sergiogallegos/tinyplc/docs/wire-layouts.md

# Generated wire layout tables

Source: [`contract/wire.json`](../contract/wire.json). Do not edit this file.
See [normative semantics](wire-format.md). Offsets are bytes, little-endian.

## package

| Field | Offset | Type / bytes |
| --- | --- | --- |
| magic | 0 | u32 |
| version | 4 | u16 |
| header_bytes | 6 | u16 |
| total_bytes | 8 | u32 |
| kind | 12 | u16 |
| target | 14 | u16 |
| native_abi | 16 | u16 |
| runtime_contract | 18 | u16 |
| auth | 20 | u16 |
| flags | 22 | u16 |
| link_base | 24 | u32 |
| payload_offset | 28 | u32 |
| payload_bytes | 32 | u32 |
| text_offset | 36 | u32 |
| text_bytes | 40 | u32 |
| entry_offset | 44 | u32 |
| tags_offset | 48 | u32 |
| tag_count | 52 | u16 |
| tag_record_bytes | 54 | u16 |
| cell_bytes | 56 | u16 |
| stack_bytes | 58 | u16 |
| schema_crc | 60 | u32 |
| package_crc | 64 | u32 |
| reserved | 68 | 12 |

Fixed size: 80 bytes.

## tag

| Field | Offset | Type / bytes |
| --- | --- | --- |
| name | 0 | 32 |
| type | 32 | u8 |
| class | 33 | u8 |
| binding | 34 | u16 |
| reserved | 36 | u32 |

Fixed size: 40 bytes.

## dispatch

| Field | Offset | Type / bytes |
| --- | --- | --- |
| entry | 0 | u32 |
| tag_count | 4 | u32 |
| generation | 8 | u32 |
| reserved | 12 | u32 |

Fixed size: 16 bytes.

## frame_prefix

| Field | Offset | Type / bytes |
| --- | --- | --- |
| start | 0 | u8 |
| length | 1 | u16 |
| command | 3 | u8 |

Fixed size: 4 bytes.

## slot

| Field | Offset | Type / bytes |
| --- | --- | --- |
| base | 0 | u32 |
| capacity | 4 | u32 |
| state | 8 | u8 |
| reserved | 9 | 3 |
| generation | 12 | u32 |

Fixed size: 16 bytes.

## tag_value

| Field | Offset | Type / bytes |
| --- | --- | --- |
| name | 0 | 32 |
| type | 32 | u8 |
| class | 33 | u8 |
| binding | 34 | u16 |
| value | 36 | u32 |

Fixed size: 40 bytes.

## info_request

| Field | Offset | Type / bytes |
| --- | --- | --- |

Fixed size: 0 bytes.

## info_response

| Field | Offset | Type / bytes |
| --- | --- | --- |
| status | 0 | u8 |
| protocol | 1 | u16 |
| package_version | 3 | u16 |
| target | 5 | u16 |
| native_abi | 7 | u16 |
| runtime_contract | 9 | u16 |
| auth | 11 | u16 |
| capabilities | 13 | u32 |
| command_mask | 17 | u32 |
| package_max | 21 | u32 |
| tag_limit | 25 | u16 |
| cell_bytes | 27 | u16 |
| stack_bytes | 29 | u16 |
| reserved | 31 | u16 |
| transfer_timeout_ms | 33 | u32 |
| transfer_id | 37 | u32 |
| next_offset | 41 | u32 |
| transfer_remaining_ms | 45 | u32 |
| slot_a | 49 | 16 |
| slot_b | 65 | 16 |

Fixed size: 81 bytes.

## download_begin_request

| Field | Offset | Type / bytes |
| --- | --- | --- |
| total_bytes | 0 | u32 |

Fixed size: 4 bytes.

## download_begin_response

| Field | Offset | Type / bytes |
| --- | --- | --- |
| status | 0 | u8 |
| transfer_id | 1 | u32 |
| slot_base | 5 | u32 |
| slot_capacity | 9 | u32 |
| timeout_ms | 13 | u32 |

Fixed size: 17 bytes.

## download_chunk_request

| Field | Offset | Type / bytes |
| --- | --- | --- |
| transfer_id | 0 | u32 |
| offset | 4 | u32 |

Fixed size: 8 bytes.

## download_chunk_response

| Field | Offset | Type / bytes |
| --- | --- | --- |
| status | 0 | u8 |
| next_offset | 1 | u32 |

Fixed size: 5 bytes.

## download_end_request

| Field | Offset | Type / bytes |
| --- | --- | --- |
| transfer_id | 0 | u32 |

Fixed size: 4 bytes.

## download_end_response

| Field | Offset | Type / bytes |
| --- | --- | --- |
| status | 0 | u8 |
| candidate_generation | 1 | u32 |

Fixed size: 5 bytes.

## activate_request

| Field | Offset | Type / bytes |
| --- | --- | --- |
| candidate_generation | 0 | u32 |

Fixed size: 4 bytes.

## activate_response

| Field | Offset | Type / bytes |
| --- | --- | --- |
| status | 0 | u8 |
| accepted_generation | 1 | u32 |

Fixed size: 5 bytes.

## rollback_request

| Field | Offset | Type / bytes |
| --- | --- | --- |

Fixed size: 0 bytes.

## rollback_response

| Field | Offset | Type / bytes |
| --- | --- | --- |
| status | 0 | u8 |
| accepted_generation | 1 | u32 |

Fixed size: 5 bytes.

## read_tags_request

| Field | Offset | Type / bytes |
| --- | --- | --- |
| generation | 0 | u32 |
| snapshot_scan | 4 | u64 |
| first_index | 12 | u8 |
| count | 13 | u8 |

Fixed size: 14 bytes.

## read_tags_response

| Field | Offset | Type / bytes |
| --- | --- | --- |
| status | 0 | u8 |
| generation | 1 | u32 |
| snapshot_scan | 5 | u64 |
| first_index | 13 | u8 |
| count | 14 | u8 |
| total_count | 15 | u8 |

Fixed size: 16 bytes.

## write_tag_request

| Field | Offset | Type / bytes |
| --- | --- | --- |
| generation | 0 | u32 |
| index | 4 | u8 |
| value | 5 | u32 |

Fixed size: 9 bytes.

## write_tag_response

| Field | Offset | Type / bytes |
| --- | --- | --- |
| status | 0 | u8 |
| generation | 1 | u32 |
| apply_after_scan | 5 | u64 |

Fixed size: 13 bytes.

## get_status_request

| Field | Offset | Type / bytes |
| --- | --- | --- |

Fixed size: 0 bytes.

## get_status_response

| Field | Offset | Type / bytes |
| --- | --- | --- |
| status | 0 | u8 |
| active_generation | 1 | u32 |
| scan | 5 | u64 |
| execution | 13 | u8 |
| outcome | 14 | u8 |
| reserved | 15 | u16 |
| requested_generation | 17 | u32 |
| pending_generation | 21 | u32 |
| fault | 25 | u32 |
| last_scan_us | 29 | u32 |
| max_scan_us | 33 | u32 |
| release_jitter_us | 37 | i32 |
| missed_releases | 41 | u64 |

Fixed size: 49 bytes.

## get_update_status_request

| Field | Offset | Type / bytes |
| --- | --- | --- |

Fixed size: 0 bytes.

## get_update_status_response

| Field | Offset | Type / bytes |
| --- | --- | --- |
| status | 0 | u8 |
| kind | 1 | u8 |
| phase | 2 | u8 |
| outcome | 3 | u8 |
| reserved | 4 | u8 |
| source_generation | 5 | u32 |
| requested_generation | 9 | u32 |
| failed_generation | 13 | u32 |
| first_fault | 17 | u32 |
| recovery_fault | 21 | u32 |
| line | 25 | u32 |
| column | 29 | u32 |
| failed_scan | 33 | u64 |
| completed_generation | 41 | u32 |
| completed_scan | 45 | u64 |

Fixed size: 53 bytes.

## Numeric constants

| Name | Value |
| --- | --- |
| PACKAGE_MAGIC | 1313034324 |
| PACKAGE_VERSION | 1 |
| IMAGE_NATIVE | 1 |
| TARGET_F446 | 1 |
| NATIVE_ABI | 2 |
| RUNTIME_CONTRACT | 1 |
| AUTH_UNSIGNED_LAB | 0 |
| SLOT_A_BASE | 536936448 |
| SLOT_B_BASE | 536952832 |
| CODE_CAPACITY | 16384 |
| TAG_LIMIT | 64 |
| CELL_BYTES | 4 |
| WORKER_STACK_BYTES | 2048 |
| TYPE_BOOL | 1 |
| TYPE_DINT | 2 |
| CLASS_INPUT | 1 |
| CLASS_OUTPUT | 2 |
| CLASS_VAR | 3 |
| BINDING_NONE | 0 |
| BINDING_BTN_PC13 | 1 |
| BINDING_LED_PA5 | 2 |
| FRAME_START | 165 |
| PROTOCOL_VERSION | 1 |
| FRAME_LENGTH_MIN | 1 |
| FRAME_LENGTH_MAX | 257 |
| FRAME_BYTES_MAX | 262 |
| CHUNK_BYTES_MAX | 240 |
| TAG_PAGE_LIMIT | 5 |
| FRAME_TIMEOUT_MS | 100 |
| TRANSFER_TIMEOUT_MS | 30000 |
| SNAPSHOT_TIMEOUT_MS | 2000 |
| RESPONSE_BIT | 128 |
| DISPATCH_INPUT_OFFSET | 256 |
| SLOT_EMPTY | 0 |
| SLOT_ACTIVE | 1 |
| SLOT_RECEIVING | 2 |
| SLOT_READY | 3 |
| SLOT_PENDING | 4 |
| SLOT_PREVIOUS | 5 |
| EXEC_STOPPED | 0 |
| EXEC_RUNNING | 1 |
| EXEC_FAULT | 2 |
| OUTCOME_NONE | 0 |
| OUTCOME_PENDING | 1 |
| OUTCOME_RUNNING | 2 |
| OUTCOME_REJECTED | 3 |
| OUTCOME_ROLLED_BACK | 4 |
| CAP_UNSIGNED_LAB | 1 |
| CAP_ONLINE_MIGRATION | 2 |
| CAP_ROLLBACK | 4 |
| CAP_WRITE_TAG | 8 |
| STATUS_OK | 0 |
| STATUS_BAD_REQUEST | 1 |
| STATUS_CRC_ERROR | 2 |
| STATUS_BUSY | 3 |
| STATUS_INVALID_IMAGE | 4 |
| STATUS_NO_PROGRAM | 5 |
| STATUS_NOT_WRITABLE | 6 |
| STATUS_FAULT | 7 |
| STATUS_UNSUPPORTED | 8 |
| CMD_INFO | 1 |
| CMD_DOWNLOAD_BEGIN | 2 |
| CMD_DOWNLOAD_CHUNK | 3 |
| CMD_DOWNLOAD_END | 4 |
| CMD_ACTIVATE | 5 |
| CMD_ROLLBACK | 6 |
| CMD_READ_TAGS | 7 |
| CMD_WRITE_TAG | 8 |
| CMD_GET_STATUS | 9 |
| PACKAGE_BYTES_MAX | 19024 |
| CRC32_POLY_REFLECTED | 3988292384 |
| CRC32_INIT | 4294967295 |
| CRC32_XOROUT | 4294967295 |
| CRC32_CHECK | 3421780262 |
| CRC16_POLY | 4129 |
| CRC16_INIT | 65535 |
| CRC16_XOROUT | 0 |
| CRC16_CHECK | 10673 |
| CMD_GET_UPDATE_STATUS | 10 |
| UPDATE_NONE | 0 |
| UPDATE_ACTIVATE | 1 |
| UPDATE_ROLLBACK | 2 |
| UPDATE_IDLE | 0 |
| UPDATE_QUEUED | 1 |
| UPDATE_TRIAL | 2 |
| UPDATE_RECOVERY_QUEUED | 3 |
| UPDATE_RECOVERY_TRIAL | 4 |
| UPDATE_COMPLETE | 5 |
| TYPE_TIME | 3 |
| CLASS_TIMER | 4 |
| BINDING_CLOCK_MS | 3 |
