sergiogallegos/tinyplc/hardware/prototype-a1/brochure/tinyplc-a1-brochure.pdf

Small controller.
Open to exploration.

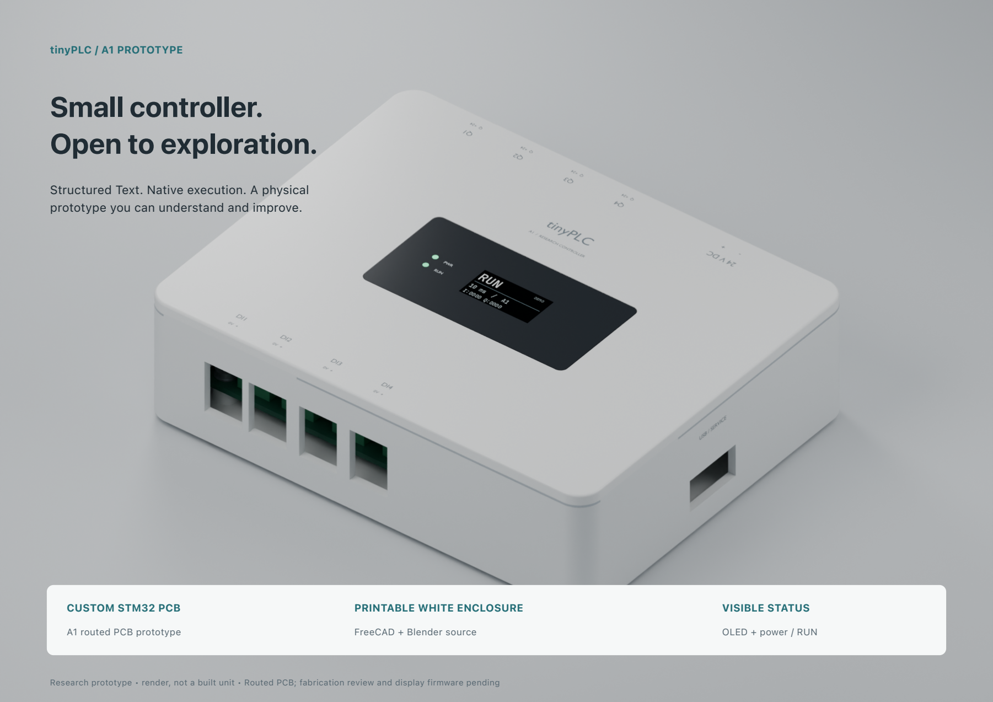
[picture p3: page 1]

tinyPLC / A1

A1 prototype • CAD renders • not a fabrication release • 2026-10-24 | 01

tinyPLC / A1 PROTOTYPE

### Structured Text. Native execution. A physical

prototype you can understand and improve.

CUSTOM STM32 PCB | PRINTABLE WHITE ENCLOSURE | VISIBLE STATUS
A1 routed PCB prototype | FreeCAD + Blender source | OLED + power / RUN

Research prototype • render, not a built unit • Routed PCB; fabrication review and display firmware pending

DESIGN / SOFT GEOMETRY, CLEAR PURPOSE
A quieter industrial object.

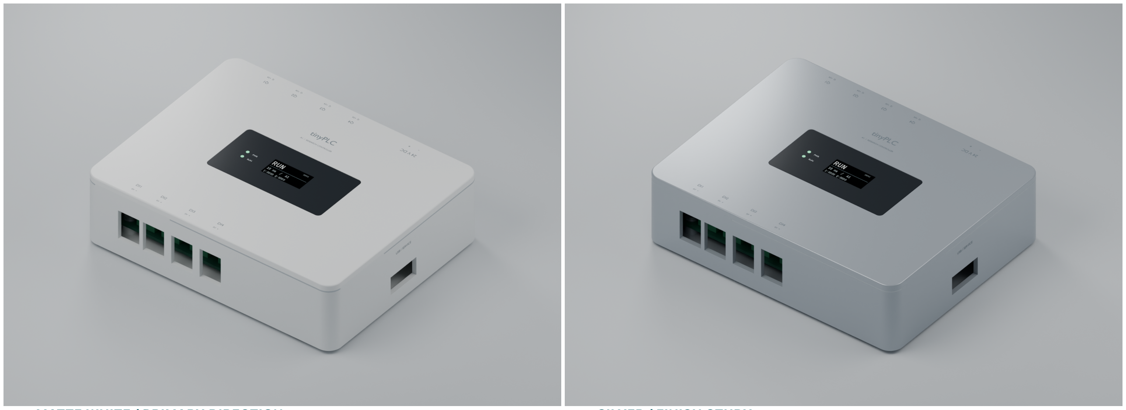
[picture p4: figure]

A1 prototype • CAD renders • not a fabrication release • 2026-10-24 | 02

A rounded white shell, a restrained black interface and a narrow silver seam. The prototype is designed to be pleasant on a desk and practical to open.

MATTE WHITE / PRIMARY DIRECTION | SILVER / FINISH STUDY
Printed polymer. 140 × 110 × 37 mm before feet and switch projection. Soft corners and a clean top surface. | The same geometry with a silver-colored finish. This is not a machined aluminum enclosure or grounded metal chassis.

INTERFACE / SMALL DISPLAY, USEFUL SIGNALS
Understand the state at a glance.

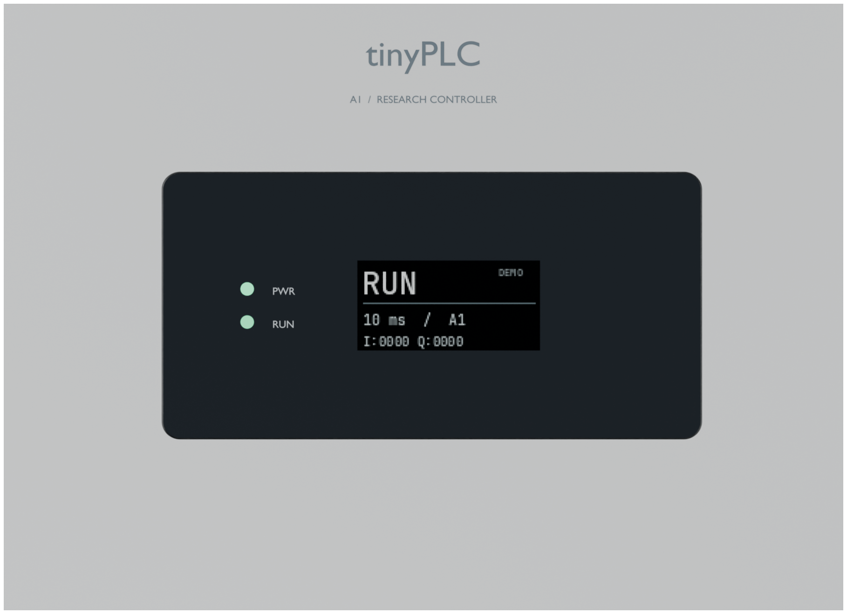
[picture p5: figure]

A1 prototype • CAD renders • not a fabrication release • 2026-10-24 | 03

### PWR

A hardware LED follows the 3.3 V rail, independently of firmware.

### RUN

A proposed heartbeat follows accepted scan progress. A live UI task alone must not assert RUN.

### OLED

128 × 64 monochrome status: RUN, STOP or FAULT, scan period and an I/O snapshot.

The screen is deliberately small and non-touch. The displayed DEMO content is a UI proposal; the A1 OLED driver and status integration still need implementation.

CONNECTIONS / LABELS THAT FOLLOW THE SCHEMATIC
Power is explicit. Wiring stays legible.

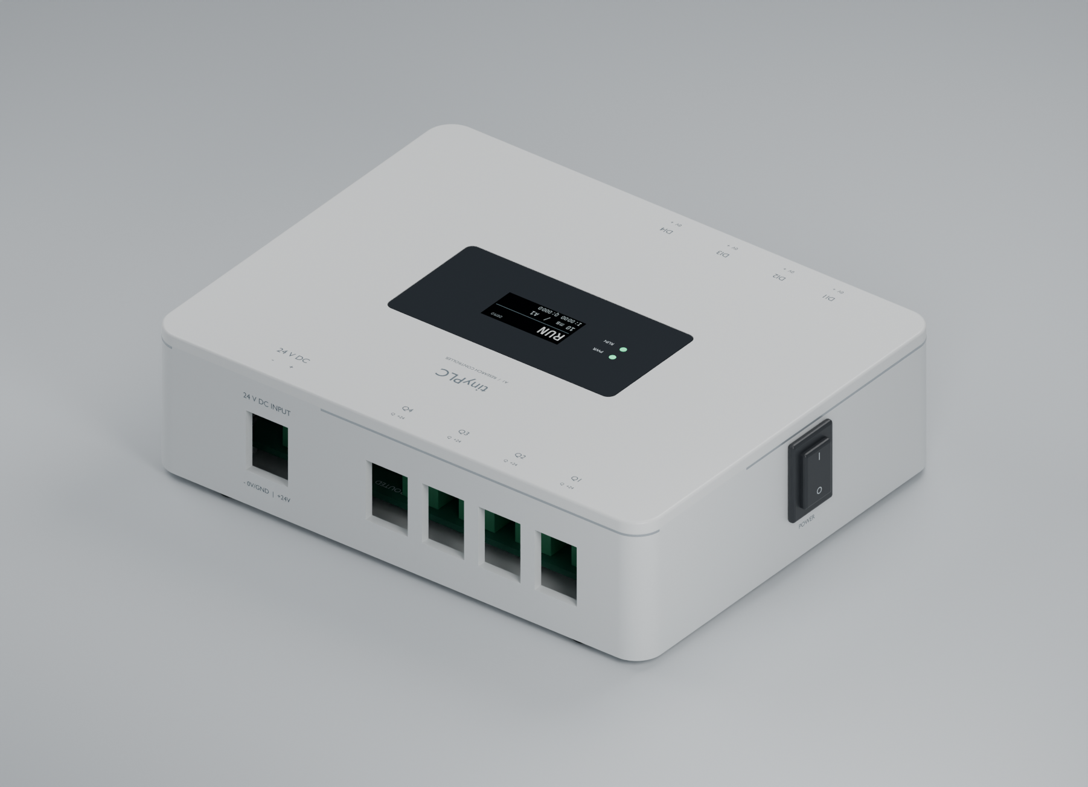
[picture p6: figure]

A1 prototype • CAD renders • not a fabrication release • 2026-10-24 | 04

### 24 V DC INPUT

J1.1: +24 V. J1.2: 0 V / GND (−). GND is the circuit return, not protective earth.

### PHYSICAL ON / OFF

A maintained side rocker opens the fused positive feed to the controller and output bus.

### FOUR IN / FOUR OUT

Four conditioned input channels and four sinking output channels. Electrical ratings remain test targets.

USB is a service/data connection, not the supply. The shared-ground board is not isolated. OFF is not an all-signal disconnect; remove external sources before servicing.

HARDWARE / STM32F446 CONTROLLER ARCHITECTURE
One custom board. Clear responsibilities.

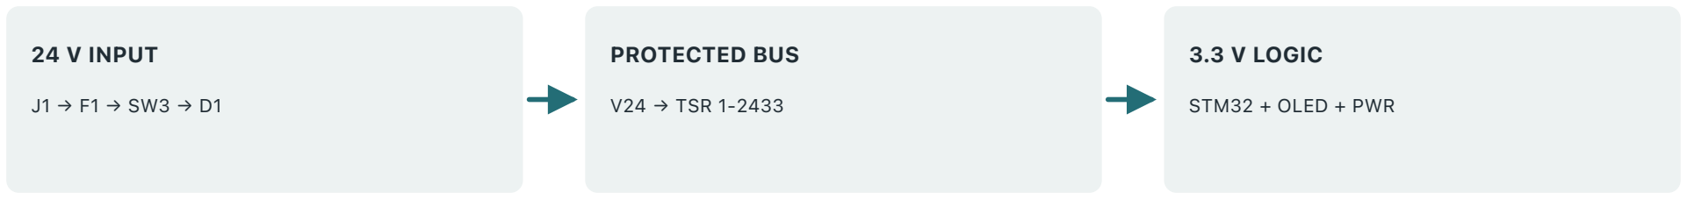
[picture p7: figure]
24 V INPUT; PROTECTED BUS; V24 → TSR 1-2433; 3.3 V LOGIC; STM32 + OLED + PWR
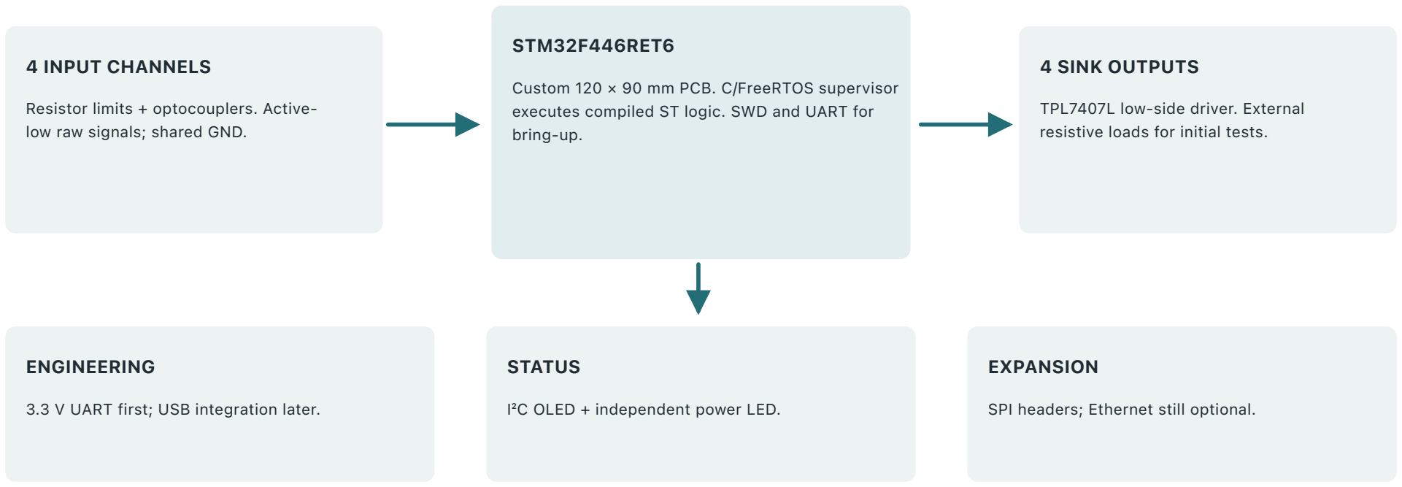
[picture p8: figure]
4 INPUT CHANNELS; Resistor limits + optocouplers. Active- low raw signals; shared GND.; STM32F446RET6; bring-up.; 4 SINK OUTPUTS; TPL7407L low-side driver. External resistive loads for initial tests.; ENGINEERING; STATUS; I²C OLED + independent power LED.; EXPANSION; SPI headers; Ethernet still optional.

A1 prototype • CAD renders • not a fabrication release • 2026-10-24 | 05

Custom 120 × 90 mm PCB. C/FreeRTOS supervisor executes compiled ST logic. SWD and UART for

3.3 V UART first; USB integration later.

Block diagram describes the intended A1 hardware. PCB routing is complete; manufacturing release and hardware qualification remain pending.

SOFTWARE / STRUCTURED TEXT TO NATIVE ARM CODE
Compile on the PC. Execute on the controller.

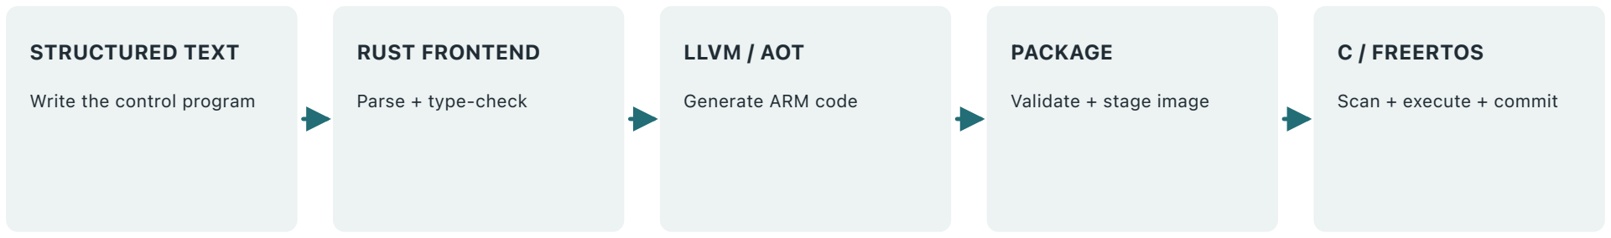
[picture p9: figure]
STRUCTURED TEXT; Write the control program; RUST FRONTEND; Parse + type-check; LLVM / AOT; Generate ARM code; PACKAGE; Validate + stage image; C / FREERTOS; Scan + execute + commit

A1 prototype • CAD renders • not a fabrication release • 2026-10-24 | 06

### IMPLEMENTED ON THE NUCLEO BASELINE

Native execution, serial download and explicit activation; coherent monitoring; compatible state migration, trial and rollback; TON on-delay timers.

### A1 INTEGRATION STILL TO DO

Standalone clock and pin setup, four-channel I/O validation, OLED driver and heartbeat ownership. Native USB and Ethernet are not ready-to-use A1 features.

The supervisor owns physical I/O and fault handling. User logic runs in a restricted native worker. The UI must consume snapshots at lower priority, with bounded I²C transactions.

Target scan period: 10 ms. Existing measured evidence is for NUCLEO-F446RE; A1 timing must be measured separately.

BUILD / INSPECT, PRINT, ASSEMBLE, ITERATE
The files are part of the product.

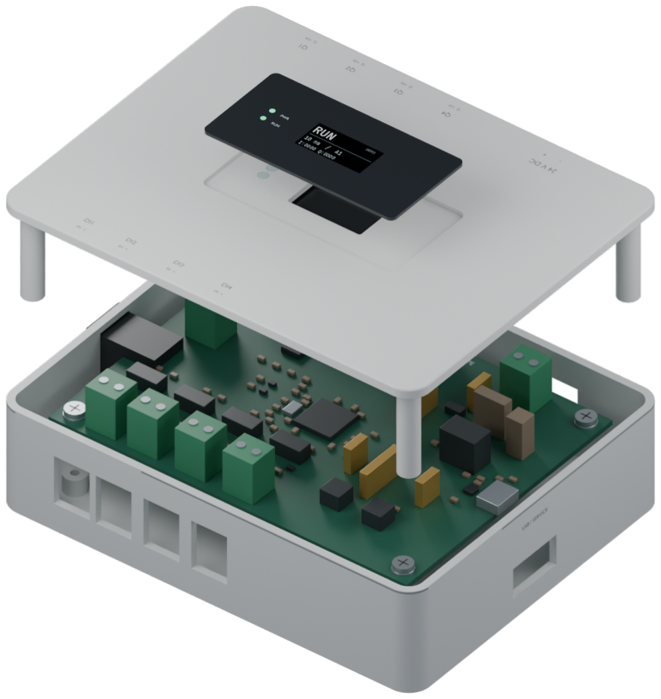
[picture p10: figure]

A1 prototype • CAD renders • not a fabrication release • 2026-10-24 | 07

### 01 / INSPECT

KiCad schematic, custom PCB, per-item BOM and design decisions explain the electronics.

### 02 / PRINT + FIT

FreeCAD, STEP and oriented STLs provide the shell, display mount, optical sleeves and
fit coupon.

### 03 / ASSEMBLE

Illustrated instructions, dimensioned drawings, label artwork and harness mappings keep the build traceable.

Every product view in this brochure comes from the editable Blender scene built from the CAD geometry. Package bodies and switch details are simplified envelopes.

READINESS / WHAT YOU CAN CONSTRUCT TODAY
A prototype with a clear next step.

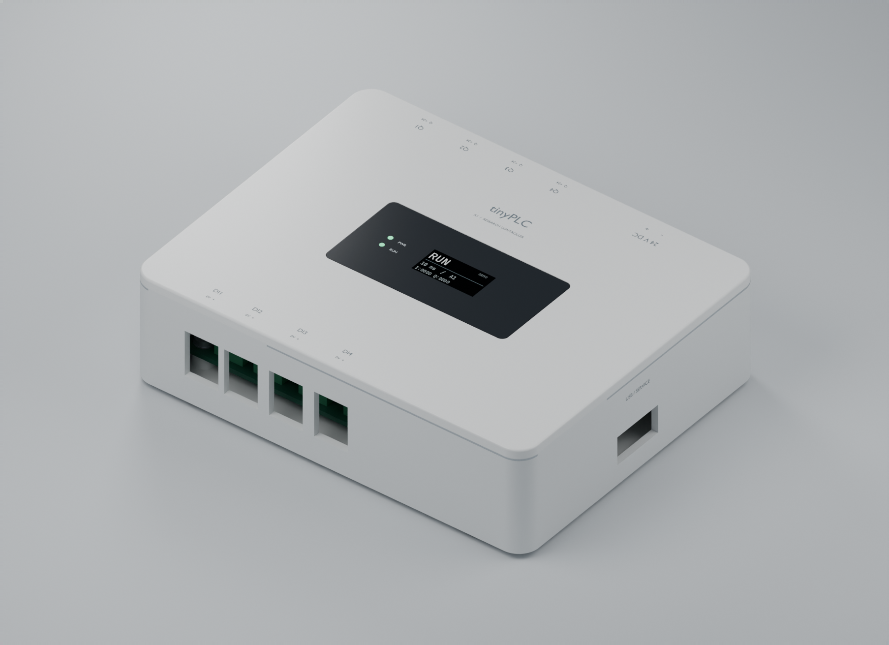
[picture p11: figure]

A1 prototype • CAD renders • not a fabrication release • 2026-10-24 | 08

### READY TO EXPLORE

Inspect the custom board and schematic. Print the coupon and case for fit trials. Try the compiler, host simulation and documented Nucleo workflow. Review the proposed OLED interface.

### BEFORE BOARD ORDER

Review the routed PCB. Resolve exact capacitor and hardware SKUs. Review power, I/O, ground returns and fabrication constraints. Inspect manufacturing outputs independently.

### BEFORE A WORKING A1

Build and test the board in stages. Port the firmware. Integrate the OLED and status logic. Validate switch wiring, optical alignment, thermal behavior and physical outputs.

## Start with hardware/prototype-a1/README.md

It links the native CAD, BOM, assembly guide, construction drawings, design rationale and this brochure. A0 remains available for comparison.

Research and education only. No certified machine-control or safety use. Downloaded programs currently do not persist across reset.

github.com/sergiogallegos/tinyplc
