sergiogallegos/tinyplc/hardware/prototype-a1/mechanical/drawings/05-applied-labels.pdf

CONSTRUCTION / A1 / mm / ACTUAL SIZE A4 / CAD FIT ONLY

# 05 Applied label master / front-view orientation

A1 prototype • CAD renders • not a fabrication release • 2026-10-24 | 05

100 mm — verify printed scale

## tinyPLC

A1 / RESEARCH CONTROLLER

DI1

0V +

DI2

0V +

DI3

0V +

DI4

0V +

Outline is an alignment reference, not part of the label.

Separate side labels below. No protective-earth symbol: 0 V/GND is the shared DC return, not PE.

24 V DC INPUT

− 0V/GND | +24V

USB / SERVICE

POWER

The lens mask is a separate 64 × 32 mm SVG. Mask artwork is a front view: reverse/mirror for reverse-side printing, keeping viewing windows clear.
