sergiogallegos/tinyplc/hardware/prototype-a/mechanical/drawings/assembly-pages/03-hardware.pdf

tinyPLC / A0 VISUAL ASSEMBLY | INVENTORY / NOMINAL HARDWARE

# Sort the screws before you start

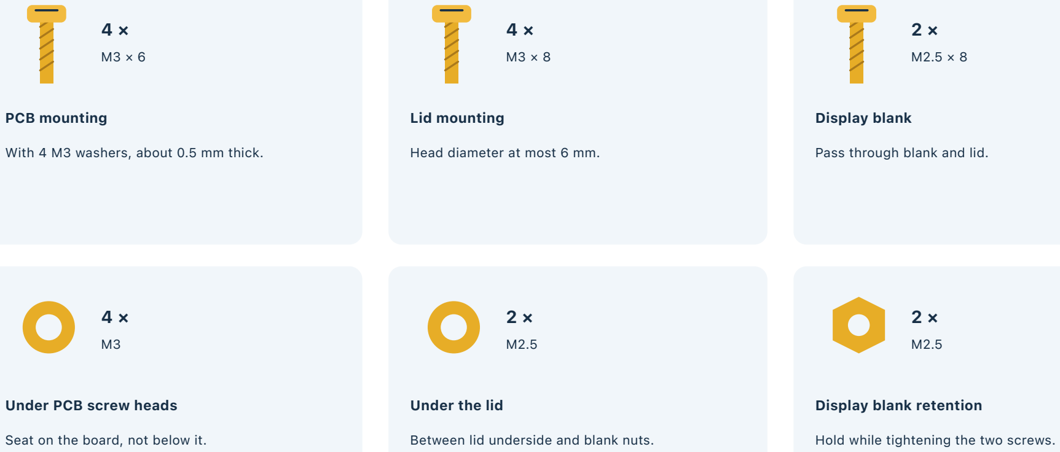
[picture p12: figure]
PCB mounting; With 4 M3 washers, about 0.5 mm thick.; Lid mounting; Head diameter at most 6 mm.; Display blank; Pass through blank and lid.; Under PCB screw heads; Seat on the board, not below it.; Under the lid; Between lid underside and blank nuts.; Display blank retention; Hold while tightening the two screws.

A0 • CAD illustrations, not assembly photos • physical fit untested • images not to scale | 03

Tools: ruler, deburring tool, M3 × 0.5 hand tap, suitable hand screwdriver and a small nut driver. Confirm actual screw drawings and fit on the coupon; no tightening torque is qualified.
