sergiogallegos/tinyplc/hardware/prototype-a1/electronics/archive-unrouted/README.md

# Historical A1 placement snapshot

These files preserve the earlier unrouted draft, including its missing DI1-to-PA0
connection. They are not current build files. The corrected, routed project is
one directory above. Library snapshots are in that parent directory.
