sergiogallegos/tinyplc/hardware/prototype-a1/renders/exploded.png

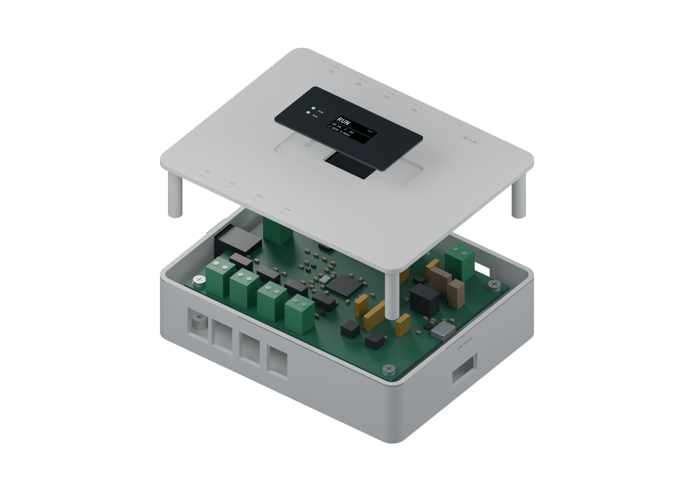
hardware/prototype-a1/renders/exploded.png
