sergiogallegos/tinyplc/hardware/prototype-a1/renders/fault-detail.png

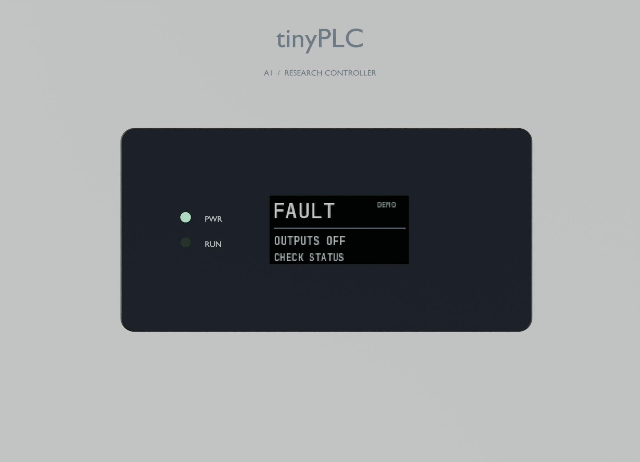
hardware/prototype-a1/renders/fault-detail.png
