sergiogallegos/tinyplc/hardware/prototype-a1/renders/hero-silver.png

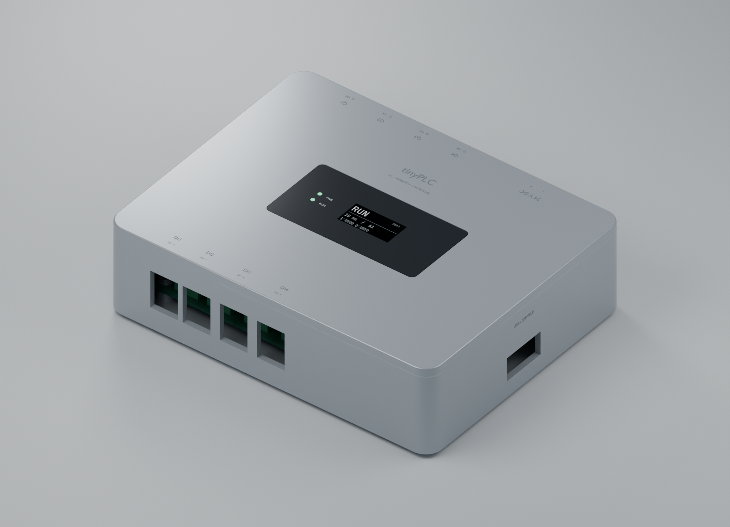
hardware/prototype-a1/renders/hero-silver.png
