sergiogallegos/tinyplc/hardware/prototype-a1/renders/pcb-routed-bottom.png

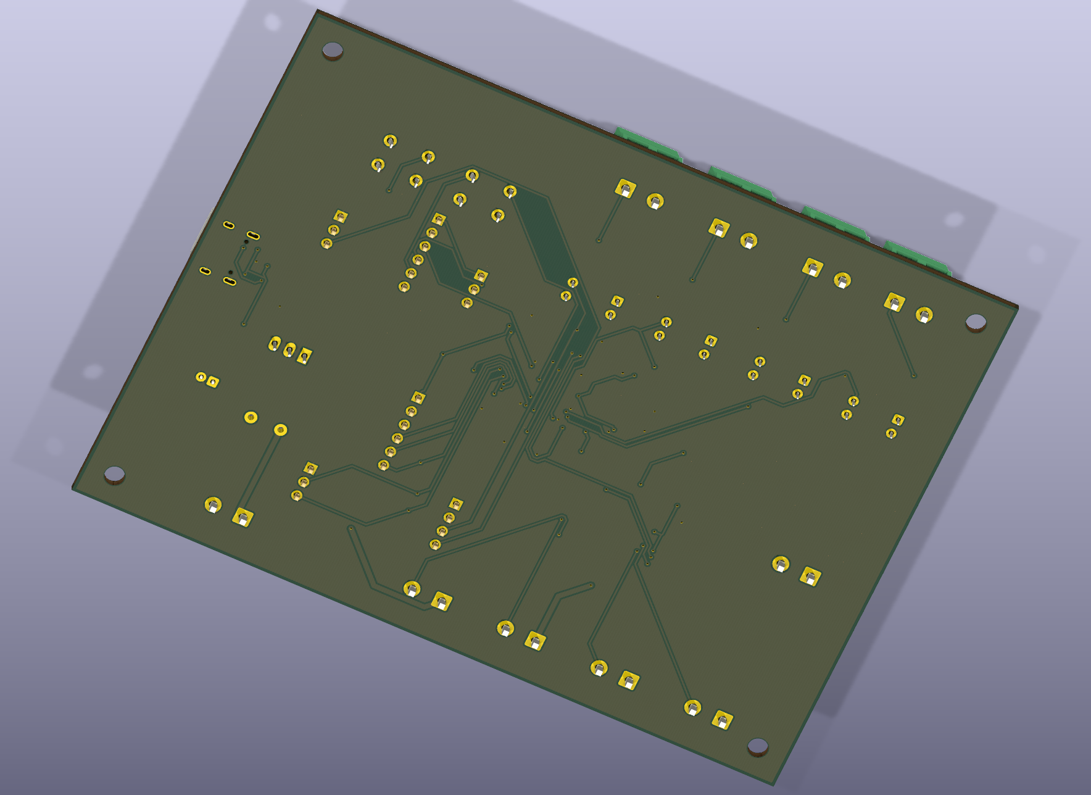
hardware/prototype-a1/renders/pcb-routed-bottom.png
