sergiogallegos/tinyplc/hardware/prototype-a1/renders/underside.png

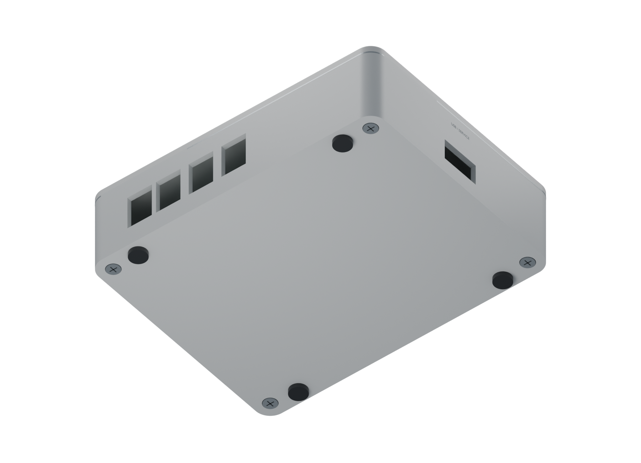
hardware/prototype-a1/renders/underside.png
