sergiogallegos/tinyplc/hardware/prototype-a/renders/assembly/00-overview.png

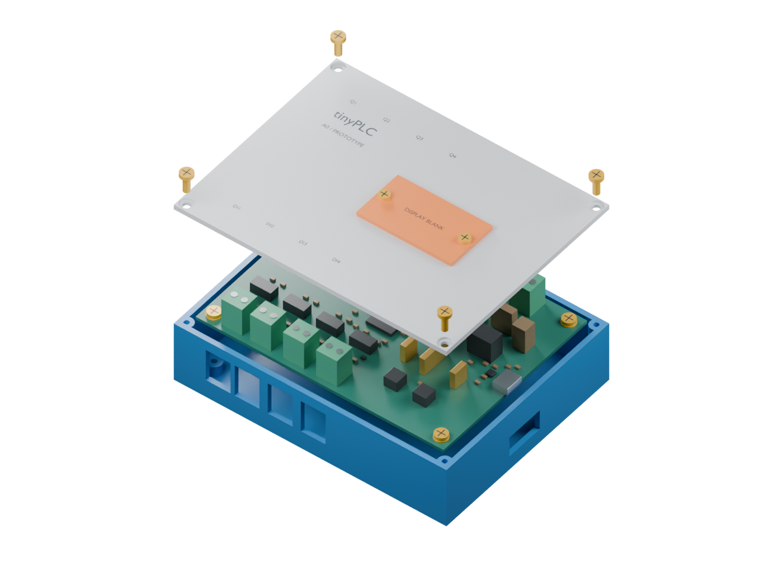
hardware/prototype-a/renders/assembly/00-overview.png
