sergiogallegos/tinyplc/hardware/prototype-a/renders/tinyplc-a0-exploded.png

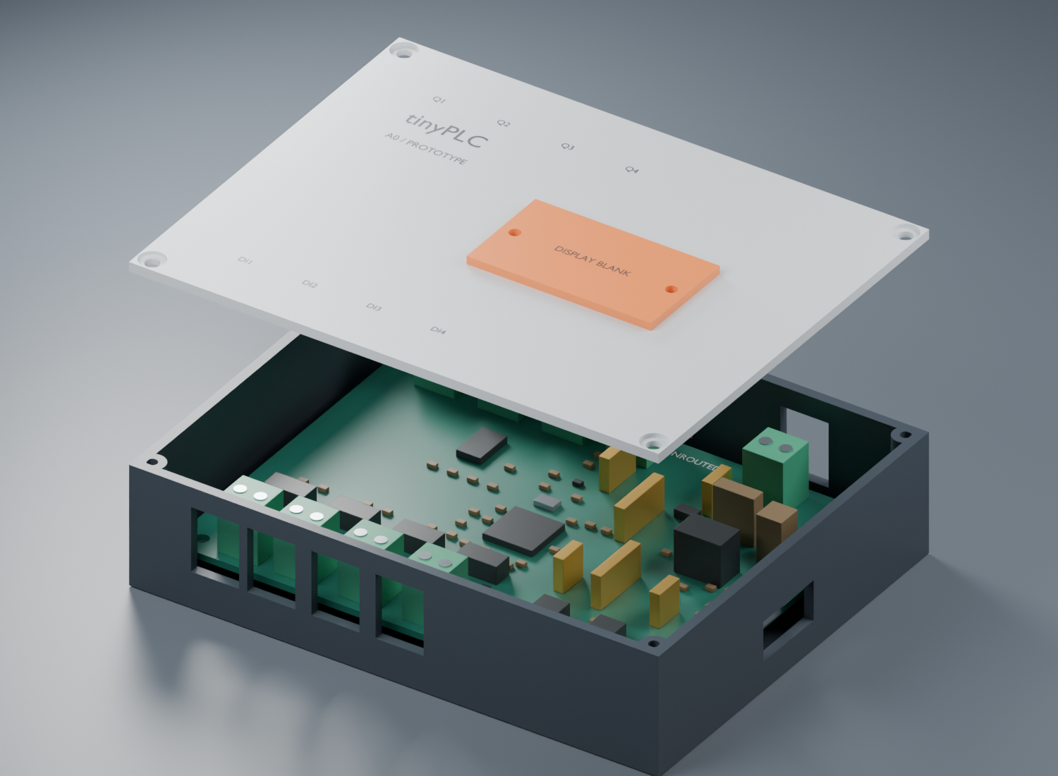
hardware/prototype-a/renders/tinyplc-a0-exploded.png
