sergiogallegos/tinyplc/hardware/prototype-a/mechanical/drawings/assembly-pages/02-large-parts.pdf

tinyPLC / A0 VISUAL ASSEMBLY | INVENTORY / MATCH THE A0 REVISION

# Lay out the large parts

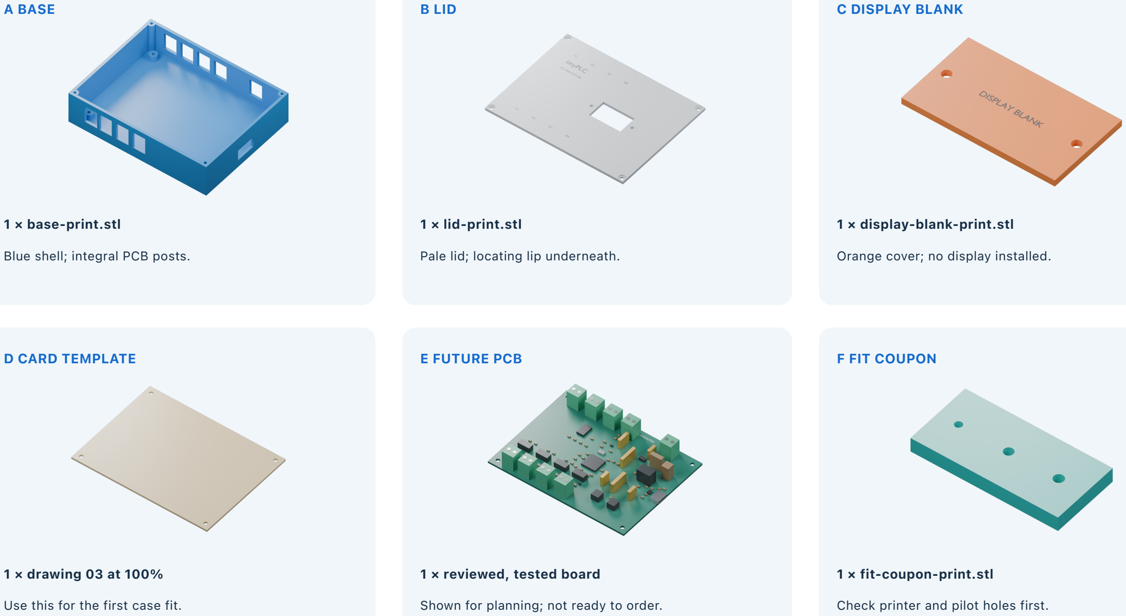
[picture p20: figure]
A BASE; 1 × base-print.stl; Blue shell; integral PCB posts.; B LID; 1 × lid-print.stl; Pale lid; locating lip underneath.; C DISPLAY BLANK; 1 × display-blank-print.stl; Orange cover; no display installed.; D CARD TEMPLATE; 1 × drawing 03 at 100%; Use this for the first case fit.; E FUTURE PCB; 1 × reviewed, tested board; Shown for planning; not ready to order.; F FIT COUPON; 1 × fit-coupon-print.stl; Check printer and pilot holes first.

A0 • CAD illustrations, not assembly photos • physical fit untested • images not to scale | 02
