sergiogallegos/tinyplc/hardware/prototype-a1/mechanical/drawings/assembly-pages/02-inventory.pdf

INVENTORY / USE THE MATCHING A1 BOM
Lay out the parts.
A1 prototype • CAD renders • not a fabrication release • 2026-10-24 | 02

### Printed parts

1 base + 1 lid + 1 fit coupon. Print STLs already have bed orientation.

### Board retention

4 × M3 × 6 screws; 4 × M3 washers, nominal 0.5 mm thick.

### Case retention

4 × M3 × 10 screws from below; 4 adhesive feet, nominal 8 × 2 mm.

### Status optics

1 lens, 64 × 32 × 1; reverse black mask; 2 clear Ø3 × 24.6 rods.

### OLED module

1 Adafruit 326 QT; 4 × M2 × 6 screws; 4 × M2 washers; 1 four-wire harness.

### Power switch

1 C&K D102J12S215HQA candidate; 2 insulated leads with matching quick-connects.

Prepare a ruler, suitable hand screwdriver, M3/M2 taps, crimp tool and multimeter. Try actual hardware on the coupon before printing the whole case.
