sergiogallegos/tinyplc/hardware/prototype-a/bom/electronics.csv

quantity | ref | value | mpn | footprint | group | purpose | official_document | status
1 | J1 | 24V IN / GND | 1715721 | tinyplc:TerminalBlock_Phoenix_MKDS-1,5-2-5.08_1x02_P5.08mm_Horizontal | Power | 24V IN / GND | https://www.phoenixcontact.com/en-us/products/pcb-terminal-block-mkds-15-2-508-1715721 | candidate; verify before purchase
1 | F1 | 500mA / 60V | MF-R050 | tinyplc:PTC_MF_R050 | Power | Resettable input fuse; slow overload protection | https://www.bourns.com/docs/product-datasheets/mf-r.pdf | candidate; verify before purchase
1 | D1 | SS16 | SS16 | tinyplc:D_SMA | Power | Series reverse-polarity diode | https://www.diodes.com/datasheet/download/ds13003.pdf | candidate; verify before purchase
1 | U2 | TSR 1-2433 | TSR 1-2433 | tinyplc:Converter_DCDC_TRACO_TSR-1_THT | Power | 24 V to 3.3 V switching supply | https://www.tracopower.com/tsr1-datasheet | candidate; verify before purchase
1 | C1 | 22uF / 50V | Panasonic EEU-FR1H220 | tinyplc:CP_Radial_D6.3mm_P2.50mm | Power | Input reservoir; polarity matters | https://industrial.panasonic.com/cdbs/www-data/pdf/RDF0000/ABA0000C1015.pdf | candidate; verify before purchase
1 | C2 | 100nF / 50V | TDK C2012 family; exact MPN pending | tinyplc:C_0805_2012Metric | Power | High-frequency input bypass | https://product.tdk.com/en/products/capacitor/ceramic/mlcc/characteristic/ | specification only; exact MPN pending
1 | C3 | 10uF / 10V | TDK C2012 family; exact MPN pending | tinyplc:C_0805_2012Metric | Power | 3V3 reservoir | https://product.tdk.com/en/products/capacitor/ceramic/mlcc/characteristic/ | specification only; exact MPN pending
1 | U1 | STM32F446RET6 | STM32F446RET6 | tinyplc:LQFP-64_10x10mm_P0.5mm | MCU | Native ST processor; internal regulator ON | https://www.st.com/resource/en/datasheet/stm32f446re.pdf | candidate; verify before purchase
1 | C4 | 100nF / 50V | TDK C2012 family; exact MPN pending | tinyplc:C_0805_2012Metric | MCU | One local bypass per VDD pin | https://product.tdk.com/en/products/capacitor/ceramic/mlcc/characteristic/ | specification only; exact MPN pending
1 | C5 | 100nF / 50V | TDK C2012 family; exact MPN pending | tinyplc:C_0805_2012Metric | MCU | One local bypass per VDD pin | https://product.tdk.com/en/products/capacitor/ceramic/mlcc/characteristic/ | specification only; exact MPN pending
1 | C6 | 100nF / 50V | TDK C2012 family; exact MPN pending | tinyplc:C_0805_2012Metric | MCU | One local bypass per VDD pin | https://product.tdk.com/en/products/capacitor/ceramic/mlcc/characteristic/ | specification only; exact MPN pending
1 | C7 | 100nF / 50V | TDK C2012 family; exact MPN pending | tinyplc:C_0805_2012Metric | MCU | One local bypass per VDD pin | https://product.tdk.com/en/products/capacitor/ceramic/mlcc/characteristic/ | specification only; exact MPN pending
1 | C8 | 4.7uF / 10V | TDK C2012 family; exact MPN pending | tinyplc:C_0805_2012Metric | MCU | Single VCAP package requires 4.7uF low ESR; never a power output | https://product.tdk.com/en/products/capacitor/ceramic/mlcc/characteristic/ | specification only; exact MPN pending
1 | C9 | 4.7uF / 10V | TDK C2012 family; exact MPN pending | tinyplc:C_0805_2012Metric | MCU | MCU local bulk capacitance | https://product.tdk.com/en/products/capacitor/ceramic/mlcc/characteristic/ | specification only; exact MPN pending
1 | R1 | 22 | ERJ-6ENF22R0V | tinyplc:R_0805_2012Metric | MCU | Analog supply RC filter; verify VDDA drop | https://industrial.panasonic.com/cdbs/www-data/pdf/RDA0000/AOA0000C307.pdf | candidate; verify before purchase
1 | C10 | 100nF / 50V | TDK C2012 family; exact MPN pending | tinyplc:C_0805_2012Metric | MCU | VDDA high-frequency bypass | https://product.tdk.com/en/products/capacitor/ceramic/mlcc/characteristic/ | specification only; exact MPN pending
1 | C11 | 1uF / 10V | TDK C2012 family; exact MPN pending | tinyplc:C_0805_2012Metric | MCU | VDDA low-frequency bypass | https://product.tdk.com/en/products/capacitor/ceramic/mlcc/characteristic/ | specification only; exact MPN pending
1 | R2 | 10k | ERJ-6ENF1002V | tinyplc:R_0805_2012Metric | MCU | Reset pull-up | https://industrial.panasonic.com/cdbs/www-data/pdf/RDA0000/AOA0000C307.pdf | candidate; verify before purchase
1 | C12 | 100nF / 50V | TDK C2012 family; exact MPN pending | tinyplc:C_0805_2012Metric | MCU | Reset noise filter | https://product.tdk.com/en/products/capacitor/ceramic/mlcc/characteristic/ | specification only; exact MPN pending
1 | R3 | 10k | ERJ-6ENF1002V | tinyplc:R_0805_2012Metric | MCU | Normal boot from user flash | https://industrial.panasonic.com/cdbs/www-data/pdf/RDA0000/AOA0000C307.pdf | candidate; verify before purchase
1 | R4 | 10k | ERJ-6ENF1002V | tinyplc:R_0805_2012Metric | MCU | Bootloader mode selection pull-down | https://industrial.panasonic.com/cdbs/www-data/pdf/RDA0000/AOA0000C307.pdf | candidate; verify before purchase
1 | J2 | BOOT: 1=3V3 2=BOOT0 3=GND | Samtec TSW-103-07-G-S | tinyplc:PinHeader_1x03_P2.54mm_Vertical | MCU | Momentary shunt 1-2 only for ROM recovery | https://www.samtec.com/products/tsw | candidate; verify before purchase
1 | J3 | SWD: 3V3 GND DIO CLK NRST SWO | Samtec TSW-106-07-G-S | tinyplc:PinHeader_1x06_P2.54mm_Vertical | MCU | Custom 2.54mm SWD header; pin 6 unconnected | https://www.samtec.com/products/tsw | candidate; verify before purchase
1 | J4 | UART: GND TX RX | Samtec TSW-103-07-G-S | tinyplc:PinHeader_1x03_P2.54mm_Vertical | MCU | 3.3V UART recovery and existing engineering transport | https://www.samtec.com/products/tsw | candidate; verify before purchase
1 | Y1 | 8MHz CL18pF | ABM3-8.000MHZ-B2-T | tinyplc:Crystal_SMD_5032-2Pin_5.0x3.2mm | MCU | Independent HSE; Nucleo ST-LINK clock is absent | https://abracon.com/Resonators/abm3.pdf | candidate; verify before purchase
1 | C13 | 27pF C0G / 50V | TDK C2012 family; exact MPN pending | tinyplc:C_0805_2012Metric | MCU | Provisional crystal loading; tune using parasitics | https://product.tdk.com/en/products/capacitor/ceramic/mlcc/characteristic/ | specification only; exact MPN pending
1 | C14 | 27pF C0G / 50V | TDK C2012 family; exact MPN pending | tinyplc:C_0805_2012Metric | MCU | Provisional crystal loading; tune using parasitics | https://product.tdk.com/en/products/capacitor/ceramic/mlcc/characteristic/ | specification only; exact MPN pending
1 | SW1 | RESET | Omron B3F-1000 | tinyplc:SW_PUSH_6mm | MCU | Reset button under service lid | https://components.omron.com/sites/default/files/datasheet_pdf/A070-E1.pdf | candidate; verify before purchase
1 | SW2 | USER | Omron B3F-1000 | tinyplc:SW_PUSH_6mm | MCU | Active-low user input under service lid | https://components.omron.com/sites/default/files/datasheet_pdf/A070-E1.pdf | candidate; verify before purchase
1 | R5 | 10k | ERJ-6ENF1002V | tinyplc:R_0805_2012Metric | MCU | User button pull-up | https://industrial.panasonic.com/cdbs/www-data/pdf/RDA0000/AOA0000C307.pdf | candidate; verify before purchase
1 | D2 | GREEN | Kingbright KP-2012SGC | tinyplc:LED_0805_2012Metric | MCU | PA5 status LED; preserves existing output test concept | https://www.kingbrightusa.com/images/catalog/SPEC/KP-2012SGC.pdf | candidate; verify before purchase
1 | R6 | 1k | ERJ-6ENF1001V | tinyplc:R_0805_2012Metric | MCU | Approximately 1mA LED current | https://industrial.panasonic.com/cdbs/www-data/pdf/RDA0000/AOA0000C307.pdf | candidate; verify before purchase
1 | J5 | DI1 / GND | 1715721 | tinyplc:TerminalBlock_Phoenix_MKDS-1,5-2-5.08_1x02_P5.08mm_Horizontal | Input 1 | DI1 / GND | https://www.phoenixcontact.com/en-us/products/pcb-terminal-block-mkds-15-2-508-1715721 | candidate; verify before purchase
1 | R10 | 2.2k | ERJ-6ENF2201V | tinyplc:R_0805_2012Metric | Input 1 | First half of input LED current limiter | https://industrial.panasonic.com/cdbs/www-data/pdf/RDA0000/AOA0000C307.pdf | candidate; verify before purchase
1 | R11 | 2.2k | ERJ-6ENF2201V | tinyplc:R_0805_2012Metric | Input 1 | Second half of input limiter; shares dissipation | https://industrial.panasonic.com/cdbs/www-data/pdf/RDA0000/AOA0000C307.pdf | candidate; verify before purchase
1 | U4 | VO617A-3 | VO617A-3 | tinyplc:DIP-4_W7.62mm | Input 1 | 24V-present signal becomes active-low 3V3 GPIO | https://www.vishay.com/docs/83430/vo617a.pdf | candidate; verify before purchase
1 | D11 | 1N4148W | 1N4148W | tinyplc:D_SOD-123 | Input 1 | Antiparallel diode protects optocoupler LED against reverse input | https://assets.nexperia.com/documents/data-sheet/1N4148W_1N4448W.pdf | candidate; verify before purchase
1 | R12 | 10k | ERJ-6ENF1002V | tinyplc:R_0805_2012Metric | Input 1 | Collector pull-up sets GPIO HIGH when input is off | https://industrial.panasonic.com/cdbs/www-data/pdf/RDA0000/AOA0000C307.pdf | candidate; verify before purchase
1 | C21 | 10nF / 50V | TDK C2012 family; exact MPN pending | tinyplc:C_0805_2012Metric | Input 1 | About 100us release filter with 10k pull-up | https://product.tdk.com/en/products/capacitor/ceramic/mlcc/characteristic/ | specification only; exact MPN pending
1 | J6 | DI2 / GND | 1715721 | tinyplc:TerminalBlock_Phoenix_MKDS-1,5-2-5.08_1x02_P5.08mm_Horizontal | Input 2 | DI2 / GND | https://www.phoenixcontact.com/en-us/products/pcb-terminal-block-mkds-15-2-508-1715721 | candidate; verify before purchase
1 | R20 | 2.2k | ERJ-6ENF2201V | tinyplc:R_0805_2012Metric | Input 2 | First half of input LED current limiter | https://industrial.panasonic.com/cdbs/www-data/pdf/RDA0000/AOA0000C307.pdf | candidate; verify before purchase
1 | R21 | 2.2k | ERJ-6ENF2201V | tinyplc:R_0805_2012Metric | Input 2 | Second half of input limiter; shares dissipation | https://industrial.panasonic.com/cdbs/www-data/pdf/RDA0000/AOA0000C307.pdf | candidate; verify before purchase
1 | U5 | VO617A-3 | VO617A-3 | tinyplc:DIP-4_W7.62mm | Input 2 | 24V-present signal becomes active-low 3V3 GPIO | https://www.vishay.com/docs/83430/vo617a.pdf | candidate; verify before purchase
1 | D12 | 1N4148W | 1N4148W | tinyplc:D_SOD-123 | Input 2 | Antiparallel diode protects optocoupler LED against reverse input | https://assets.nexperia.com/documents/data-sheet/1N4148W_1N4448W.pdf | candidate; verify before purchase
1 | R22 | 10k | ERJ-6ENF1002V | tinyplc:R_0805_2012Metric | Input 2 | Collector pull-up sets GPIO HIGH when input is off | https://industrial.panasonic.com/cdbs/www-data/pdf/RDA0000/AOA0000C307.pdf | candidate; verify before purchase
1 | C22 | 10nF / 50V | TDK C2012 family; exact MPN pending | tinyplc:C_0805_2012Metric | Input 2 | About 100us release filter with 10k pull-up | https://product.tdk.com/en/products/capacitor/ceramic/mlcc/characteristic/ | specification only; exact MPN pending
1 | J7 | DI3 / GND | 1715721 | tinyplc:TerminalBlock_Phoenix_MKDS-1,5-2-5.08_1x02_P5.08mm_Horizontal | Input 3 | DI3 / GND | https://www.phoenixcontact.com/en-us/products/pcb-terminal-block-mkds-15-2-508-1715721 | candidate; verify before purchase
1 | R30 | 2.2k | ERJ-6ENF2201V | tinyplc:R_0805_2012Metric | Input 3 | First half of input LED current limiter | https://industrial.panasonic.com/cdbs/www-data/pdf/RDA0000/AOA0000C307.pdf | candidate; verify before purchase
1 | R31 | 2.2k | ERJ-6ENF2201V | tinyplc:R_0805_2012Metric | Input 3 | Second half of input limiter; shares dissipation | https://industrial.panasonic.com/cdbs/www-data/pdf/RDA0000/AOA0000C307.pdf | candidate; verify before purchase
1 | U6 | VO617A-3 | VO617A-3 | tinyplc:DIP-4_W7.62mm | Input 3 | 24V-present signal becomes active-low 3V3 GPIO | https://www.vishay.com/docs/83430/vo617a.pdf | candidate; verify before purchase
1 | D13 | 1N4148W | 1N4148W | tinyplc:D_SOD-123 | Input 3 | Antiparallel diode protects optocoupler LED against reverse input | https://assets.nexperia.com/documents/data-sheet/1N4148W_1N4448W.pdf | candidate; verify before purchase
1 | R32 | 10k | ERJ-6ENF1002V | tinyplc:R_0805_2012Metric | Input 3 | Collector pull-up sets GPIO HIGH when input is off | https://industrial.panasonic.com/cdbs/www-data/pdf/RDA0000/AOA0000C307.pdf | candidate; verify before purchase
1 | C23 | 10nF / 50V | TDK C2012 family; exact MPN pending | tinyplc:C_0805_2012Metric | Input 3 | About 100us release filter with 10k pull-up | https://product.tdk.com/en/products/capacitor/ceramic/mlcc/characteristic/ | specification only; exact MPN pending
1 | J8 | DI4 / GND | 1715721 | tinyplc:TerminalBlock_Phoenix_MKDS-1,5-2-5.08_1x02_P5.08mm_Horizontal | Input 4 | DI4 / GND | https://www.phoenixcontact.com/en-us/products/pcb-terminal-block-mkds-15-2-508-1715721 | candidate; verify before purchase
1 | R40 | 2.2k | ERJ-6ENF2201V | tinyplc:R_0805_2012Metric | Input 4 | First half of input LED current limiter | https://industrial.panasonic.com/cdbs/www-data/pdf/RDA0000/AOA0000C307.pdf | candidate; verify before purchase
1 | R41 | 2.2k | ERJ-6ENF2201V | tinyplc:R_0805_2012Metric | Input 4 | Second half of input limiter; shares dissipation | https://industrial.panasonic.com/cdbs/www-data/pdf/RDA0000/AOA0000C307.pdf | candidate; verify before purchase
1 | U7 | VO617A-3 | VO617A-3 | tinyplc:DIP-4_W7.62mm | Input 4 | 24V-present signal becomes active-low 3V3 GPIO | https://www.vishay.com/docs/83430/vo617a.pdf | candidate; verify before purchase
1 | D14 | 1N4148W | 1N4148W | tinyplc:D_SOD-123 | Input 4 | Antiparallel diode protects optocoupler LED against reverse input | https://assets.nexperia.com/documents/data-sheet/1N4148W_1N4448W.pdf | candidate; verify before purchase
1 | R42 | 10k | ERJ-6ENF1002V | tinyplc:R_0805_2012Metric | Input 4 | Collector pull-up sets GPIO HIGH when input is off | https://industrial.panasonic.com/cdbs/www-data/pdf/RDA0000/AOA0000C307.pdf | candidate; verify before purchase
1 | C24 | 10nF / 50V | TDK C2012 family; exact MPN pending | tinyplc:C_0805_2012Metric | Input 4 | About 100us release filter with 10k pull-up | https://product.tdk.com/en/products/capacitor/ceramic/mlcc/characteristic/ | specification only; exact MPN pending
1 | U3 | TPL7407LDR | TPL7407LDR | tinyplc:SOIC-16_3.9x9.9mm_P1.27mm | Outputs | Four 3.3V-compatible low-side drivers; 3 unused channels | https://www.ti.com/lit/ds/symlink/tpl7407l.pdf | candidate; verify before purchase
1 | C30 | 100nF / 50V | TDK C2012 family; exact MPN pending | tinyplc:C_0805_2012Metric | Outputs | Driver COM decoupling; clamp return must be short | https://product.tdk.com/en/products/capacitor/ceramic/mlcc/characteristic/ | specification only; exact MPN pending
1 | J9 | +24 / Q1 sink | 1715721 | tinyplc:TerminalBlock_Phoenix_MKDS-1,5-2-5.08_1x02_P5.08mm_Horizontal | Outputs | +24 / Q1 sink | https://www.phoenixcontact.com/en-us/products/pcb-terminal-block-mkds-15-2-508-1715721 | candidate; verify before purchase
1 | R51 | 100k | ERJ-6ENF1003V | tinyplc:R_0805_2012Metric | Outputs | External pull-down keeps driver input low during MCU reset | https://industrial.panasonic.com/cdbs/www-data/pdf/RDA0000/AOA0000C307.pdf | candidate; verify before purchase
1 | J10 | +24 / Q2 sink | 1715721 | tinyplc:TerminalBlock_Phoenix_MKDS-1,5-2-5.08_1x02_P5.08mm_Horizontal | Outputs | +24 / Q2 sink | https://www.phoenixcontact.com/en-us/products/pcb-terminal-block-mkds-15-2-508-1715721 | candidate; verify before purchase
1 | R52 | 100k | ERJ-6ENF1003V | tinyplc:R_0805_2012Metric | Outputs | External pull-down keeps driver input low during MCU reset | https://industrial.panasonic.com/cdbs/www-data/pdf/RDA0000/AOA0000C307.pdf | candidate; verify before purchase
1 | J11 | +24 / Q3 sink | 1715721 | tinyplc:TerminalBlock_Phoenix_MKDS-1,5-2-5.08_1x02_P5.08mm_Horizontal | Outputs | +24 / Q3 sink | https://www.phoenixcontact.com/en-us/products/pcb-terminal-block-mkds-15-2-508-1715721 | candidate; verify before purchase
1 | R53 | 100k | ERJ-6ENF1003V | tinyplc:R_0805_2012Metric | Outputs | External pull-down keeps driver input low during MCU reset | https://industrial.panasonic.com/cdbs/www-data/pdf/RDA0000/AOA0000C307.pdf | candidate; verify before purchase
1 | J12 | +24 / Q4 sink | 1715721 | tinyplc:TerminalBlock_Phoenix_MKDS-1,5-2-5.08_1x02_P5.08mm_Horizontal | Outputs | +24 / Q4 sink | https://www.phoenixcontact.com/en-us/products/pcb-terminal-block-mkds-15-2-508-1715721 | candidate; verify before purchase
1 | R54 | 100k | ERJ-6ENF1003V | tinyplc:R_0805_2012Metric | Outputs | External pull-down keeps driver input low during MCU reset | https://industrial.panasonic.com/cdbs/www-data/pdf/RDA0000/AOA0000C307.pdf | candidate; verify before purchase
1 | J13 | USB-C DEVICE | USB4105-GF-A-120 | tinyplc:USB_C_Receptacle_GCT_USB4105-xx-A_16P_TopMnt_Horizontal | USB | USB2 device only; VBUS never powers board | https://gct.co/files/drawings/usb4105.pdf | candidate; verify before purchase
1 | R60 | 5.1k | ERJ-6ENF5101V | tinyplc:R_0805_2012Metric | USB | USB-C Rd advertises a sink/device on CC1 | https://industrial.panasonic.com/cdbs/www-data/pdf/RDA0000/AOA0000C307.pdf | candidate; verify before purchase
1 | R61 | 5.1k | ERJ-6ENF5101V | tinyplc:R_0805_2012Metric | USB | Independent Rd on CC2 supports either cable orientation | https://industrial.panasonic.com/cdbs/www-data/pdf/RDA0000/AOA0000C307.pdf | candidate; verify before purchase
1 | R62 | 22 | ERJ-6ENF22R0V | tinyplc:R_0805_2012Metric | USB | Provisional USB D- source-series damping | https://industrial.panasonic.com/cdbs/www-data/pdf/RDA0000/AOA0000C307.pdf | candidate; verify before purchase
1 | R63 | 22 | ERJ-6ENF22R0V | tinyplc:R_0805_2012Metric | USB | Provisional USB D+ source-series damping | https://industrial.panasonic.com/cdbs/www-data/pdf/RDA0000/AOA0000C307.pdf | candidate; verify before purchase
1 | R64 | 68k | ERJ-6ENF6802V | tinyplc:R_0805_2012Metric | USB | VBUS divider upper resistor; limits sense voltage | https://industrial.panasonic.com/cdbs/www-data/pdf/RDA0000/AOA0000C307.pdf | candidate; verify before purchase
1 | R65 | 100k | ERJ-6ENF1003V | tinyplc:R_0805_2012Metric | USB | VBUS divider lower resistor; no back-power rail connection | https://industrial.panasonic.com/cdbs/www-data/pdf/RDA0000/AOA0000C307.pdf | candidate; verify before purchase
1 | U8 | USBLC6-2SC6 | USBLC6-2SC6 | tinyplc:SOT-23-6 | USB | Low-capacitance USB connector ESD protection | https://www.st.com/resource/en/datasheet/usblc6-2.pdf | candidate; verify before purchase
1 | C31 | 100nF / 50V | TDK C2012 family; exact MPN pending | tinyplc:C_0805_2012Metric | USB | ESD supply-reference bypass | https://product.tdk.com/en/products/capacitor/ceramic/mlcc/characteristic/ | specification only; exact MPN pending
1 | J14 | SPI: 3V3 GND SCK MISO MOSI CS | Samtec TSW-106-07-G-S | tinyplc:PinHeader_1x06_P2.54mm_Vertical | Expansion | Cabled SPI2 expansion; NOT a WIZ850io direct-plug footprint | https://www.samtec.com/products/tsw | candidate; verify before purchase
1 | J15 | ETH: GND RST INT | Samtec TSW-103-07-G-S | tinyplc:PinHeader_1x03_P2.54mm_Vertical | Expansion | Ethernet reset and interrupt expansion | https://www.samtec.com/products/tsw | candidate; verify before purchase
1 | R70 | 10k | ERJ-6ENF1002V | tinyplc:R_0805_2012Metric | Expansion | Deselected SPI device during boot | https://industrial.panasonic.com/cdbs/www-data/pdf/RDA0000/AOA0000C307.pdf | candidate; verify before purchase
1 | R71 | 10k | ERJ-6ENF1002V | tinyplc:R_0805_2012Metric | Expansion | Keep optional Ethernet module reset until firmware releases it | https://industrial.panasonic.com/cdbs/www-data/pdf/RDA0000/AOA0000C307.pdf | candidate; verify before purchase
1 | R72 | 10k | ERJ-6ENF1002V | tinyplc:R_0805_2012Metric | Expansion | Optional interrupt pull-up | https://industrial.panasonic.com/cdbs/www-data/pdf/RDA0000/AOA0000C307.pdf | candidate; verify before purchase
1 | J16 | OLED: 3V3 GND SCL SDA | Samtec TSW-104-07-G-S | tinyplc:PinHeader_1x04_P2.54mm_Vertical | Expansion | Cabled 3.3V I2C display; custom pin order | https://www.samtec.com/products/tsw | candidate; verify before purchase
1 | R73 | 4.7k | ERJ-6ENF4701V | tinyplc:R_0805_2012Metric | Expansion | I2C clock pull-up; review module parallel pull-ups | https://industrial.panasonic.com/cdbs/www-data/pdf/RDA0000/AOA0000C307.pdf | candidate; verify before purchase
1 | R74 | 4.7k | ERJ-6ENF4701V | tinyplc:R_0805_2012Metric | Expansion | I2C data pull-up; review module parallel pull-ups | https://industrial.panasonic.com/cdbs/www-data/pdf/RDA0000/AOA0000C307.pdf | candidate; verify before purchase
