sergiogallegos/tinyplc/hardware/prototype-a1/mechanical/tinyplc-a1-assembly.step

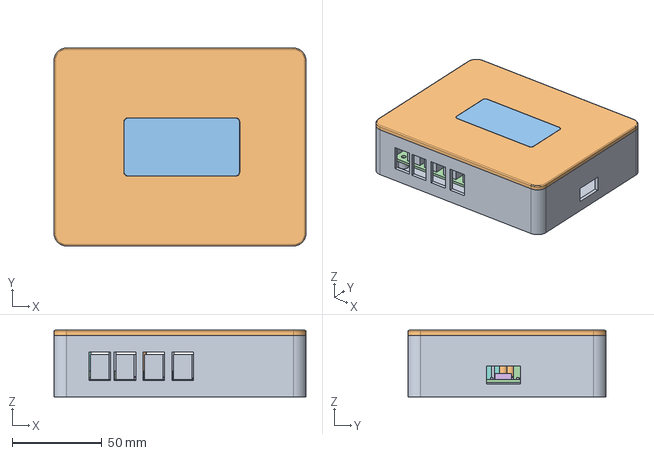
[picture p21: CAD file, 2026-10-25]
hardware/prototype-a1/mechanical/tinyplc-a1-assembly.step
140.0 x 110.0 x 37.0 mm
