sergiogallegos/tinyplc/hardware/prototype-a/mechanical/tinyplc-a0-assembly.step

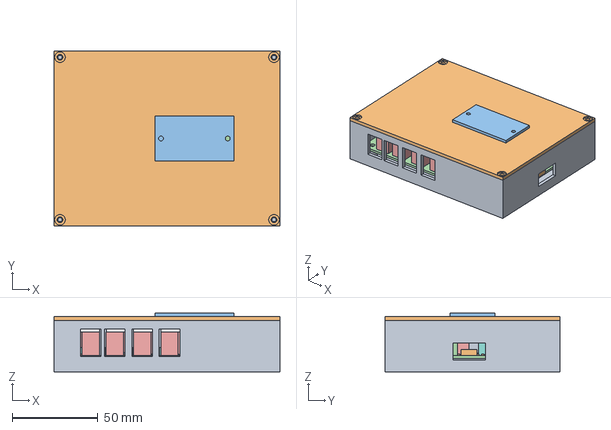
[picture p22: CAD file, 2026-10-25]
hardware/prototype-a/mechanical/tinyplc-a0-assembly.step
132.0 x 102.0 x 34.4 mm
