sergiogallegos/tinyplc/hardware/prototype-a/mechanical/fit-coupon-print.stl

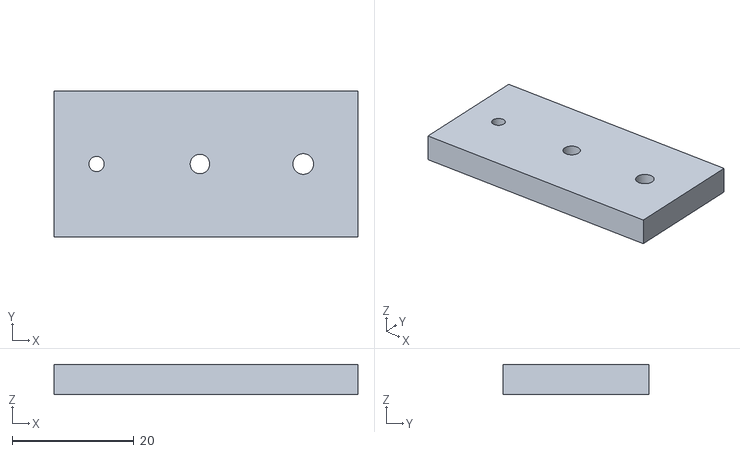
[picture p23: CAD file, 2026-10-25]
hardware/prototype-a/mechanical/fit-coupon-print.stl
50.0 x 24.0 x 5.00
