sergiogallegos/tinyplc/hardware/prototype-a/mechanical/display-blank-print.stl

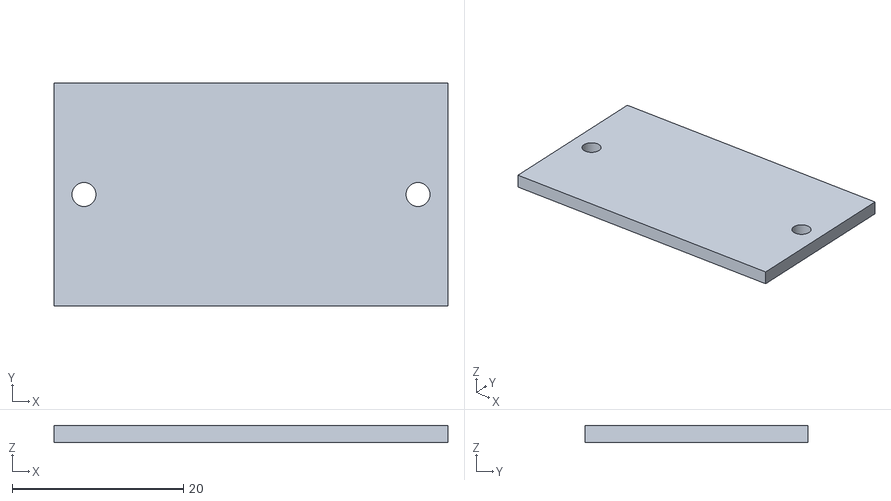
[picture p24: CAD file, 2026-10-25]
hardware/prototype-a/mechanical/display-blank-print.stl
46.0 x 26.0 x 2.00
