sergiogallegos/tinyplc/hardware/prototype-a1/mechanical/base.step

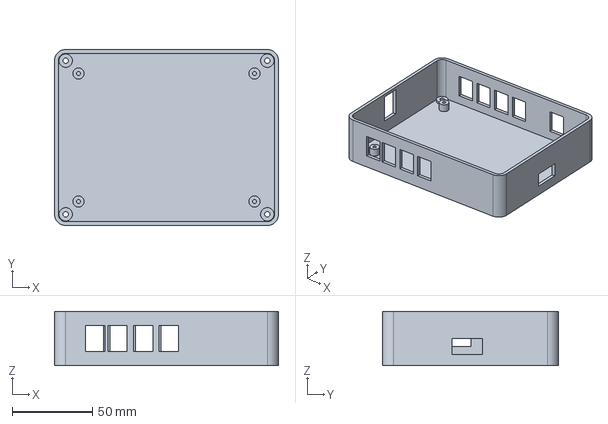
[picture p25: CAD file, 2026-10-25]
hardware/prototype-a1/mechanical/base.step
140.0 x 110.0 x 34.0 mm
