sergiogallegos/tinyplc/hardware/prototype-a1/mechanical/fit-coupon-print.stl

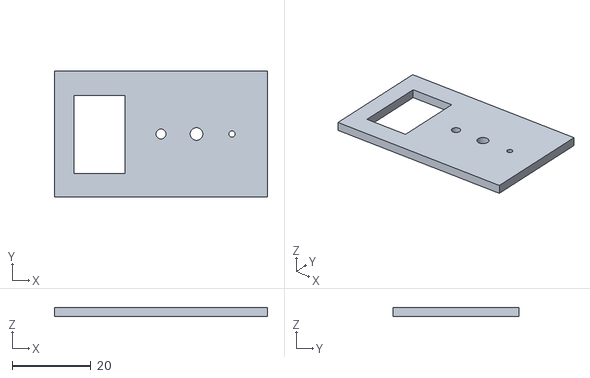
[picture p26: CAD file, 2026-10-25]
hardware/prototype-a1/mechanical/fit-coupon-print.stl
54.0 x 32.0 x 2.40
