sergiogallegos/tinyplc/hardware/prototype-a/mechanical/base.step

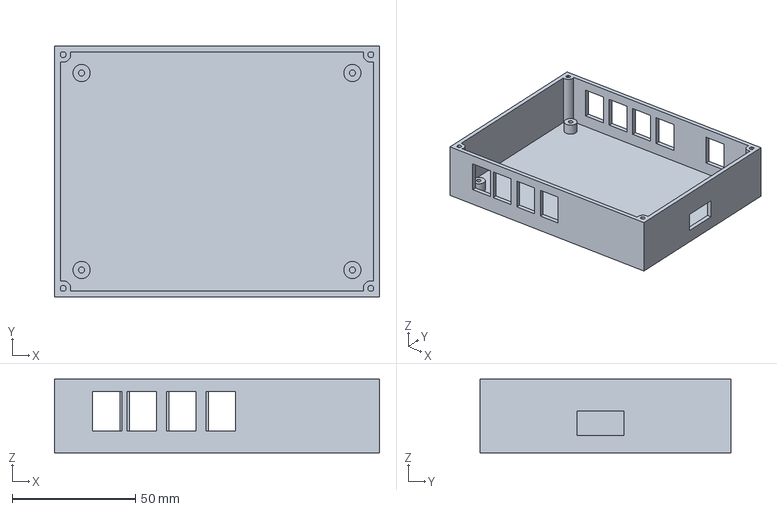
[picture p27: CAD file, 2026-10-25]
hardware/prototype-a/mechanical/base.step
132.0 x 102.0 x 30.0 mm
