sergiogallegos/tinyplc/hardware/prototype-a/mechanical/lid.step

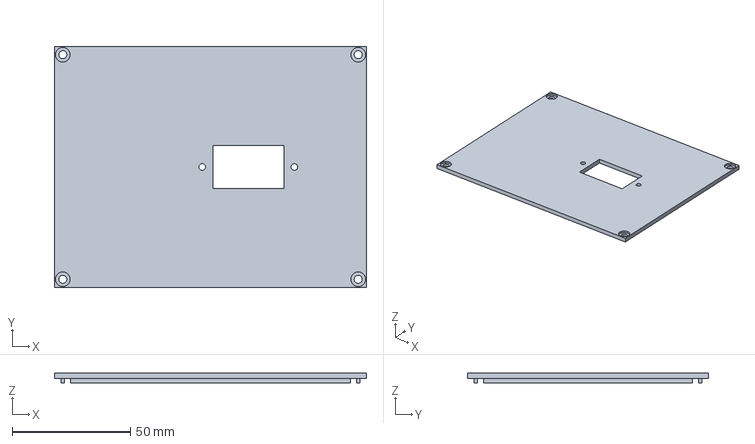
[picture p28: CAD file, 2026-10-25]
hardware/prototype-a/mechanical/lid.step
132.0 x 102.0 x 4.20 mm
