sergiogallegos/tinyplc/hardware/prototype-a1/mechanical/lid-print.stl

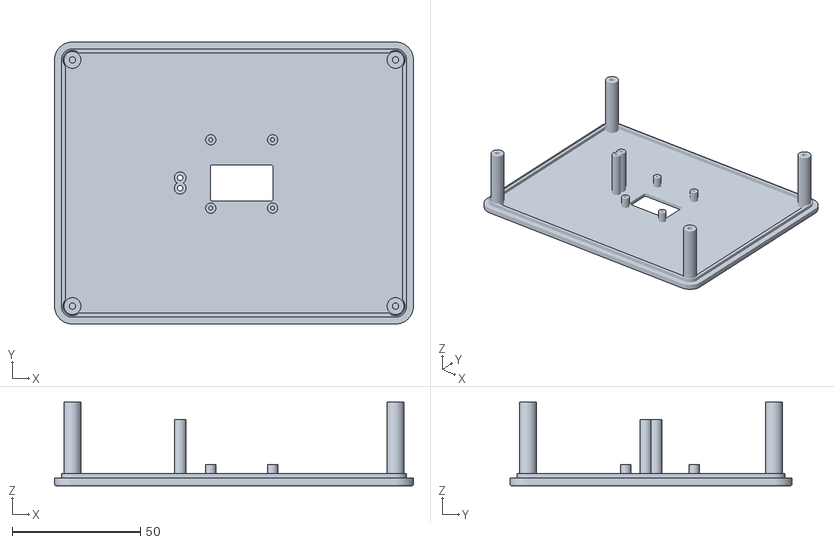
[picture p29: CAD file, 2026-10-25]
hardware/prototype-a1/mechanical/lid-print.stl
140.0 x 110.0 x 32.7
