sergiogallegos/tinyplc/(list of files, cad)

Other CAD files:
hardware/prototype-a/mechanical/display-blank.step
hardware/prototype-a1/mechanical/base-print.stl
hardware/prototype-a1/mechanical/tinyplc-a1.FCStd
hardware/prototype-a/mechanical/lid-print.stl
hardware/prototype-a1/mechanical/lid.step
hardware/prototype-a/mechanical/base-print.stl
hardware/prototype-a/mechanical/tinyplc-a0.FCStd
hardware/prototype-a/renders/assembly/assembly-illustrations.blend
hardware/prototype-a/renders/tinyplc-a0.blend
hardware/prototype-a1/renders/tinyplc-a1.blend
