sergiogallegos/tinyplc/hardware/prototype-a/mechanical/drawings/04-print-coupon-and-stack.pdf

## tinyPLC A0 / PRINT COUPON AND ASSEMBLY STACK

ENGINEERING DRAFT - mm - scale 1:1 at actual-size A4 printing - NOT A PCB FABRICATION RELEASE

Rev A0 / 2026-10-24 / Sheet 4 of 4 / CAD fit only; physical tolerances unverified

Check the scale bar. Print at 100%; disable fit-to-page. Native FreeCAD and parameters govern geometry.

100 mm

2.5 pilot | 3.2 | 3.4

### 50 x 24 x 5 test coupon

Tap pilot and try actual screws before the full print.

Measure hole size, elephant foot, layer bonding and flatness.

STACK / assembled Z coordinates:

0.0 outside base bottom

2.4 inside floor

8.0 PCB underside

9.6 PCB component side

23.4 terminal top (nominal envelope)

28.2 underside of lid locating lip

30.0 lid underside / tower top

32.4 lid outside face

34.4 blank outside face

PRINT ORIENTATION | Screw heads may project further.

base-print.stl: floor down, open side up

lid-print.stl: outside face down, lip up

display-blank-print.stl: flat

fit-coupon-print.stl: flat

Import STL units as mm; do not rescale.

0.4 nozzle / 0.2 layer is a starting proposal.

Check bridges/supports in the slicer first.

Material and settings are not physically qualified.
