sergiogallegos/tinyplc/hardware/prototype-a/mechanical/drawings/assembly-guide.pdf

tinyPLC / A0 VISUAL ASSEMBLY | PROTOTYPE / ILLUSTRATED MECHANICAL GUIDE

Build it. See every step.

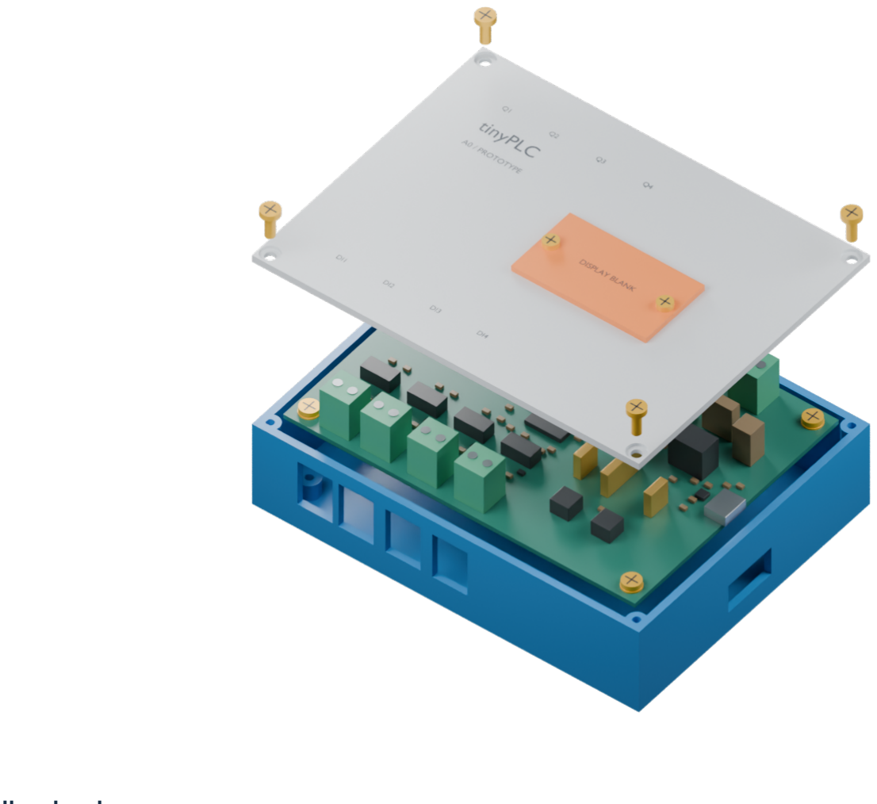
[picture p30: figure]

A0 • CAD illustrations, not assembly photos • physical fit untested • images not to scale | 01

# YOUR FIRST

# tinyPLC CASE

A picture-led guide to printing,

## checking and assembling the A0

enclosure.

PRINT + FIT NOW

Start with the coupon, printed case and card board template.

PCB INSTALLATION LATER

The A0 PCB is unrouted. Board steps show the intended future assembly.

### Blue base • pale lid • orange blank • green PCB • yellow hardware

Colors identify parts. Hardware and electronic packages are simplified; screws are candidate sizes. Keep the detailed electrical procedure beside this booklet.

tinyPLC / A0 VISUAL ASSEMBLY | INVENTORY / MATCH THE A0 REVISION

# Lay out the large parts

A BASE; 1 × base-print.stl; Blue shell; integral PCB posts.; B LID; 1 × lid-print.stl; Pale lid; locating lip underneath.; C DISPLAY BLANK; 1 × display-blank-print.stl; Orange cover; no display installed.; D CARD TEMPLATE; 1 × drawing 03 at 100%; Use this for the first case fit.; E FUTURE PCB; 1 × reviewed, tested board; Shown for planning; not ready to order.; F FIT COUPON; 1 × fit-coupon-print.stl; Check printer and pilot holes first.

A0 • CAD illustrations, not assembly photos • physical fit untested • images not to scale | 02

tinyPLC / A0 VISUAL ASSEMBLY | INVENTORY / NOMINAL HARDWARE

# Sort the screws before you start

PCB mounting; With 4 M3 washers, about 0.5 mm thick.; Lid mounting; Head diameter at most 6 mm.; Display blank; Pass through blank and lid.; Under PCB screw heads; Seat on the board, not below it.; Under the lid; Between lid underside and blank nuts.; Display blank retention; Hold while tightening the two screws.

A0 • CAD illustrations, not assembly photos • physical fit untested • images not to scale | 03

Tools: ruler, deburring tool, M3 × 0.5 hand tap, suitable hand screwdriver and a small nut driver. Confirm actual screw drawings and fit on the coupon; no tightening torque is qualified.

tinyPLC / A0 VISUAL ASSEMBLY | CASE FIT / CAN BE TRIED NOW
01 | Prove the fit on the small coupon

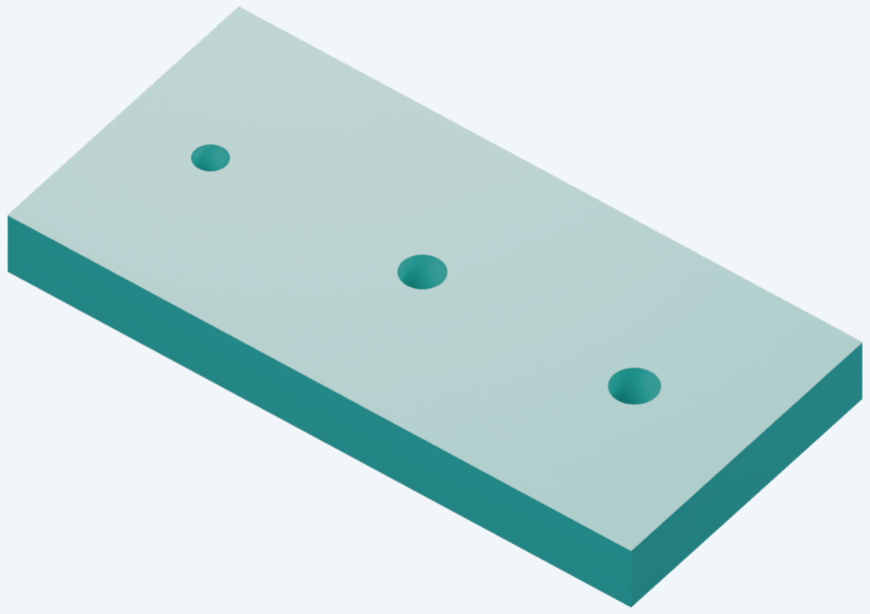
[picture p31: figure]

A0 • CAD illustrations, not assembly photos • physical fit untested • images not to scale | 04

USE FIRST

### 1 × fit coupon

Print before the full case. Check the 50 × 24 mm outline with a ruler.

A: 2.5 mm pilot — try M3 tap. B: 3.2 mm clearance. C: 3.4 mm clearance.

A

B

C

CHECK
No splitting, binding or stripping.

tinyPLC / A0 VISUAL ASSEMBLY | CASE FIT / CAN BE TRIED NOW
02 | Print with the right face on the bed

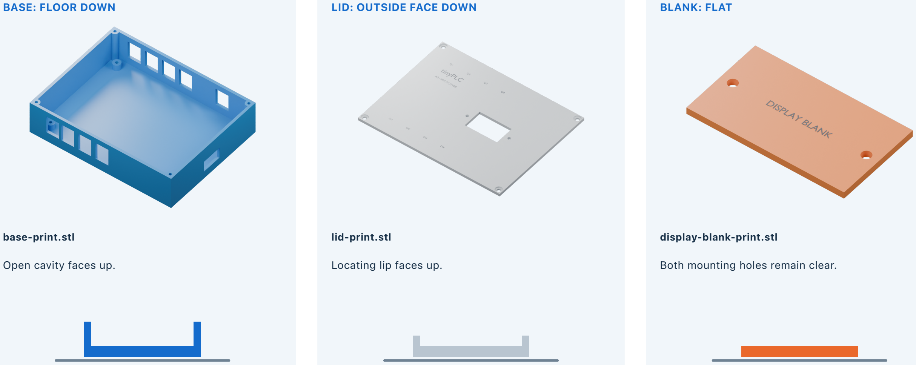
[picture p32: figure]
BASE: FLOOR DOWN; base-print.stl; Open cavity faces up.; LID: OUTSIDE FACE DOWN; lid-print.stl; Locating lip faces up.; BLANK: FLAT; display-blank-print.stl; Both mounting holes remain clear.

A0 • CAD illustrations, not assembly photos • physical fit untested • images not to scale | 05

Use the supplied print STLs in millimeters: their print orientations are already applied. The pictures above identify parts; the small sections show bed orientation. Use the coupon settings that passed the previous step.

Starting proposal: PETG, 0.4 mm nozzle, 0.2 mm layers. Review bridges/supports in the slicer and record your actual profile.

tinyPLC / A0 VISUAL ASSEMBLY | CASE FIT / CAN BE TRIED NOW
03 | Clean and prepare the blue base

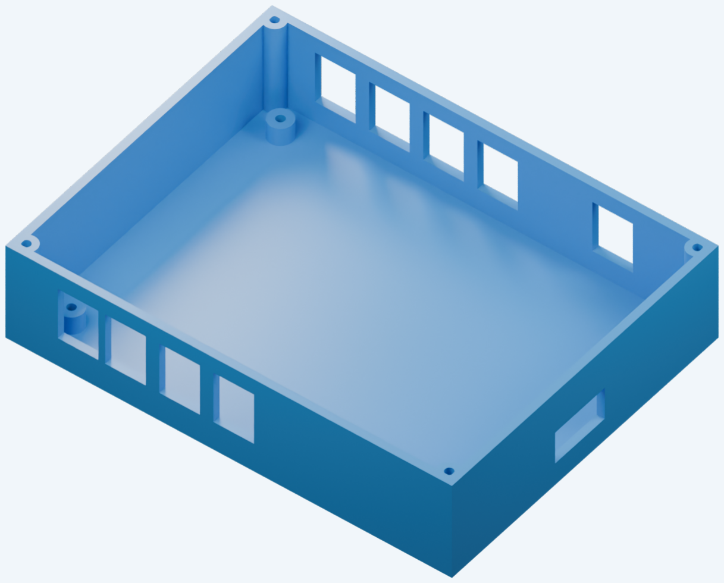
[picture p33: figure]

A0 • CAD illustrations, not assembly photos • physical fit untested • images not to scale | 06

USE THESE PARTS

### 1 × base

Remove supports and strings. Try the empty lid; it must seat without screws pulling it flat.

A: four PCB posts. B: four lid towers. Tap their pilots only after the coupon passes.

A

B

C

D

C: DI wire openings D: USB service opening

CHECK
Pilots clear. Floor and lid flat.

tinyPLC / A0 VISUAL ASSEMBLY | CASE FIT / CAN BE TRIED NOW
04 | Try the card board template

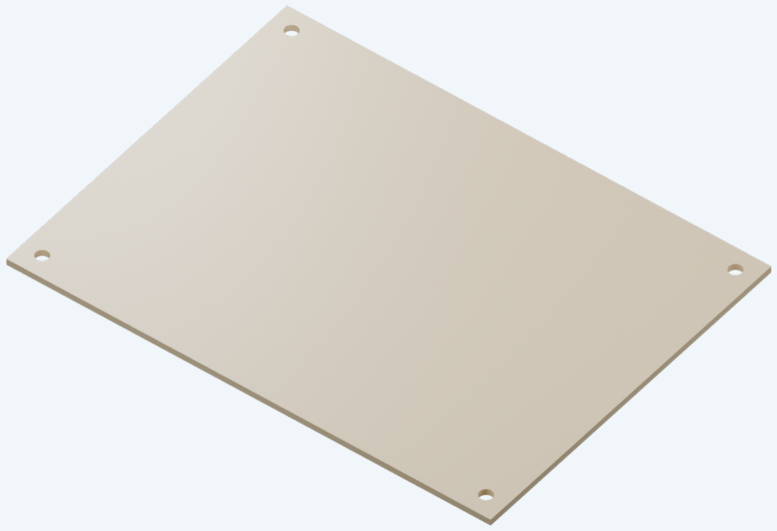
[picture p34: figure]

A0 • CAD illustrations, not assembly photos • physical fit untested • images not to scale | 07

ADD THESE PARTS

### 1 × card template

Print drawing 03 at 100%. Check its 100 mm scale bar, cut the outline and punch four holes.

Lower onto the posts. DI edge faces the four front openings. Check USB and terminal positions.

CHECK
All four holes align freely.

tinyPLC / A0 VISUAL ASSEMBLY | FUTURE STEP / AFTER PCB RELEASE + BRING-UP
05 | Lower the tested board into the base

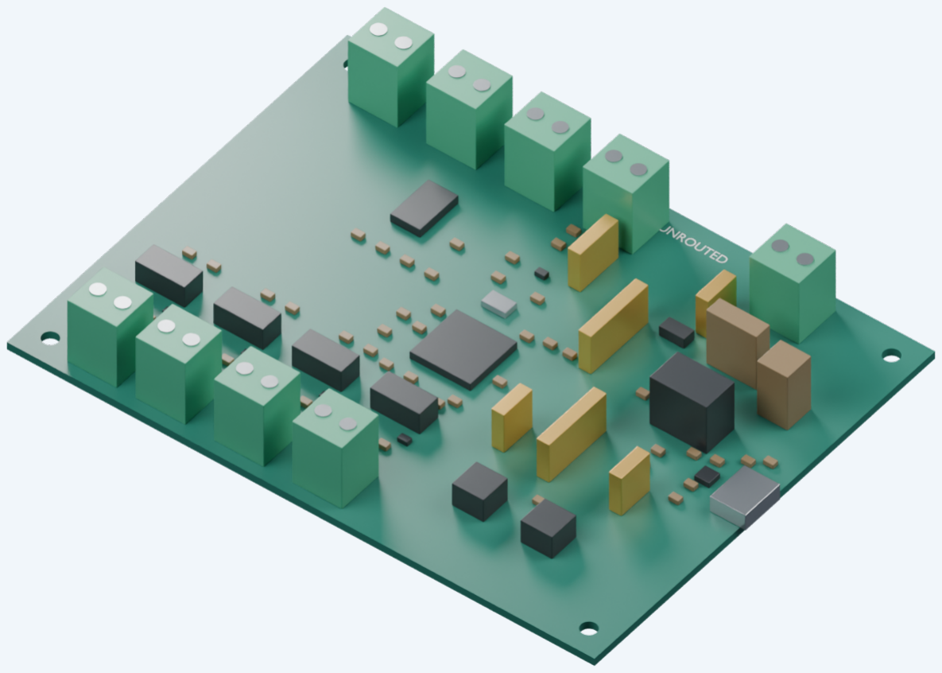
[picture p35: figure]

A0 • CAD illustrations, not assembly photos • physical fit untested • images not to scale | 08

ADD THESE PARTS

### 1 × tested PCB

First finish routing, fabrication review and the electrical bring-up in the technical reference.

Power off. Remove cables. Inspect underside leads, then lower the board onto all four posts.

DI terminals face the four front openings; USB faces its side port.

CHECK
Board flat; no lead touches case.

tinyPLC / A0 VISUAL ASSEMBLY | FUTURE STEP / BOARD INSTALLED, POWER OFF
06 | Secure the board with four screws

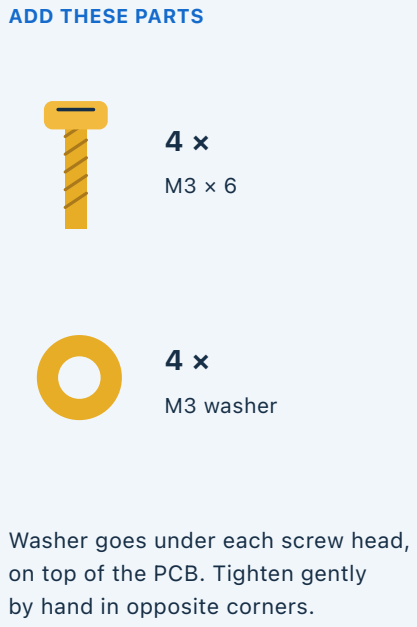
[picture p36: figure]
ADD THESE PARTS; M3 washer; Washer goes under each screw head, on top of the PCB. Tighten gently by hand in opposite corners.

A0 • CAD illustrations, not assembly photos • physical fit untested • images not to scale | 09

CHECK
No bowing or screw bottoming.

tinyPLC / A0 VISUAL ASSEMBLY | CASE FIT / CAN BE TRIED NOW
07 | Attach the orange blank to the lid

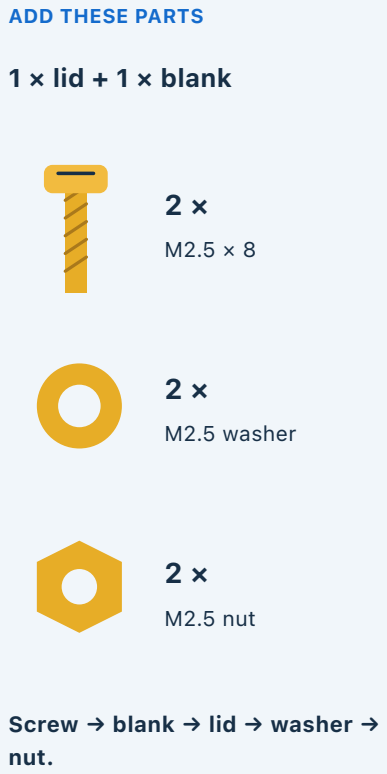
[picture p37: figure]
ADD THESE PARTS; 1 × lid + 1 × blank; M2.5 washer; M2.5 nut; Screw → blank → lid → washer → nut.

A0 • CAD illustrations, not assembly photos • physical fit untested • images not to scale | 10

Washers and nuts go underneath: see the detail on the next page.

CHECK
Blank covers the entire opening.

tinyPLC / A0 VISUAL ASSEMBLY | DETAIL / DISPLAY BLANK HARDWARE

# The blank fastener stack, from both sides

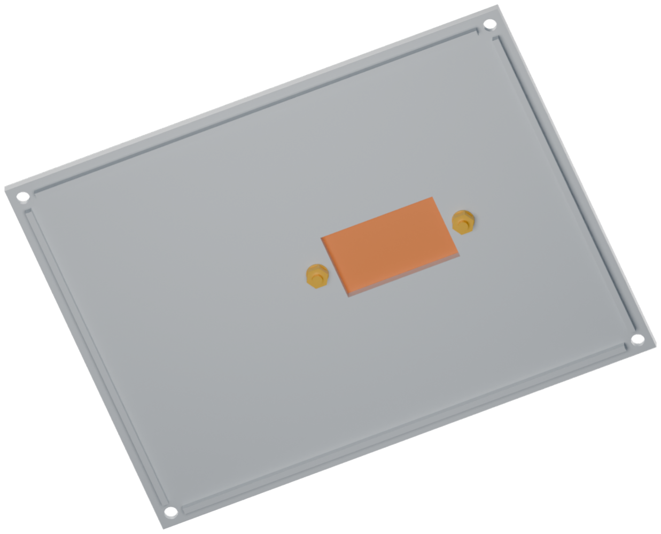
[picture p38: figure]

A0 • CAD illustrations, not assembly photos • physical fit untested • images not to scale | 11

SIDE SECTION / ONE FASTENER

Screw head

Blank

Lid

Washer

Nut

M2.5 × 8: length below the head

Section is illustrative; gaps are exaggerated to show the order. Washers belong below the lid.

UNDERSIDE VIEW / two nuts + two washers

tinyPLC / A0 VISUAL ASSEMBLY | CASE FIT / CAN BE TRIED NOW
08 | Check the completed lid

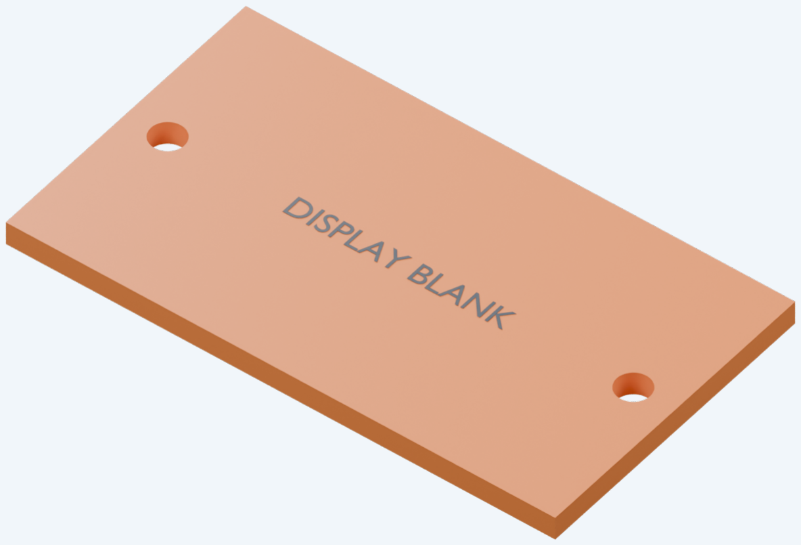
[picture p39: figure]

A0 • CAD illustrations, not assembly photos • physical fit untested • images not to scale | 12

COMPLETED SUBASSEMBLY

Hold each nut while tightening its screw. The blank should sit flat with no movement.

Check underneath: both washers and nuts are present. Keep them clear of future wiring.

Lid lettering is a separate applied label; it is not embossed in the STL.

CHECK
Two screws, two washers, two nuts.

tinyPLC / A0 VISUAL ASSEMBLY | FUTURE STEP / POWER OFF DURING ASSEMBLY
09 | Inspect the open assembly and wiring
A0 • CAD illustrations, not assembly photos • physical fit untested • images not to scale | 13

CHECK BEFORE CLOSING

A All 4 board screws seated.

B DI1–DI4 at the front.

C Q1–Q4 at the rear.

D 24 V supply connector.

E USB service opening.

Use schematic pin numbers for polarity, never this picture alone.

A

B

C

D

E

CHECK
No loose hardware or clipped leads.

tinyPLC / A0 VISUAL ASSEMBLY | CASE FIT NOW / OR FUTURE TESTED ASSEMBLY
10 | Seat the lid without trapping wires

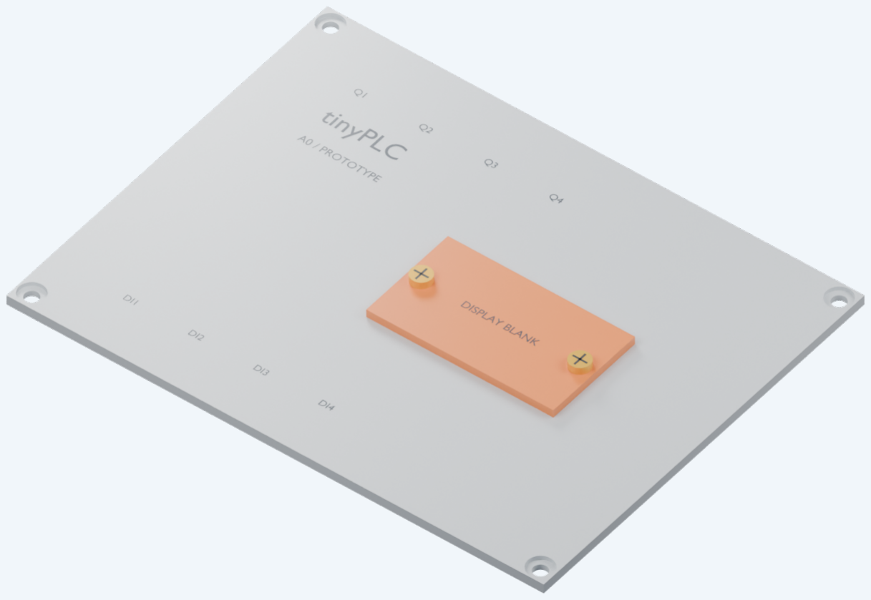
[picture p40: figure]

A0 • CAD illustrations, not assembly photos • physical fit untested • images not to scale | 14

ADD THESE PARTS

### 1 × completed lid

If wired: label each wire, use the terminal maker’s strip length and provide external strain relief.

Keep wires away from the lip and blank nuts. Lower the lid until the lip sits inside the case.

CHECK
Lid sits flush before screws go in.

tinyPLC / A0 VISUAL ASSEMBLY | CASE FIT NOW / OR FUTURE TESTED ASSEMBLY
11 | Fit the four lid screws

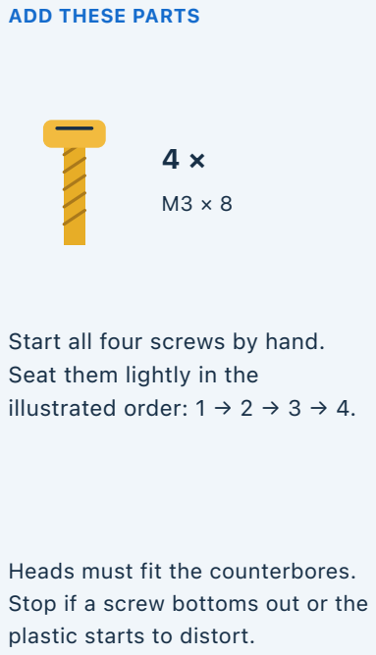
[picture p41: figure]
ADD THESE PARTS; Start all four screws by hand. Seat them lightly in the illustrated order: 1 → 2 → 3 → 4.; Heads must fit the counterbores. Stop if a screw bottoms out or the plastic starts to distort.

A0 • CAD illustrations, not assembly photos • physical fit untested • images not to scale | 15
1 | 2

3

4

CHECK
Even seam; no forced lid bending.

tinyPLC / A0 VISUAL ASSEMBLY | COMPLETE / MECHANICAL PROTOTYPE

Record the fit. Plan the next revision.

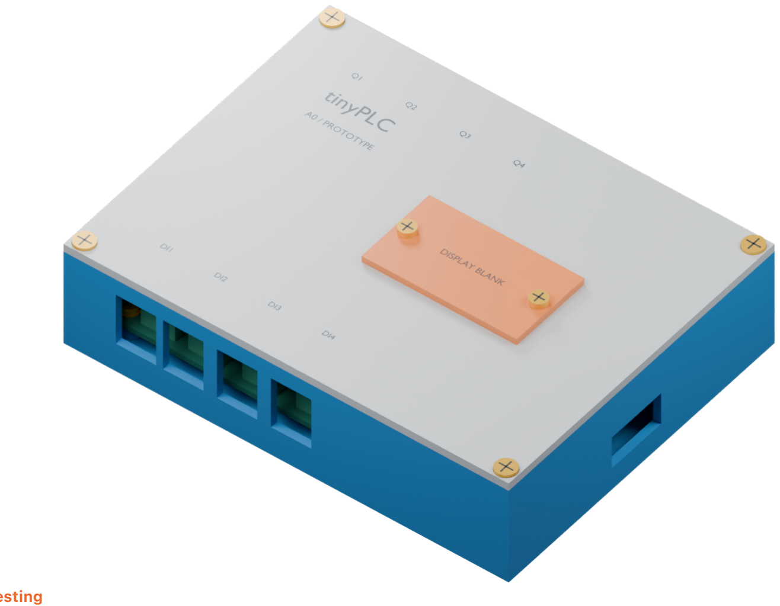
[picture p42: figure]

A0 • CAD illustrations, not assembly photos • physical fit untested • images not to scale | 16

FINAL CHECK

Case seam is even.

Blank is secure.

Ports stay accessible.

No trapped wiring.

Labels match the schematic.

Record print settings, fit issues
and measurements. Revise CAD and regenerate matching files.

### Next: electrical bring-up and measured testing

Follow technical-assembly-reference.pdf for staged soldering, power checks, SWD, I/O and firmware. A closed case does not establish a working controller.
