sergiogallegos/tinyplc/hardware/prototype-a1/mechanical/drawings/assembly-guide.pdf

tinyPLC / VISUAL ASSEMBLY GUIDE
Build the A1 enclosure.

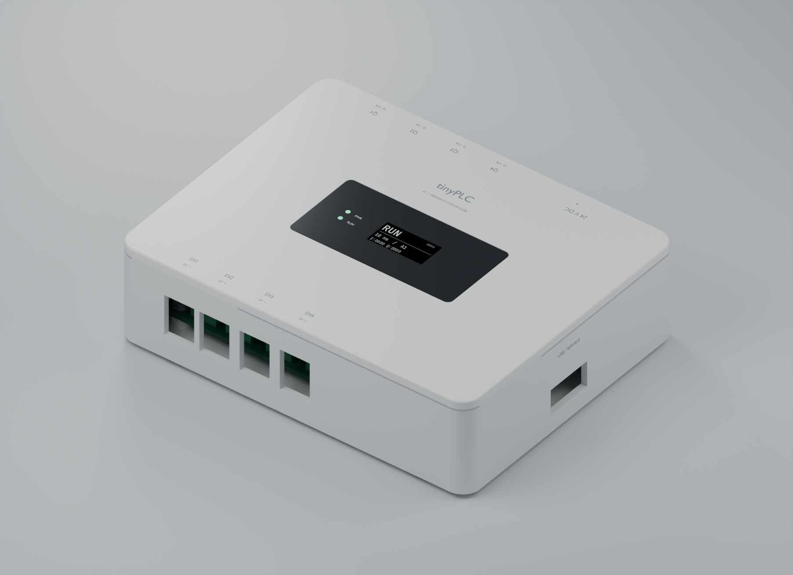
[picture p43: figure]

A1 prototype • CAD renders • not a fabrication release • 2026-10-24 | 01

WHITE SHELL.
VISIBLE STATUS.

A picture-led sequence for the switch, custom controller, OLED, light guides and concealed fasteners.

Start now: print and card fit checks. Board installation follows a routed, reviewed release and staged electrical bring-up.

All pictures are CAD renders. The display says DEMO because its A1 firmware integration is still pending.

INVENTORY / USE THE MATCHING A1 BOM
Lay out the parts.
A1 prototype • CAD renders • not a fabrication release • 2026-10-24 | 02

Printed parts

1 base + 1 lid + 1 fit coupon. Print STLs already have bed orientation.

Board retention

4 × M3 × 6 screws; 4 × M3 washers, nominal 0.5 mm thick.

Case retention

4 × M3 × 10 screws from below; 4 adhesive feet, nominal 8 × 2 mm.

Status optics

1 lens, 64 × 32 × 1; reverse black mask; 2 clear Ø3 × 24.6 rods.

OLED module

1 Adafruit 326 QT; 4 × M2 × 6 screws; 4 × M2 washers; 1 four-wire harness.

Power switch

1 C&K D102J12S215HQA candidate; 2 insulated leads with matching quick-connects.

Prepare a ruler, suitable hand screwdriver, M3/M2 taps, crimp tool and multimeter. Try actual hardware on the coupon before printing the whole case.

ASSEMBLY / A1 / PROTOTYPE FIT / POWER DISCONNECTED
01 Print the coupon, then the shell.
A1 prototype • CAD renders • not a fabrication release • 2026-10-24 | 03

PARTS / TOOLS

1 coupon / base / lid. Ruler, switch, taps and rod.

Test the switch snap fit, M3/M2 pilots and rod bore first. Print
base floor-down; lid outside-face-down with columns up. Import STLs in mm.

CHECK / Coupon passes; empty lid seats flush. No cracked pilots or warped mating faces.

ASSEMBLY / A1 / PROTOTYPE FIT / POWER DISCONNECTED
02 Fit the side power switch.
A1 prototype • CAD renders • not a fabrication release • 2026-10-24 | 04

PARTS / TOOLS

1 SW3 switch. Two insulated quick-connect leads.

Snap into the left opening. Check terminal 1–1A continuity in the I position. Fit insulated 4.75 × 0.8 mm connectors with the correct crimp tool.

CHECK / Switch retained; terminals insulated; space for connector boots and wire bends.

ASSEMBLY / A1 / AFTER ROUTED PCB RELEASE + BRING-UP
03 Lower the tested board onto its posts.
A1 prototype • CAD renders • not a fabrication release • 2026-10-24 | 05

PARTS / TOOLS

1 reviewed and tested custom A1 controller PCB.

For the first case trial,
substitute the card template. For electronics assembly, remove all power and cables. DI edge faces the four front openings.

CHECK / All four holes align. No lead touches the floor or case.

ASSEMBLY / A1 / AFTER ROUTED PCB RELEASE + BRING-UP
04 Secure the controller board.
A1 prototype • CAD renders • not a fabrication release • 2026-10-24 | 06

PARTS / TOOLS

4 × M3 × 6 screws. 4 × M3
washers.

Place a washer under each head, on the PCB. Start all screws and tighten gently in opposite
corners. Keep the board flat.

CHECK / No board bowing, bottomed screws or loose hardware.

ASSEMBLY / A1 / POWER DISCONNECTED
05 Wire the positive-side switch loop.

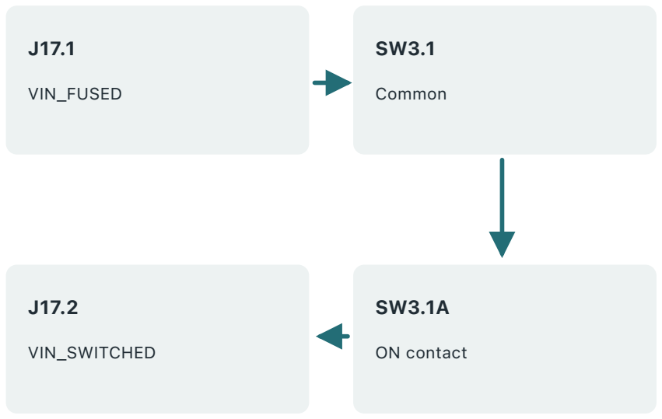
[picture p44: figure]
VIN_FUSED; Common; ON contact; VIN_SWITCHED
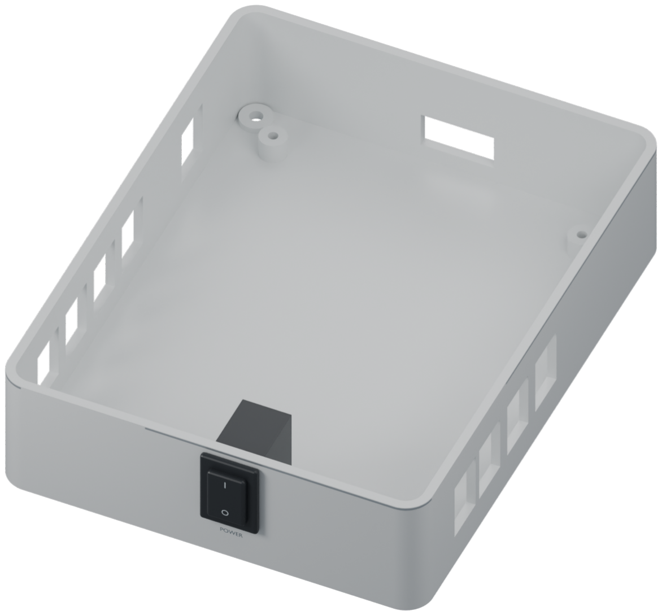
[picture p45: figure]

A1 prototype • CAD renders • not a fabrication release • 2026-10-24 | 07

Both J17 contacts are positive power paths. Neither is ground. Verify ON closes the loop and OFF opens it.

J1 supply: pin 1 = +24 V, pin 2 = 0 V/GND (−). Disconnect the source before assembly. OFF does not isolate the input terminal or every external signal.

ASSEMBLY / A1 / PROTOTYPE FIT / POWER DISCONNECTED
06 Install the light guides and lens.
A1 prototype • CAD renders • not a fabrication release • 2026-10-24 | 08

PARTS / TOOLS

2 clear Ø3 × 24.6 rods. 1 masked lens + perimeter adhesive.

Insert rods through the top pocket onto their ledges. Align the screen and LED windows in the reverse mask. Bond the lens perimeter after the optical trial.

CHECK / Rods stay clear of LEDs. Viewing windows remain clear; adhesive stays off the optics.

ASSEMBLY / A1 / PROTOTYPE FIT / POWER DISCONNECTED
07 Mount the OLED beneath the lid.
A1 prototype • CAD renders • not a fabrication release • 2026-10-24 | 09

PARTS / TOOLS

1 Adafruit 326 QT. 4 × M2 × 6 screws + washers.

Glass faces the lid window. Posts touch the module PCB, not the glass. Screws enter from the module rear. Check the received board revision and narrow glass clearance.

CHECK / No glass/flex clamping; module flat, lens aligned and screws retained.

ASSEMBLY / A1 / CUSTOM HEADER ORDER
08 Connect the display harness.

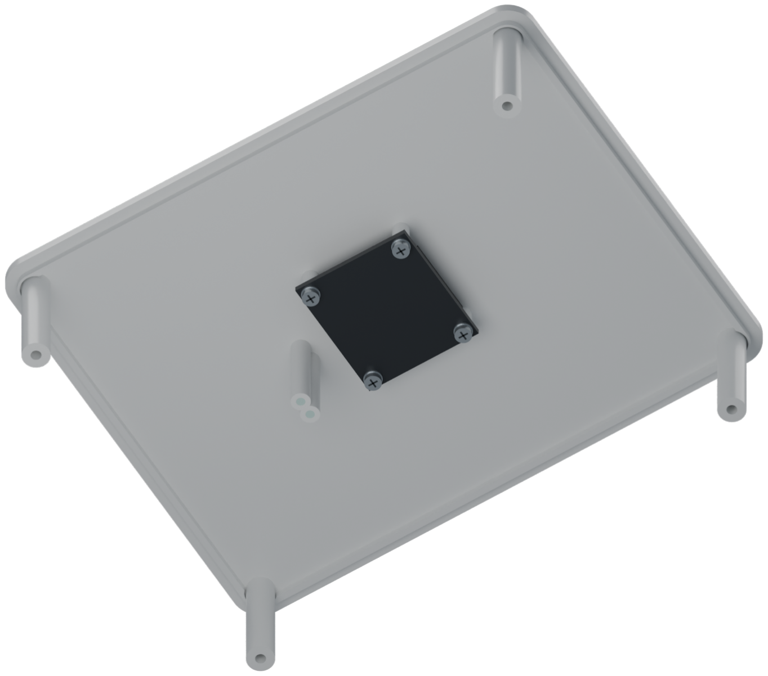
[picture p46: figure]

A1 prototype • CAD renders • not a fabrication release • 2026-10-24 | 10

J16.1 +3V3

QT 2 / VIN / red

J16.2 GND

QT 1 / GND / black

J16.3 SCL / PB6

QT 4 / yellow

J16.4 SDA / PB7

QT 3 / blue

Use female sockets at the controller male header and a keyed QT plug at the display. These pin orders are different: verify continuity, then measure 3.3 V before connecting the module.

Leave a short service loop clear of columns and optical sleeves. Do not pull the display cable when removing the lid.

ASSEMBLY / A1 / AFTER ROUTED PCB RELEASE + BRING-UP
09 Close the enclosure by hand.
A1 prototype • CAD renders • not a fabrication release • 2026-10-24 | 11

PARTS / TOOLS

1 completed lid. Board and wiring inspected.

Remove clipped leads and tools. Check switch boots, the display loop and light-guide alignment. Seat the lip into the base without pinching wires.

CHECK / The lid is flush before any case screw is installed.

ASSEMBLY / A1 / PROTOTYPE FIT / POWER DISCONNECTED
10 Fasten from underneath.
A1 prototype • CAD renders • not a fabrication release • 2026-10-24 | 12

PARTS / TOOLS

4 × M3 × 10 screws. 4 adhesive feet.

Turn the unpowered assembly over. Start all four screws, then
tighten diagonally by hand. Place the feet clear of the screw access holes.

CHECK / Even seam; no forced bending. The top remains free of visible fasteners.

ASSEMBLY / A1 / FINAL MECHANICAL CHECK
11 Apply labels and record the build.

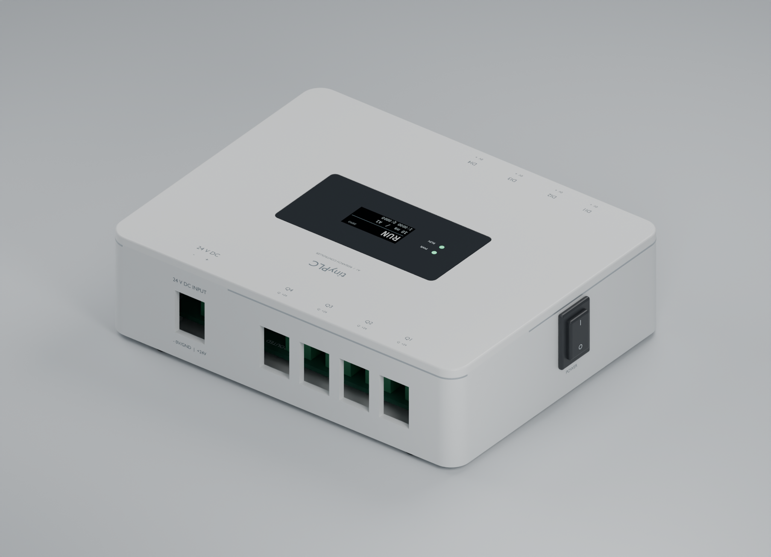
[picture p47: figure]

A1 prototype • CAD renders • not a fabrication release • 2026-10-24 | 13

Apply the A1 label master. J1 is the supply input; output terminals are load connections.

Verify +24 V and 0 V/GND (−) against J1 pin numbers. There is no protective-earth connection.

Record printer settings, screw fit, switch retention, cable clearance and optical alignment. Update CAD under a new revision when needed.

Electrical operation requires the staged bring-up procedure and an A1 firmware port. Test the actual terminal behavior, switch cycling and temperatures; a lit PWR LED does not prove execution.
