sergiogallegos/tinyplc/hardware/prototype-a/mechanical/drawings/assembly-pages/09-board-fasteners.pdf

tinyPLC / A0 VISUAL ASSEMBLY | FUTURE STEP / BOARD INSTALLED, POWER OFF
06 | Secure the board with four screws

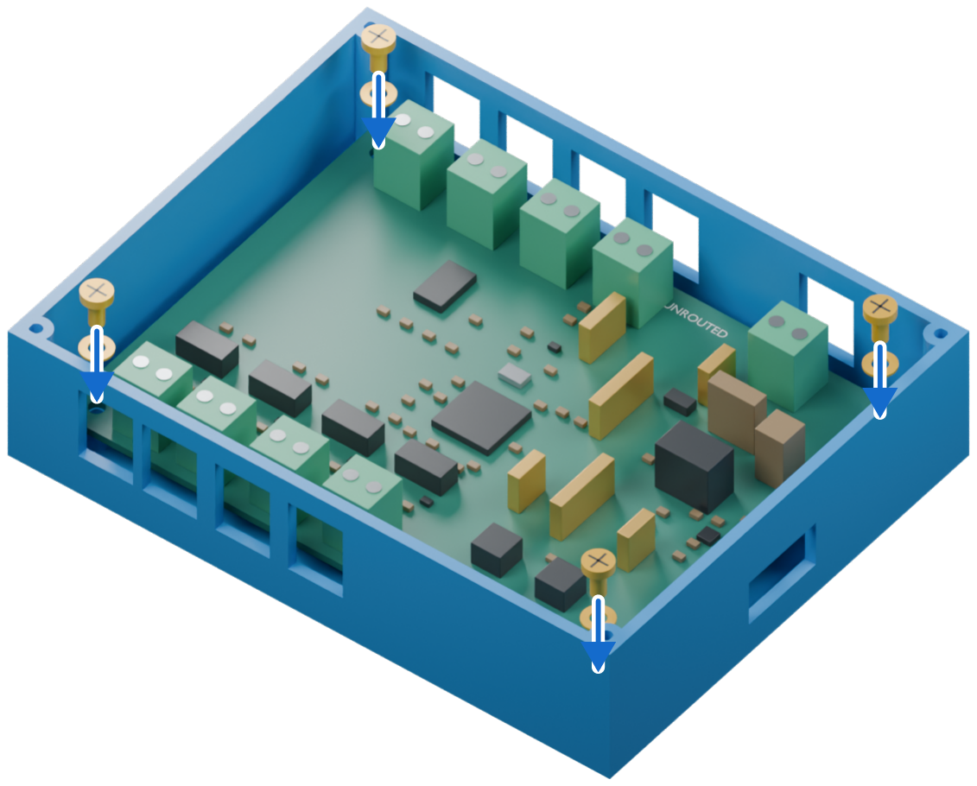
[picture p48: figure]
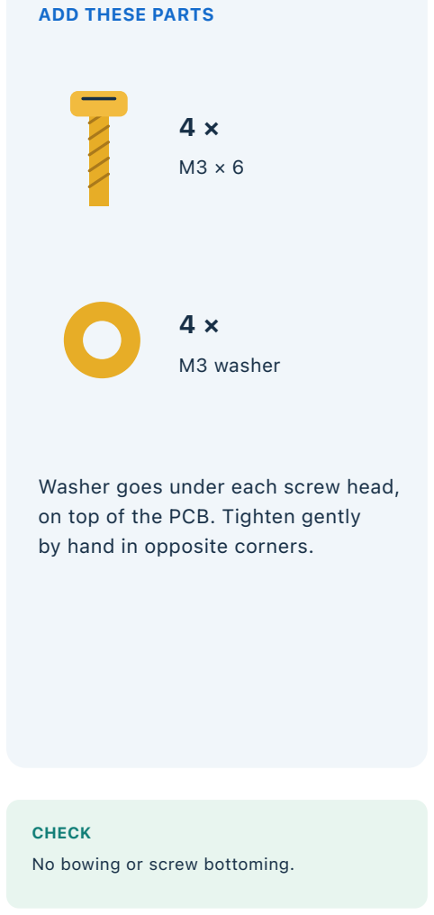
[picture p49: figure]
ADD THESE PARTS; M3 washer; Washer goes under each screw head, on top of the PCB. Tighten gently by hand in opposite corners.; CHECK; No bowing or screw bottoming.

A0 • CAD illustrations, not assembly photos • physical fit untested • images not to scale | 09
