sergiogallegos/tinyplc/hardware/prototype-a/mechanical/drawings/assembly-pages/10-blank-fasteners.pdf

# 07 Attach the orange blank to the lid

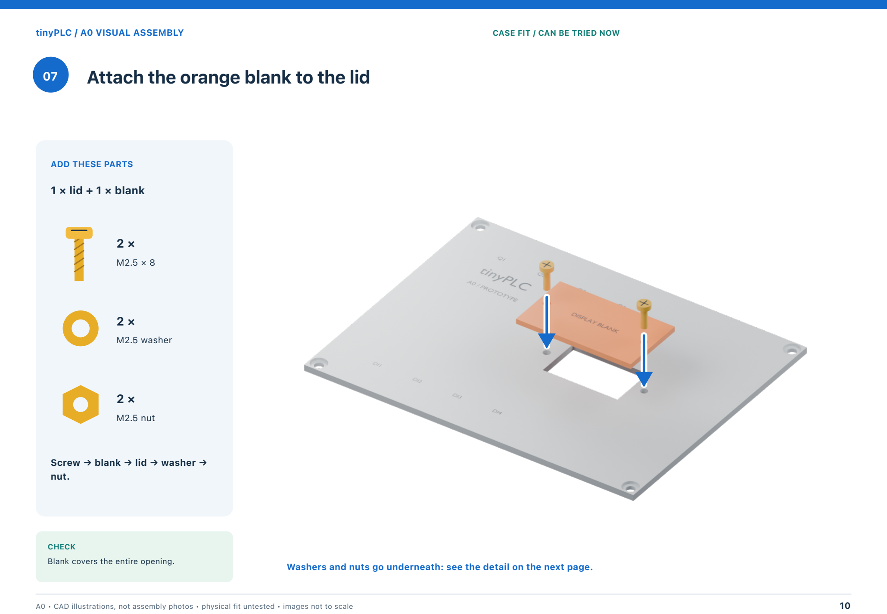
[picture p50: page 1]

tinyPLC / A0 VISUAL ASSEMBLY | CASE FIT / CAN BE TRIED NOW
A0 • CAD illustrations, not assembly photos • physical fit untested • images not to scale | 10

ADD THESE PARTS

### 1 × lid + 1 × blank

2 ×

M2.5 × 8

2 ×

M2.5 washer

2 ×

M2.5 nut

Screw → blank → lid → washer → nut.

Washers and nuts go underneath: see the detail on the next page.

CHECK
Blank covers the entire opening.
