sergiogallegos/tinyplc/hardware/prototype-a/mechanical/drawings/assembly-pages/15-lid-fasteners.pdf

# 11 Fit the four lid screws

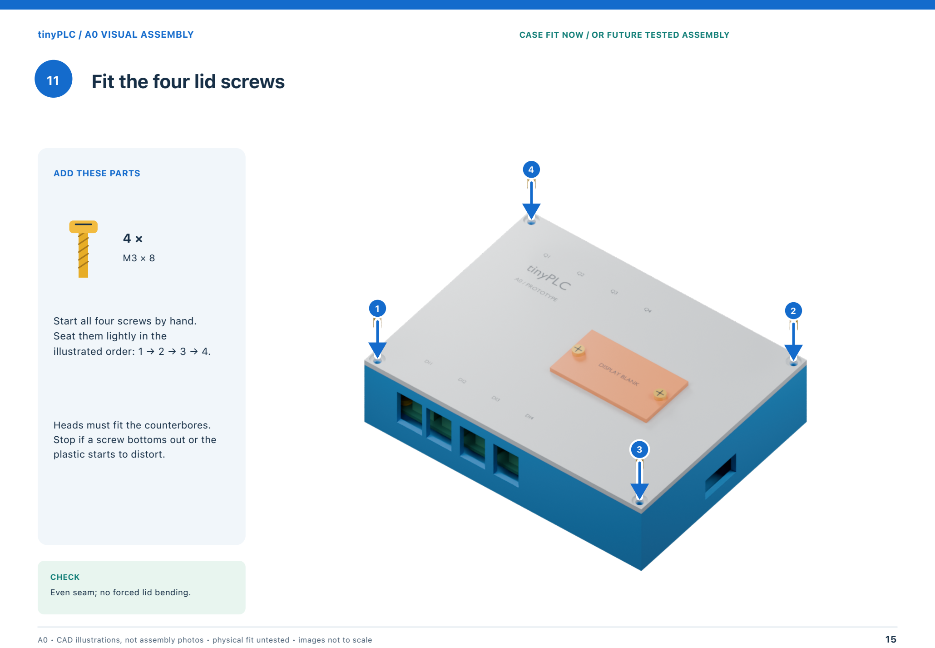
[picture p51: page 1]

tinyPLC / A0 VISUAL ASSEMBLY | CASE FIT NOW / OR FUTURE TESTED ASSEMBLY
A0 • CAD illustrations, not assembly photos • physical fit untested • images not to scale | 15

ADD THESE PARTS

4 ×

M3 × 8

Start all four screws by hand.

### Seat them lightly in the

illustrated order: 1 → 2 → 3 → 4.

Heads must fit the counterbores. Stop if a screw bottoms out or the plastic starts to distort.

1 | 2

3

4

CHECK
Even seam; no forced lid bending.
