sergiogallegos/tinyplc/hardware/prototype-a1/renders/step-base.png

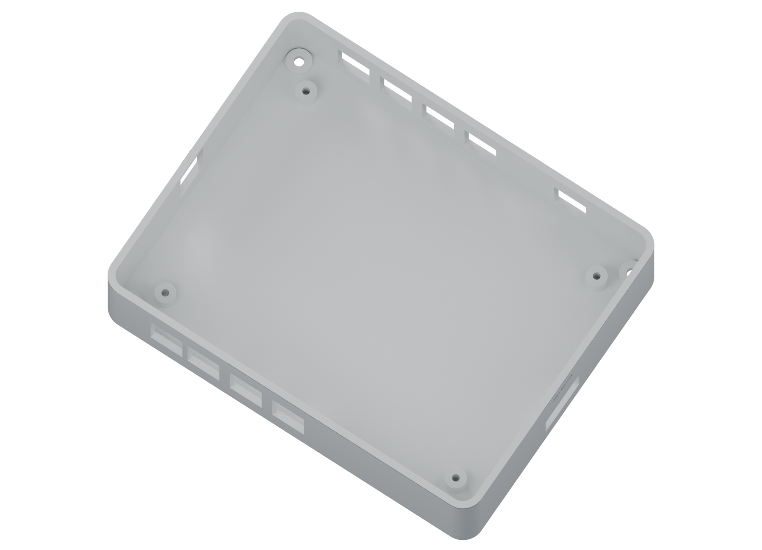
hardware/prototype-a1/renders/step-base.png
