sergiogallegos/tinyplc/hardware/prototype-a1/renders/step-board-screws.png

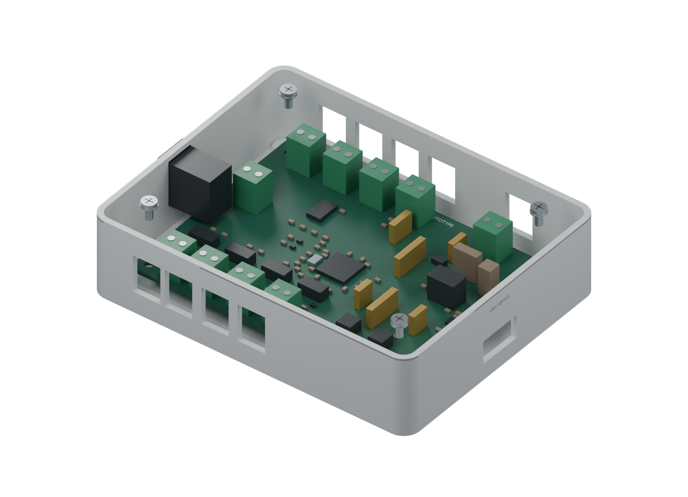
hardware/prototype-a1/renders/step-board-screws.png
