sergiogallegos/tinyplc/hardware/prototype-a1/renders/step-board.png

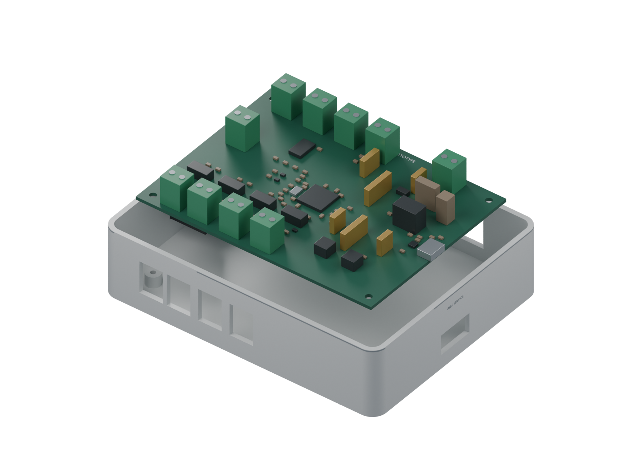
hardware/prototype-a1/renders/step-board.png
