sergiogallegos/tinyplc/hardware/prototype-a1/renders/step-close.png

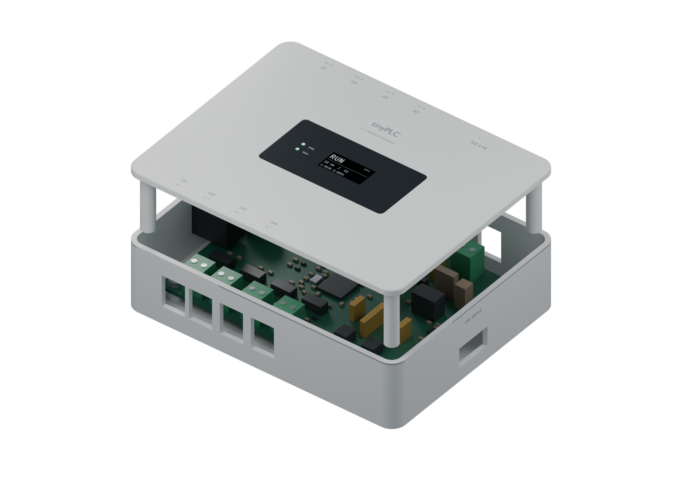
hardware/prototype-a1/renders/step-close.png
