sergiogallegos/tinyplc/hardware/prototype-a1/renders/step-lid.png

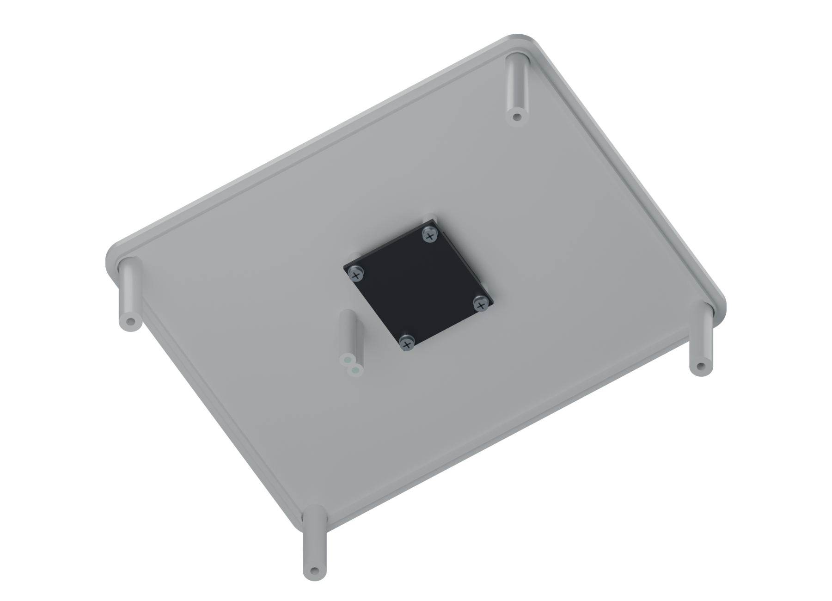
hardware/prototype-a1/renders/step-lid.png
