sergiogallegos/tinyplc/hardware/prototype-a1/renders/step-optics.png

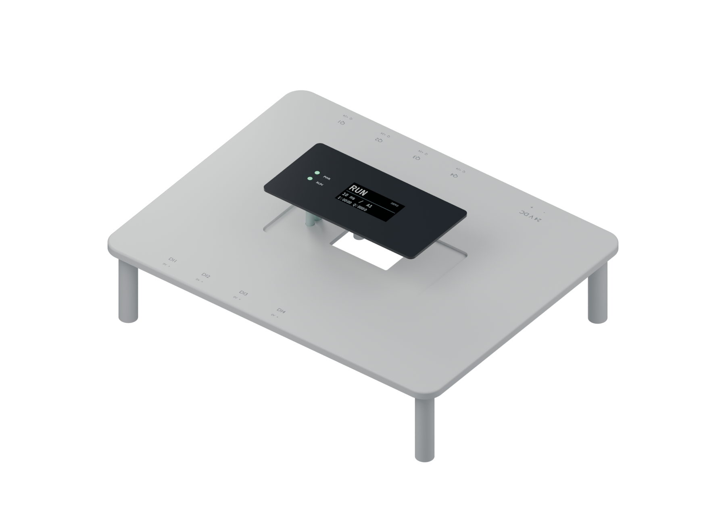
hardware/prototype-a1/renders/step-optics.png
