sergiogallegos/tinyplc/hardware/prototype-a1/renders/step-switch.png

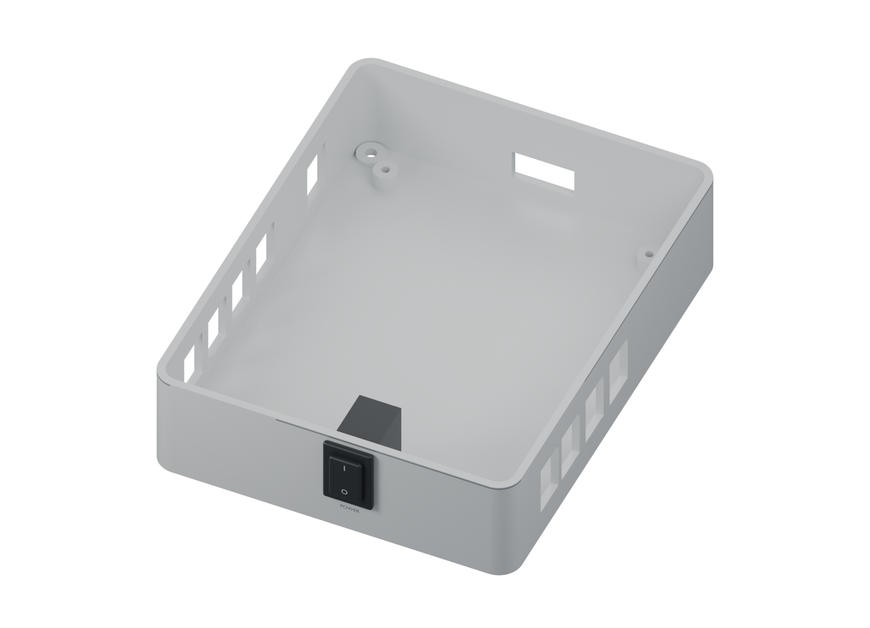
hardware/prototype-a1/renders/step-switch.png
