sergiogallegos/tinyplc/hardware/prototype-a/renders/assembly/01-coupon.png

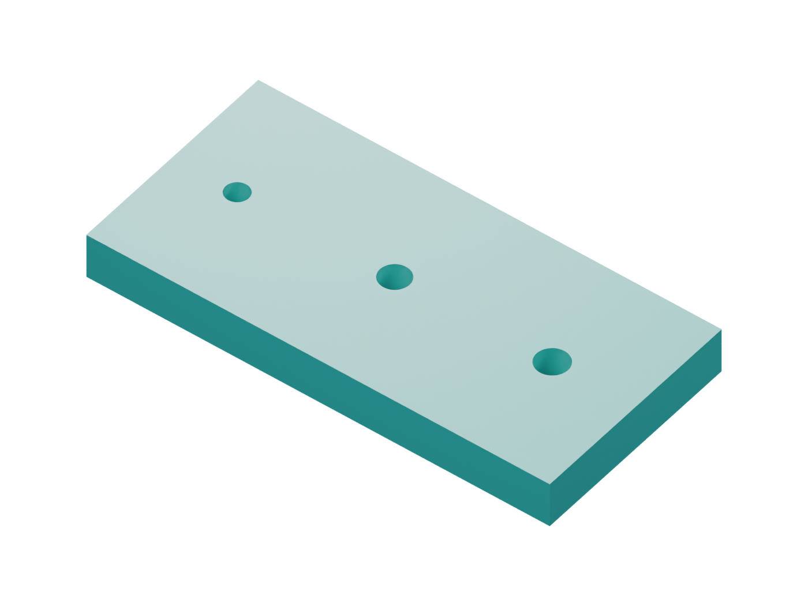
hardware/prototype-a/renders/assembly/01-coupon.png
