sergiogallegos/tinyplc/hardware/prototype-a/renders/assembly/02-base.png

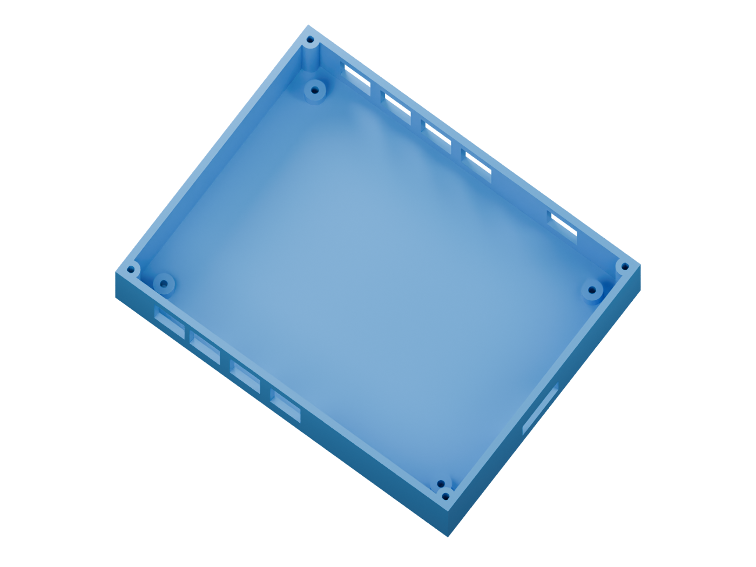
hardware/prototype-a/renders/assembly/02-base.png
