sergiogallegos/tinyplc/hardware/prototype-a/renders/assembly/03-template.png

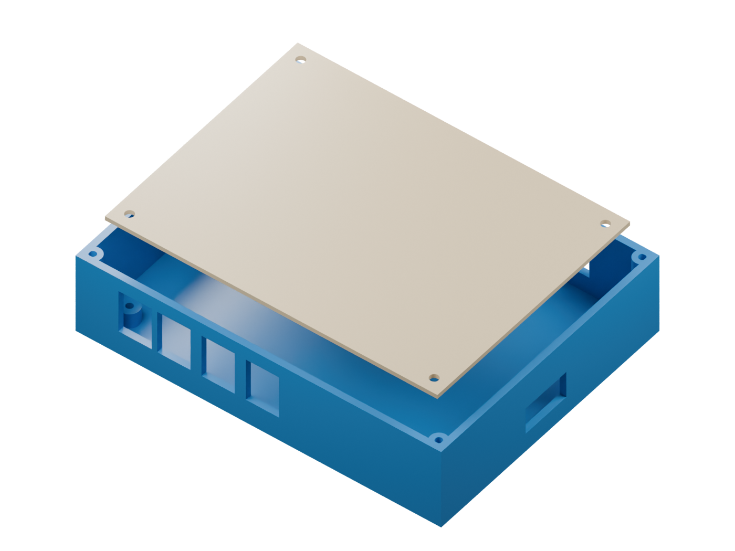
hardware/prototype-a/renders/assembly/03-template.png
