sergiogallegos/tinyplc/hardware/prototype-a/renders/assembly/04-board.png

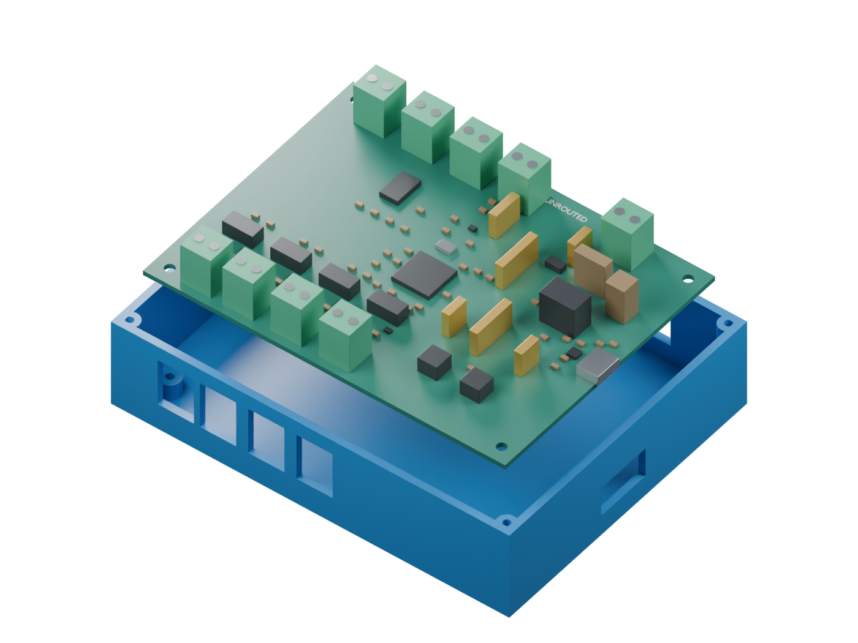
hardware/prototype-a/renders/assembly/04-board.png
