sergiogallegos/tinyplc/hardware/prototype-a/renders/assembly/05-board-screws.png

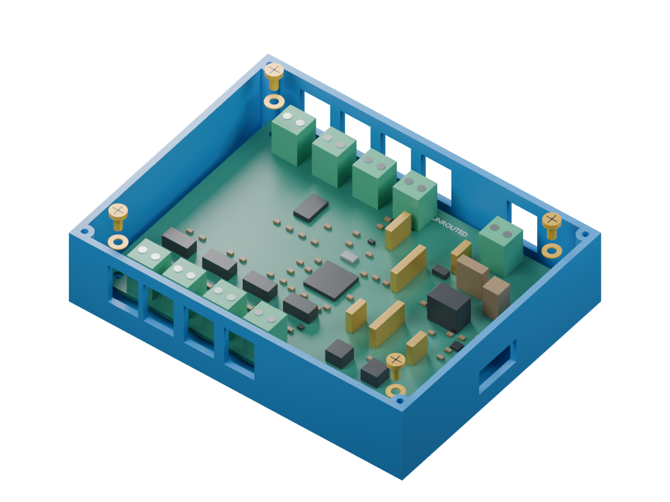
hardware/prototype-a/renders/assembly/05-board-screws.png
