sergiogallegos/tinyplc/hardware/prototype-a/renders/assembly/06-blank.png

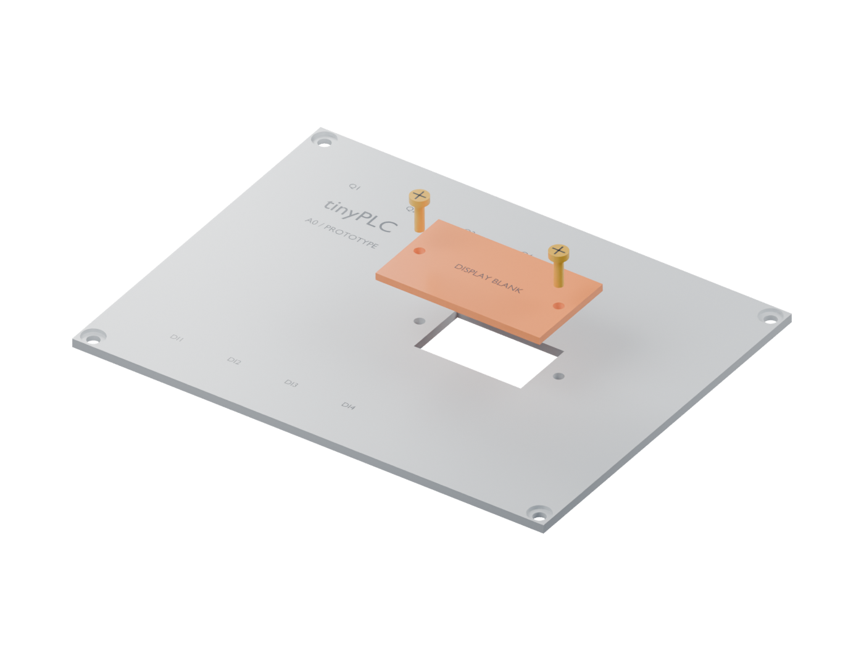
hardware/prototype-a/renders/assembly/06-blank.png
