sergiogallegos/tinyplc/hardware/prototype-a/renders/assembly/06-under-lid.png

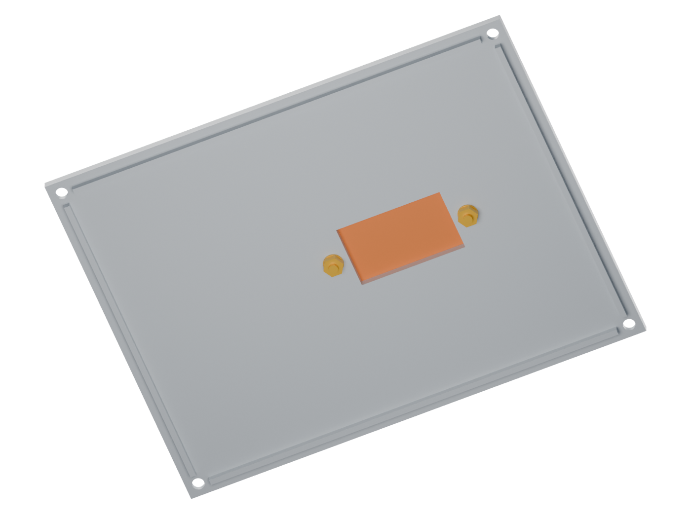
hardware/prototype-a/renders/assembly/06-under-lid.png
