sergiogallegos/tinyplc/hardware/prototype-a/renders/assembly/07-lid-ready.png

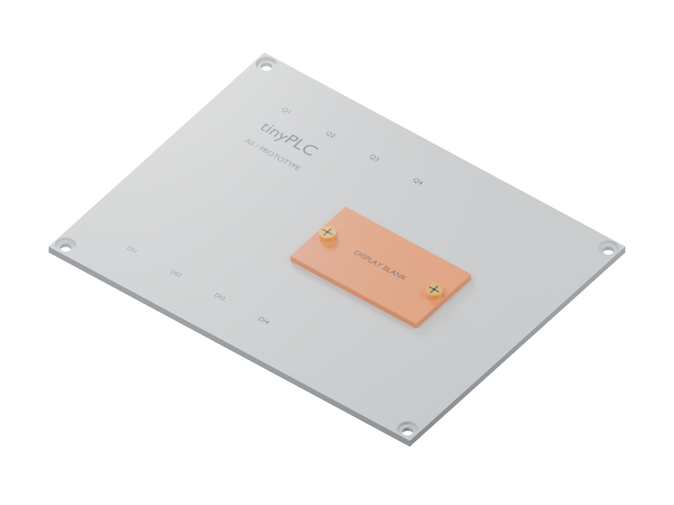
hardware/prototype-a/renders/assembly/07-lid-ready.png
