sergiogallegos/tinyplc/hardware/prototype-a/renders/assembly/08-inspect.png

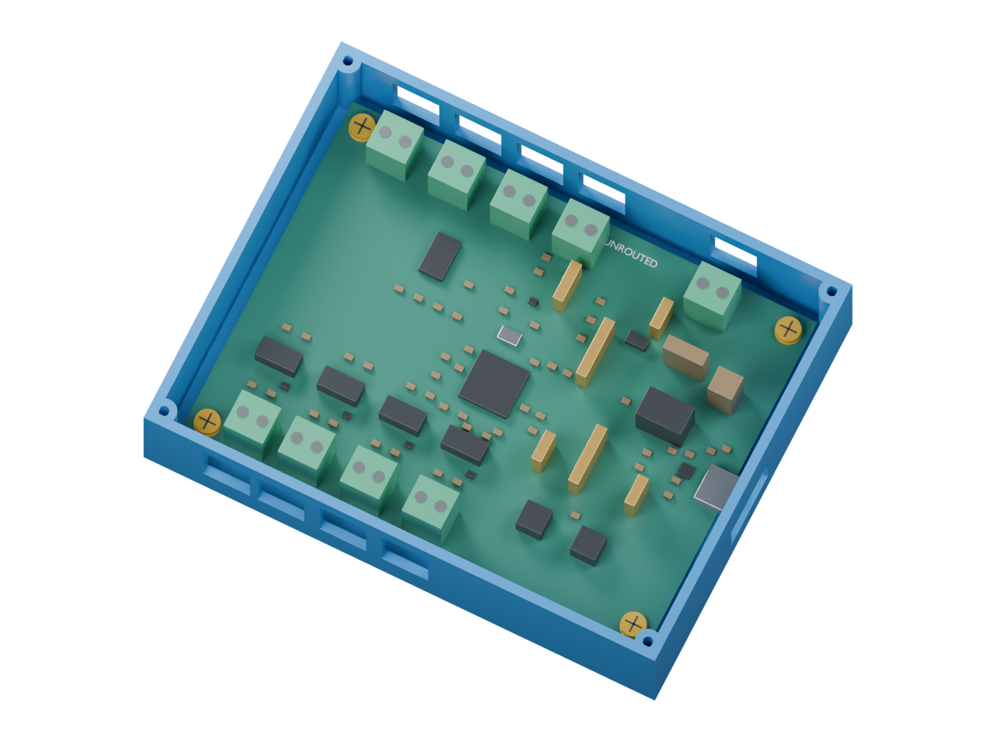
hardware/prototype-a/renders/assembly/08-inspect.png
