sergiogallegos/tinyplc/hardware/prototype-a/renders/assembly/09-close.png

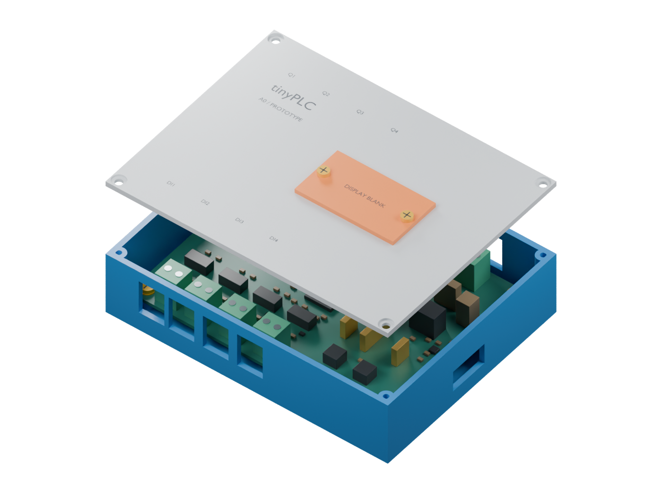
hardware/prototype-a/renders/assembly/09-close.png
