sergiogallegos/tinyplc/hardware/prototype-a/renders/assembly/10-lid-screws.png

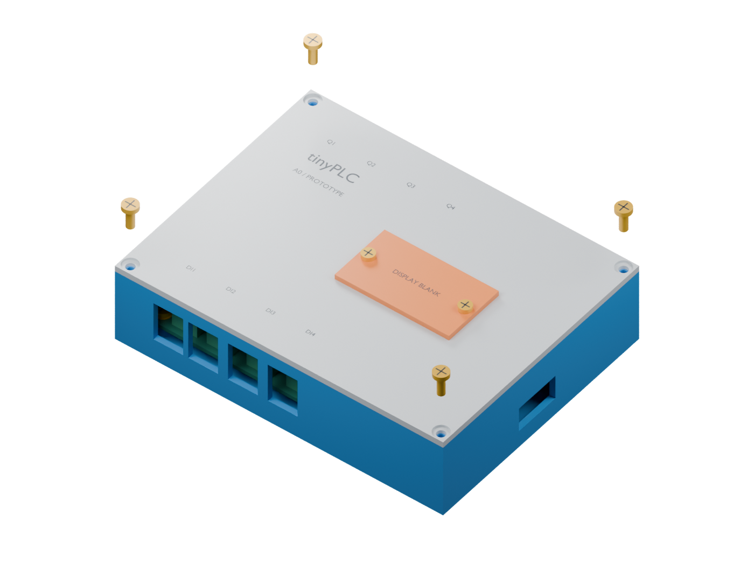
hardware/prototype-a/renders/assembly/10-lid-screws.png
