sergiogallegos/tinyplc/hardware/prototype-a/renders/assembly/11-complete.png

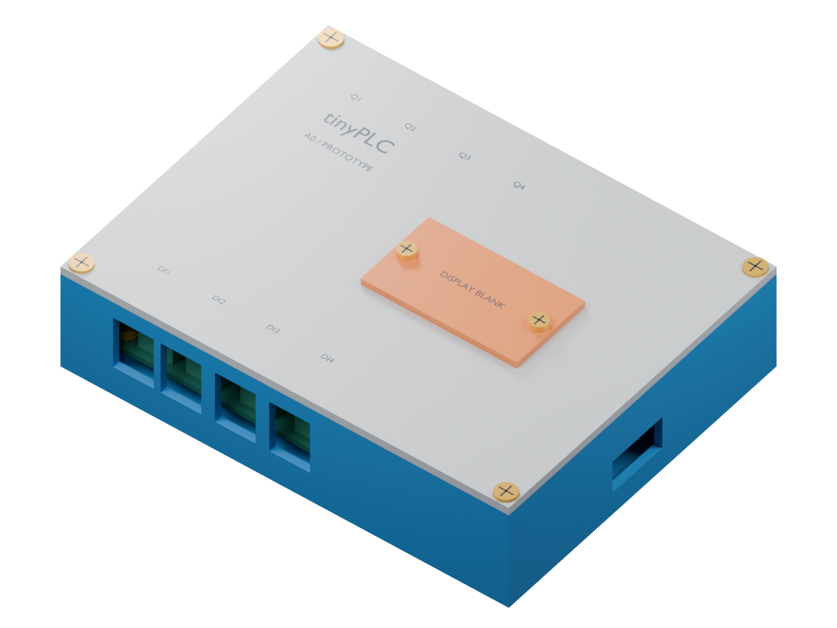
hardware/prototype-a/renders/assembly/11-complete.png
