sergiogallegos/tinyplc/hardware/prototype-a/renders/assembly/part-base.png

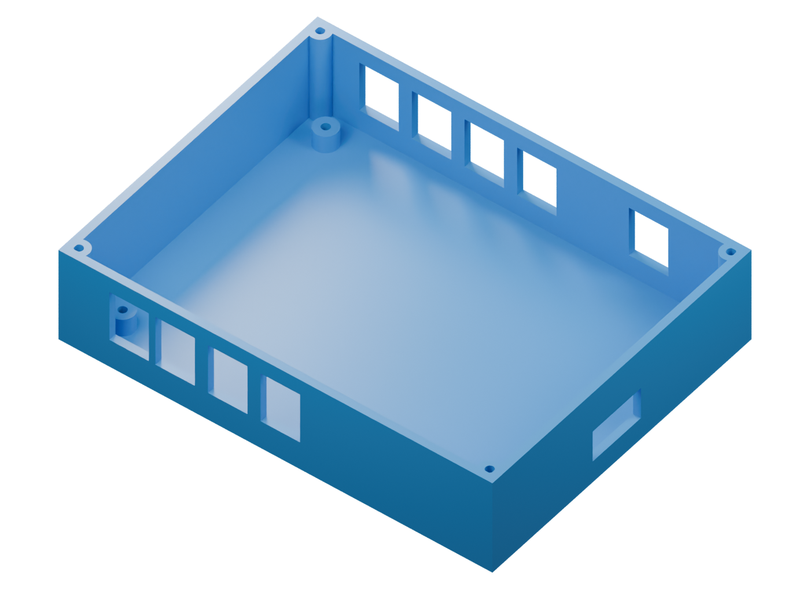
hardware/prototype-a/renders/assembly/part-base.png
