sergiogallegos/tinyplc/hardware/prototype-a/renders/assembly/part-blank.png

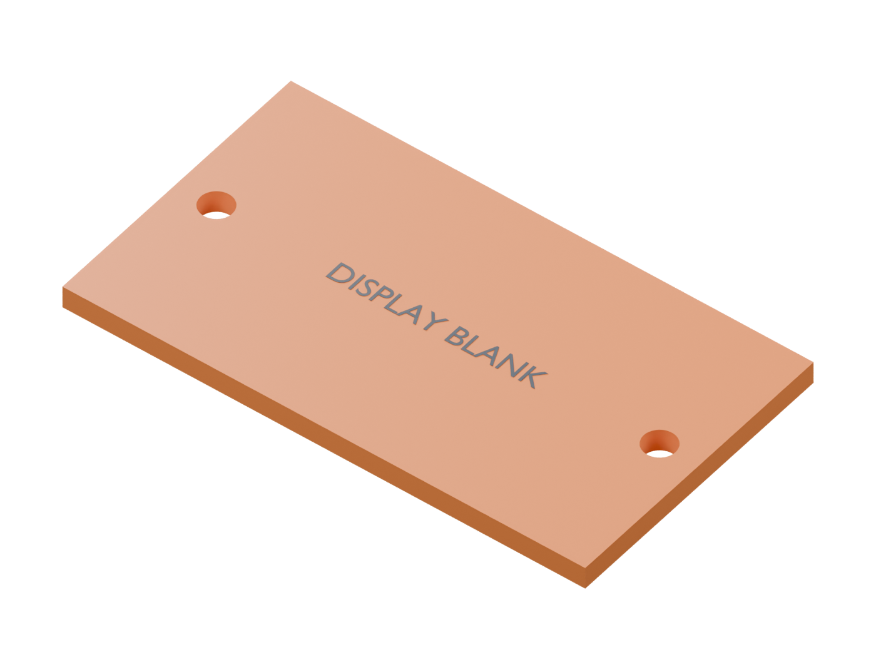
hardware/prototype-a/renders/assembly/part-blank.png
