sergiogallegos/tinyplc/hardware/prototype-a/renders/assembly/part-board.png

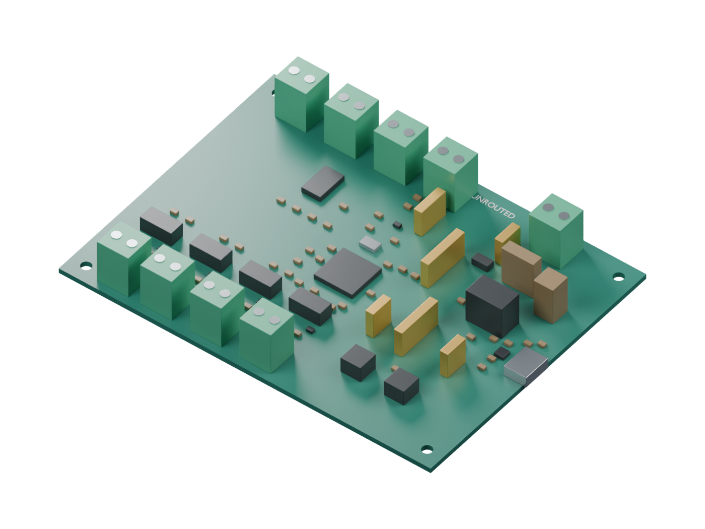
hardware/prototype-a/renders/assembly/part-board.png
