sergiogallegos/tinyplc/hardware/prototype-a/renders/assembly/part-lid.png

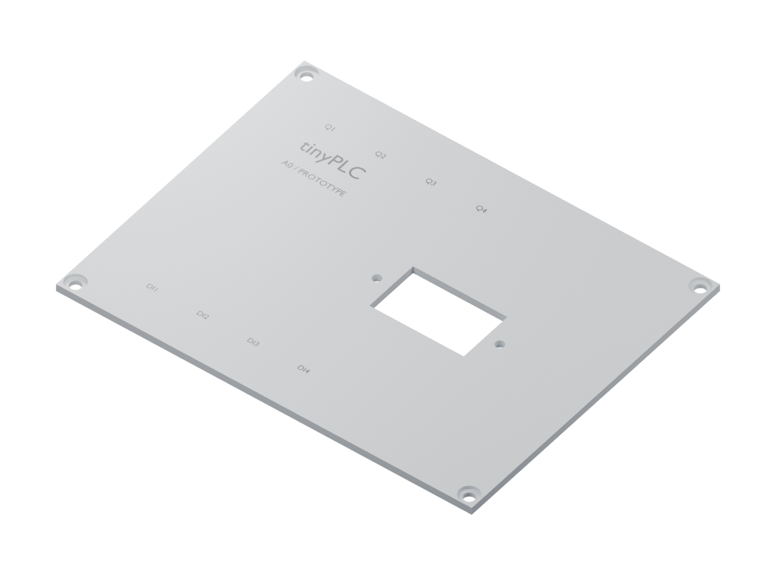
hardware/prototype-a/renders/assembly/part-lid.png
