sergiogallegos/tinyplc/hardware/prototype-a/renders/tinyplc-a0-assembled.png

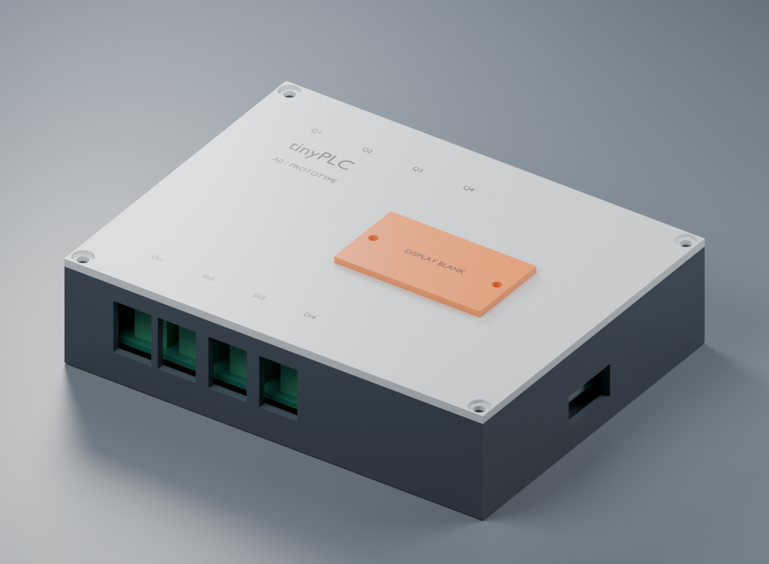
hardware/prototype-a/renders/tinyplc-a0-assembled.png
