sergiogallegos/tinyplc/docs/evidence/R5.1-ton-debugger.txt

Open On-Chip Debugger 0.12.0
Licensed under GNU GPL v2
For bug reports, read
	http://openocd.org/doc/doxygen/bugs.html
Info : auto-selecting first available session transport "hla_swd". To override use 'transport select <transport>'.
Info : The selected transport took over low-level target control. The results might differ compared to plain JTAG/SWD
Info : clock speed 1000 kHz
Info : STLINK V2J46M33 (API v2) VID:PID 0483:374B
Info : Target voltage: 3.235194
Info : [stm32f4x.cpu] Cortex-M4 r0p1 processor detected
Info : [stm32f4x.cpu] target has 6 breakpoints, 4 watchpoints
Info : starting gdb server for stm32f4x.cpu on 3333
Info : Listening on port 3333 for gdb connections
[stm32f4x.cpu] halted due to debug-request, current mode: Thread 
xPSR: 0x61000000 pc: 0x080004c4 psp: 0x200015d8
DATA scan_count 0x352
DATA native_status 0x0
DATA assertion_latched 0x0
DATA scan_body_cycles_max 0x10ba1
DATA missed_releases 0x0
DATA uart_rx_errors 0x0
DATA stack_free_words 0x1b6
DATA worker_stack_free_words 0x1d0
DATA comms_stack_free_words 0x3a0
shutdown command invoked
