sergiogallegos/tinyplc/docs/evidence/R4.3-debugger.txt

=== update-board/flash ===
Open On-Chip Debugger 0.12.0
Licensed under GNU GPL v2
For bug reports, read
	http://openocd.org/doc/doxygen/bugs.html
Info : auto-selecting first available session transport "hla_swd". To override use 'transport select <transport>'.
Info : The selected transport took over low-level target control. The results might differ compared to plain JTAG/SWD
Info : clock speed 1000 kHz
Info : STLINK V2J46M33 (API v2) VID:PID 0483:374B
Info : Target voltage: 3.238345
Info : [stm32f4x.cpu] Cortex-M4 r0p1 processor detected
Info : [stm32f4x.cpu] target has 6 breakpoints, 4 watchpoints
Info : starting gdb server for stm32f4x.cpu on 3333
Info : Listening on port 3333 for gdb connections
Info : Unable to match requested speed 2000 kHz, using 1800 kHz
Info : Unable to match requested speed 2000 kHz, using 1800 kHz
[stm32f4x.cpu] halted due to debug-request, current mode: Thread 
xPSR: 0x01000000 pc: 0x08003a58 msp: 0x20010000
Info : Unable to match requested speed 8000 kHz, using 4000 kHz
Info : Unable to match requested speed 8000 kHz, using 4000 kHz
** Programming Started **
Info : device id = 0x10006421
Info : flash size = 512 KiB
Info : Flash write discontinued at 0x08006ff0, next section at 0x08010000
** Programming Finished **
** Verify Started **
** Verified OK **
** Resetting Target **
Info : Unable to match requested speed 2000 kHz, using 1800 kHz
Info : Unable to match requested speed 2000 kHz, using 1800 kHz
shutdown command invoked

=== update-board/migration-timing ===
Open On-Chip Debugger 0.12.0
Licensed under GNU GPL v2
For bug reports, read
	http://openocd.org/doc/doxygen/bugs.html
Info : auto-selecting first available session transport "hla_swd". To override use 'transport select <transport>'.
Info : The selected transport took over low-level target control. The results might differ compared to plain JTAG/SWD
Info : clock speed 1000 kHz
Info : STLINK V2J46M33 (API v2) VID:PID 0483:374B
Info : Target voltage: 3.233618
Info : [stm32f4x.cpu] Cortex-M4 r0p1 processor detected
Info : [stm32f4x.cpu] target has 6 breakpoints, 4 watchpoints
Info : starting gdb server for stm32f4x.cpu on 3333
Info : Listening on port 3333 for gdb connections
[stm32f4x.cpu] halted due to debug-request, current mode: Thread 
xPSR: 0x61000000 pc: 0x08000aca psp: 0x20005fc8
DATA scan_count 0x28b
DATA native_status 0x0
DATA assertion_latched 0x0
DATA scan_body_cycles_max 0xb530
DATA missed_releases 0x0
DATA uart_rx_errors 0x0
DATA stack_free_words 0x1b6
DATA worker_stack_free_words 0x1f6
DATA comms_stack_free_words 0x3a0
shutdown command invoked

=== update-board/maximum-migration-timing ===
Open On-Chip Debugger 0.12.0
Licensed under GNU GPL v2
For bug reports, read
	http://openocd.org/doc/doxygen/bugs.html
Info : auto-selecting first available session transport "hla_swd". To override use 'transport select <transport>'.
Info : The selected transport took over low-level target control. The results might differ compared to plain JTAG/SWD
Info : clock speed 1000 kHz
Info : STLINK V2J46M33 (API v2) VID:PID 0483:374B
Info : Target voltage: 3.233618
Info : [stm32f4x.cpu] Cortex-M4 r0p1 processor detected
Info : [stm32f4x.cpu] target has 6 breakpoints, 4 watchpoints
Info : starting gdb server for stm32f4x.cpu on 3333
Info : Listening on port 3333 for gdb connections
[stm32f4x.cpu] halted due to debug-request, current mode: Thread 
xPSR: 0x61000000 pc: 0x08000ac4 psp: 0x20005fc8
DATA scan_count 0x231
DATA native_status 0x0
DATA assertion_latched 0x0
DATA scan_body_cycles_max 0x15fcf
DATA missed_releases 0x0
DATA uart_rx_errors 0x0
DATA stack_free_words 0x1b6
DATA worker_stack_free_words 0x1f6
DATA comms_stack_free_words 0x3a0
shutdown command invoked

=== update-board/restore-normal ===
Open On-Chip Debugger 0.12.0
Licensed under GNU GPL v2
For bug reports, read
	http://openocd.org/doc/doxygen/bugs.html
Info : auto-selecting first available session transport "hla_swd". To override use 'transport select <transport>'.
Info : The selected transport took over low-level target control. The results might differ compared to plain JTAG/SWD
Info : clock speed 1000 kHz
Info : STLINK V2J46M33 (API v2) VID:PID 0483:374B
Info : Target voltage: 3.236769
Info : [stm32f4x.cpu] Cortex-M4 r0p1 processor detected
Info : [stm32f4x.cpu] target has 6 breakpoints, 4 watchpoints
Info : starting gdb server for stm32f4x.cpu on 3333
Info : Listening on port 3333 for gdb connections
Info : Unable to match requested speed 2000 kHz, using 1800 kHz
Info : Unable to match requested speed 2000 kHz, using 1800 kHz
shutdown command invoked

=== monitor-board/boot-baseline ===
Open On-Chip Debugger 0.12.0
Licensed under GNU GPL v2
For bug reports, read
	http://openocd.org/doc/doxygen/bugs.html
Info : auto-selecting first available session transport "hla_swd". To override use 'transport select <transport>'.
Info : The selected transport took over low-level target control. The results might differ compared to plain JTAG/SWD
Info : clock speed 1000 kHz
Info : STLINK V2J46M33 (API v2) VID:PID 0483:374B
Info : Target voltage: 3.239921
Info : [stm32f4x.cpu] Cortex-M4 r0p1 processor detected
Info : [stm32f4x.cpu] target has 6 breakpoints, 4 watchpoints
Info : starting gdb server for stm32f4x.cpu on 3333
Info : Listening on port 3333 for gdb connections
[stm32f4x.cpu] halted due to debug-request, current mode: Thread (User) 
xPSR: 0x61000000 pc: 0x2001000e psp: 0x20018ff8
DATA scan_count 0x15d
DATA native_status 0x0
DATA assertion_latched 0x0
DATA scan_cycles_max 0xd55
DATA scan_body_cycles_last 0x692b
DATA scan_body_cycles_max 0x6966
DATA period_cycles_min 0x25c13
DATA period_cycles_max 0x27100
DATA release_jitter_max 0x14ed
DATA missed_releases 0x0
DATA uart_rx_errors 0x0
DATA uart_frames 0x0
DATA comms_stack_free_words 0x3e2
DATA stack_free_words 0x1c0
DATA worker_stack_free_words 0x1f6
shutdown command invoked

=== monitor-board/maximum-baseline ===
Open On-Chip Debugger 0.12.0
Licensed under GNU GPL v2
For bug reports, read
	http://openocd.org/doc/doxygen/bugs.html
Info : auto-selecting first available session transport "hla_swd". To override use 'transport select <transport>'.
Info : The selected transport took over low-level target control. The results might differ compared to plain JTAG/SWD
Info : clock speed 1000 kHz
Info : STLINK V2J46M33 (API v2) VID:PID 0483:374B
Info : Target voltage: 3.243073
Info : [stm32f4x.cpu] Cortex-M4 r0p1 processor detected
Info : [stm32f4x.cpu] target has 6 breakpoints, 4 watchpoints
Info : starting gdb server for stm32f4x.cpu on 3333
Info : Listening on port 3333 for gdb connections
[stm32f4x.cpu] halted due to debug-request, current mode: Thread 
xPSR: 0x61000000 pc: 0x08000ac4 psp: 0x20005fc8
DATA scan_count 0x20f
DATA native_status 0x0
DATA assertion_latched 0x0
DATA scan_cycles_max 0xb08d
DATA scan_body_cycles_last 0xb217
DATA scan_body_cycles_max 0x10bd6
DATA period_cycles_min 0x25c0b
DATA period_cycles_max 0x2717a
DATA release_jitter_max 0x14f5
DATA missed_releases 0x0
DATA uart_rx_errors 0x0
DATA uart_frames 0x2c
DATA comms_stack_free_words 0x3a0
DATA stack_free_words 0x1b6
DATA worker_stack_free_words 0x1f6
shutdown command invoked

=== monitor-board/mixed-traffic-timing ===
Open On-Chip Debugger 0.12.0
Licensed under GNU GPL v2
For bug reports, read
	http://openocd.org/doc/doxygen/bugs.html
Info : auto-selecting first available session transport "hla_swd". To override use 'transport select <transport>'.
Info : The selected transport took over low-level target control. The results might differ compared to plain JTAG/SWD
Info : clock speed 1000 kHz
Info : STLINK V2J46M33 (API v2) VID:PID 0483:374B
Info : Target voltage: 3.236769
Info : [stm32f4x.cpu] Cortex-M4 r0p1 processor detected
Info : [stm32f4x.cpu] target has 6 breakpoints, 4 watchpoints
Info : starting gdb server for stm32f4x.cpu on 3333
Info : Listening on port 3333 for gdb connections
[stm32f4x.cpu] halted due to debug-request, current mode: Thread 
xPSR: 0x61000000 pc: 0x080004c8 psp: 0x200015d8
DATA scan_count 0x6f5
DATA native_status 0x0
DATA assertion_latched 0x0
DATA scan_cycles_max 0xb08d
DATA scan_body_cycles_last 0xb217
DATA scan_body_cycles_max 0x10bd6
DATA period_cycles_min 0x25c03
DATA period_cycles_max 0x271c3
DATA release_jitter_max 0x14fd
DATA missed_releases 0x0
DATA uart_rx_errors 0x0
DATA uart_frames 0x237
DATA comms_stack_free_words 0x3a0
DATA stack_free_words 0x1b6
DATA worker_stack_free_words 0x1f6
shutdown command invoked

=== monitor-board/restore-normal ===
Open On-Chip Debugger 0.12.0
Licensed under GNU GPL v2
For bug reports, read
	http://openocd.org/doc/doxygen/bugs.html
Info : auto-selecting first available session transport "hla_swd". To override use 'transport select <transport>'.
Info : The selected transport took over low-level target control. The results might differ compared to plain JTAG/SWD
Info : clock speed 1000 kHz
Info : STLINK V2J46M33 (API v2) VID:PID 0483:374B
Info : Target voltage: 3.233618
Info : [stm32f4x.cpu] Cortex-M4 r0p1 processor detected
Info : [stm32f4x.cpu] target has 6 breakpoints, 4 watchpoints
Info : starting gdb server for stm32f4x.cpu on 3333
Info : Listening on port 3333 for gdb connections
Info : Unable to match requested speed 2000 kHz, using 1800 kHz
Info : Unable to match requested speed 2000 kHz, using 1800 kHz
shutdown command invoked
