sergiogallegos/tinyplc/hardware/prototype-a/electronics/tinyplc-a0-schematic.pdf

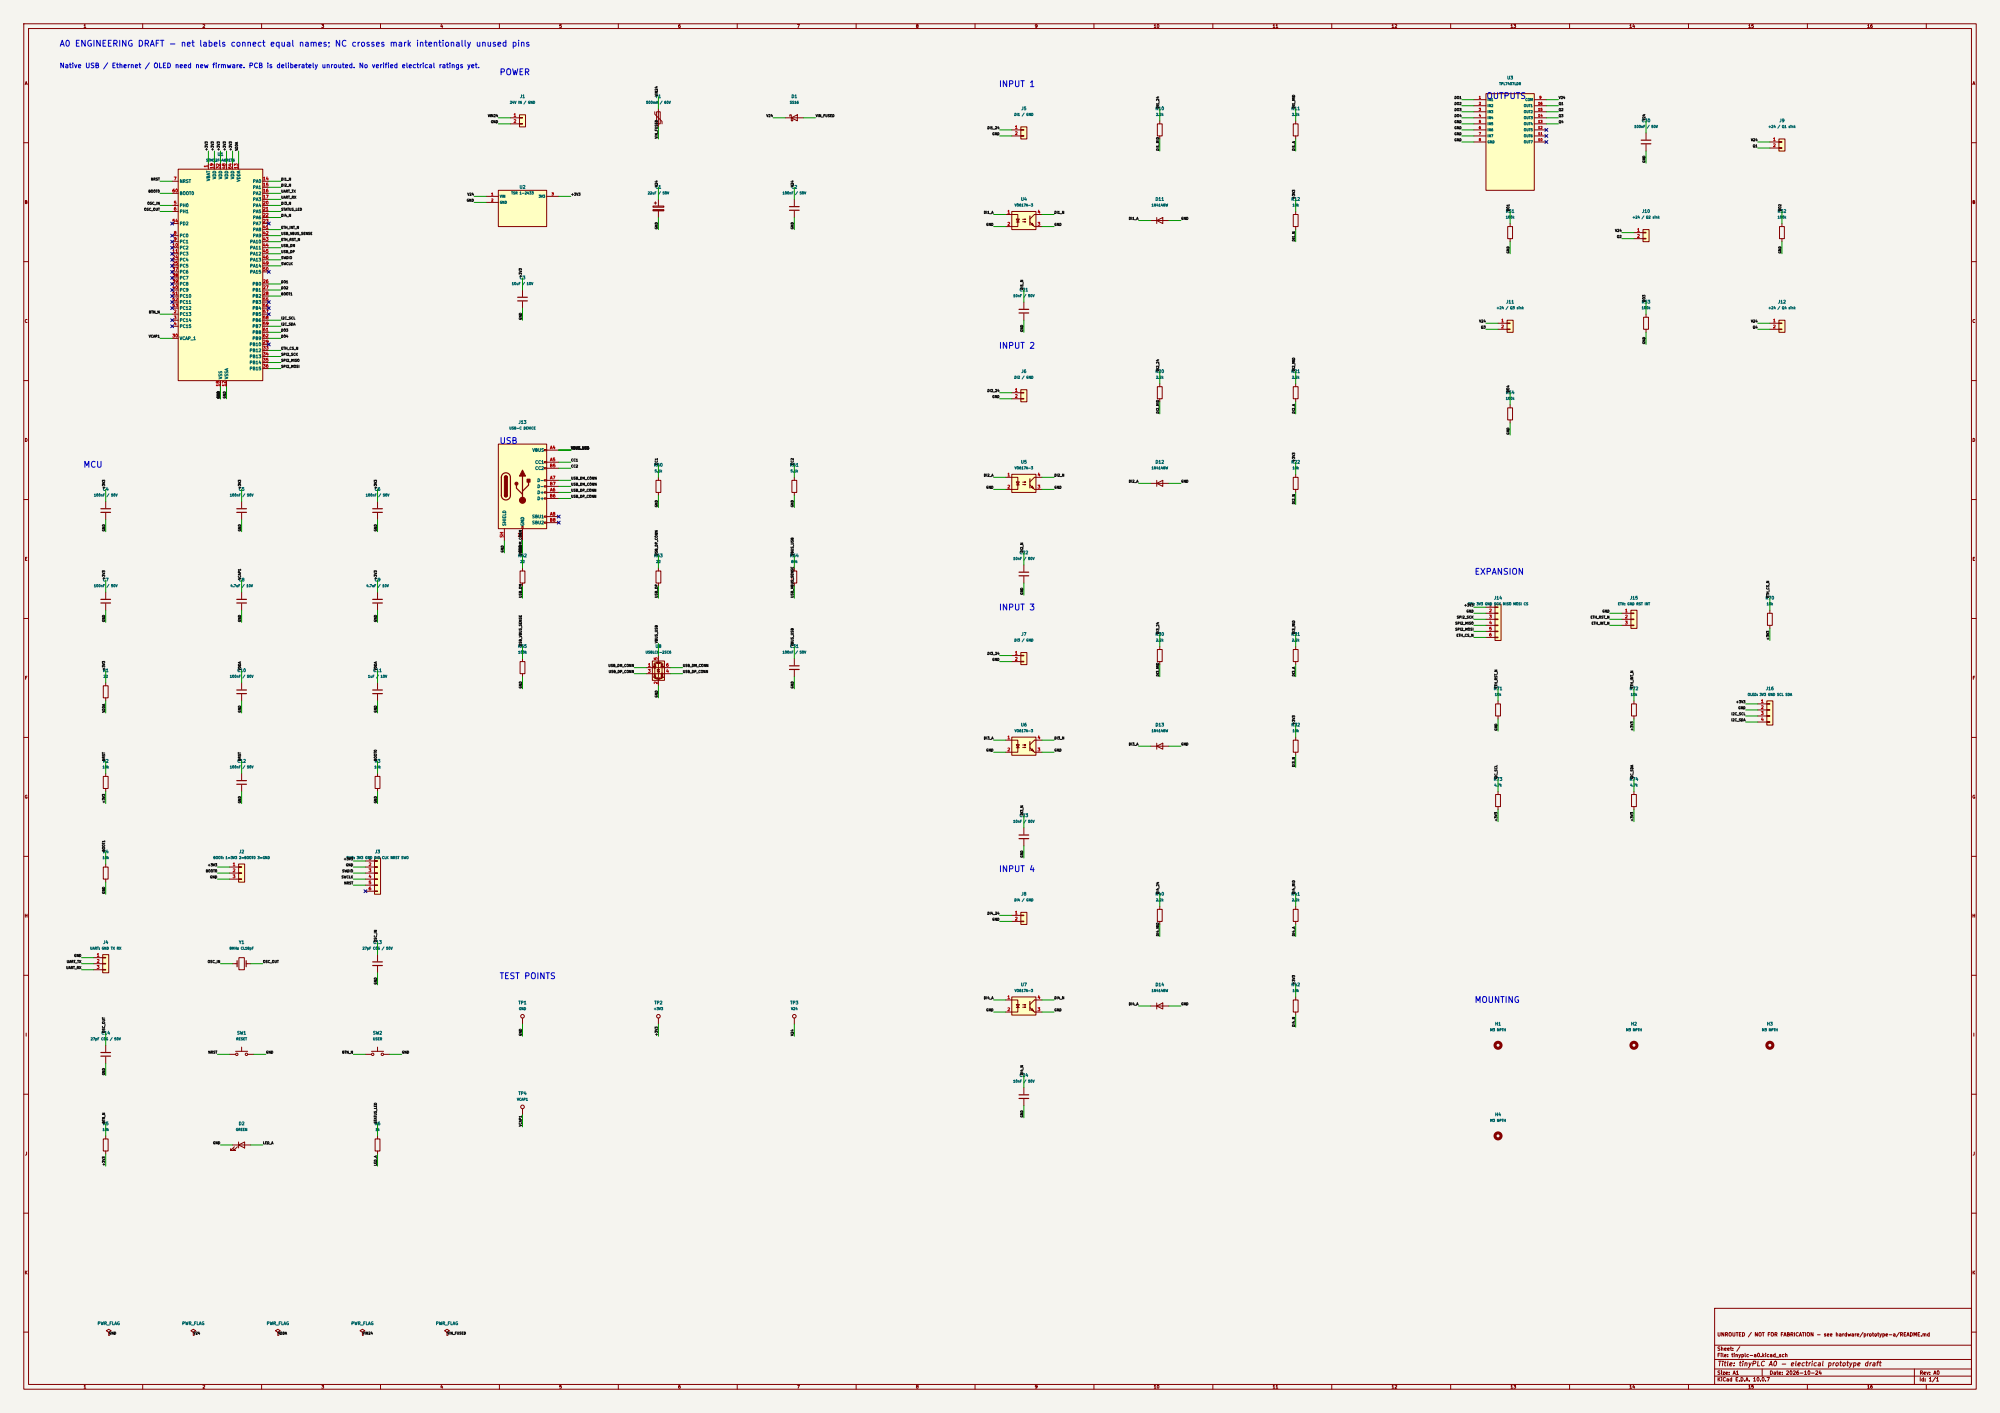
[picture p76: page 1]

A0 ENGINEERING DRAFT - net labels connect equal names; NC crosses mark intentionally unused pins

Native USB / Ethernet / OLED need new firmware. PCB is deliberately unrouted. No verified electrical ratings yet.

OLED: 3V3 GND SCL SDA 12

SPI: 3V3 GND SCK MISO MOSI CS R22

ETH: GND RST INT

UNROUTED / NOT FOR FABRICATION - see hardware/prototype-a/README.md

Sheet: /
File: tinyplc-a0.kicad_sch
Title: tinyPLC A0 - electrical prototype draft

Size: A1 | Rev: A0
KiCad E.D.A. 10.0.7 | Id: 1/1
