sergiogallegos/tinyplc/hardware/prototype-a1/electronics/tinyplc-a1-schematic.pdf

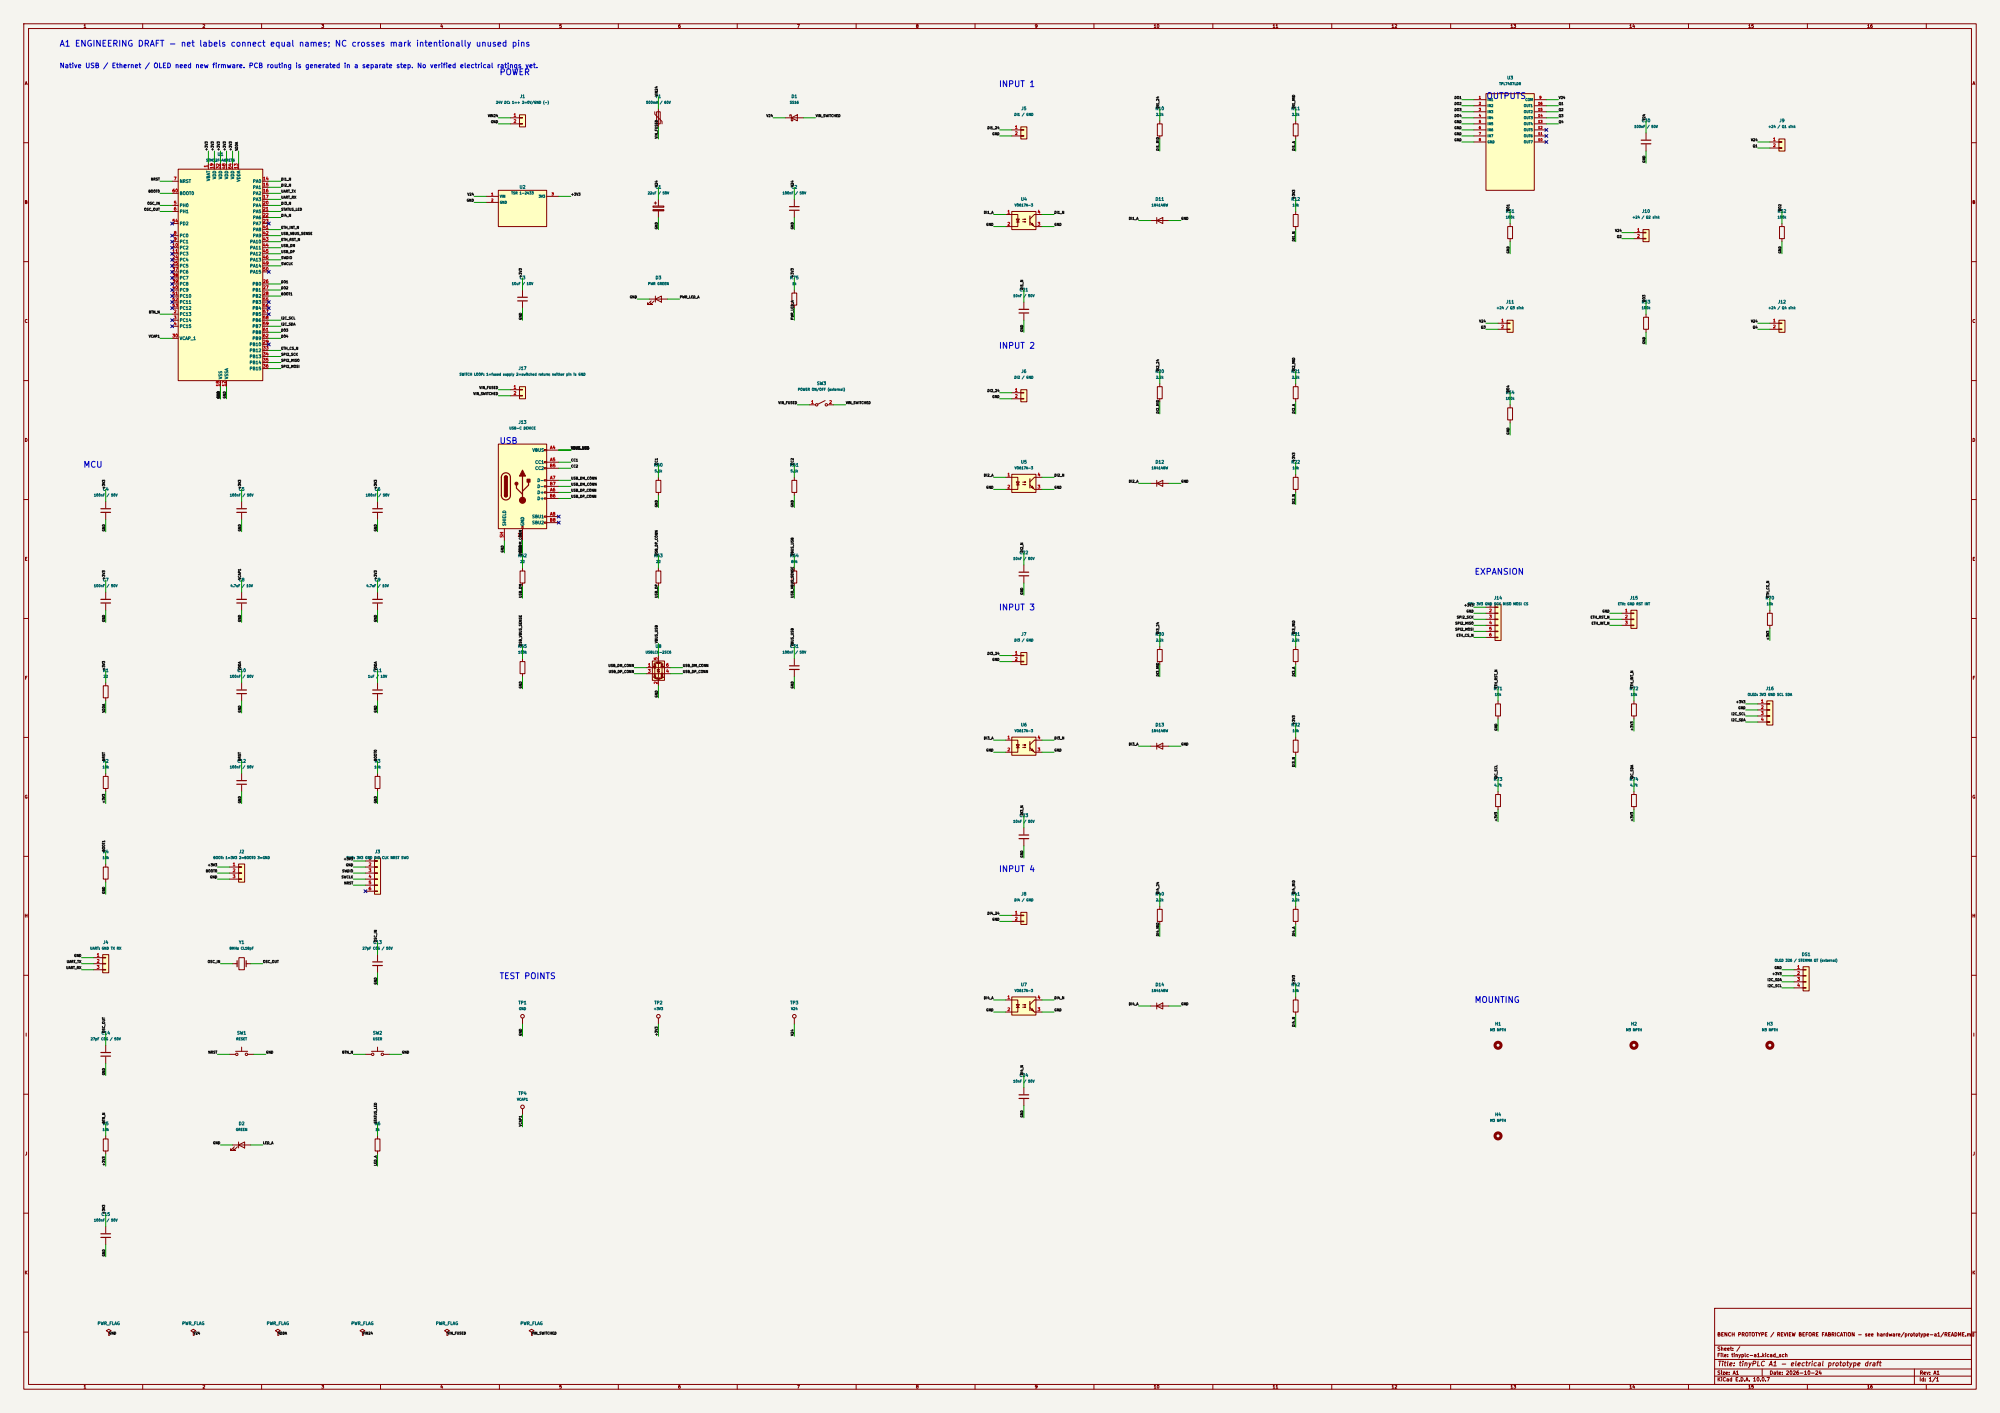
[picture p77: page 1]

A1 ENGINEERING DRAFT - net labels connect equal names; NC crosses mark intentionally unused pins

Native USB / Ethernet / OLED need new firmware. PCB routing is generated in a separate step. No verified electrical ratings yet.

ETH: GND RST INT R3

SPI: 3V3 GND SCK MISO MOSI CS

OLED: 3V3 GND SCL SDA C11

SWD: 3V3 GND DIO CLK NRST SWO C13

UART: GND TX RX
VCAP1 123

OLED 326 / STEMMA QT (external)

BENCH PROTOTYPE / REVIEW BEFORE FABRICATION - see hardware/prototype-a1/README.md

Sheet: /
File: tinyplc-a1.kicad_sch
Title: tinyPLC A1 - electrical prototype draft

Size: A1 | Rev: A1
KiCad E.D.A. 10.0.7 | Id: 1/1
