sergiogallegos/tinyplc/hardware/prototype-a/mechanical/drawings/01-base.pdf

## tinyPLC A0 / BASE / TOP AND SIDE VIEWS

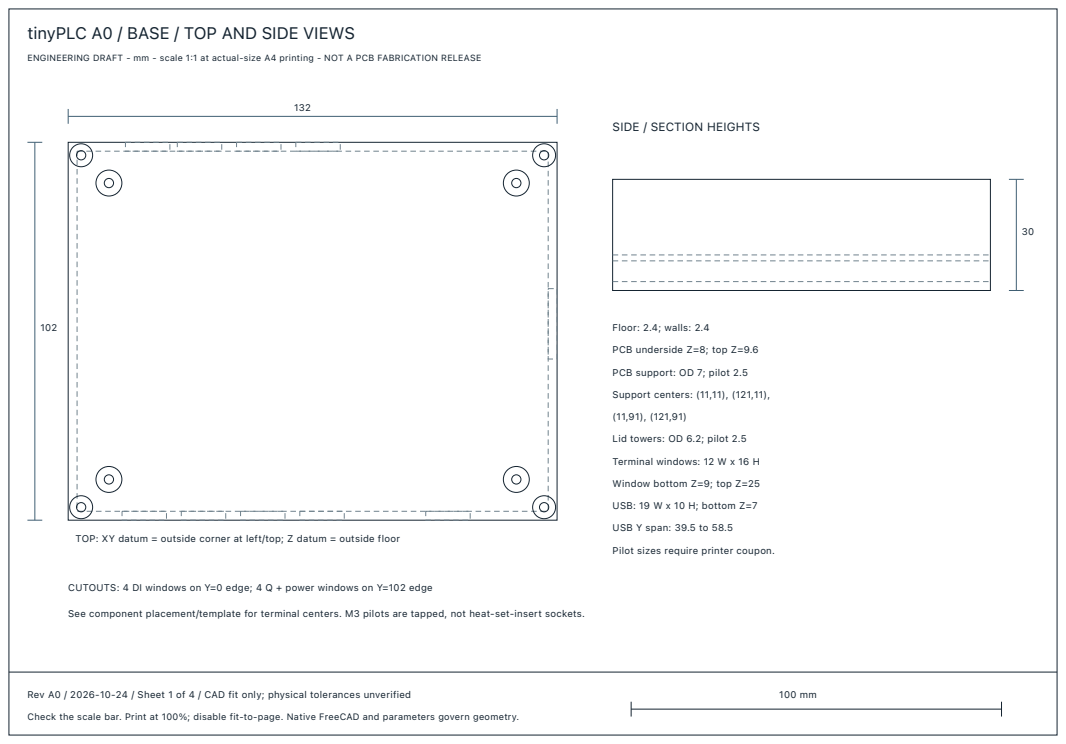
[picture p78: page 1]

ENGINEERING DRAFT - mm - scale 1:1 at actual-size A4 printing - NOT A PCB FABRICATION RELEASE

SIDE / SECTION HEIGHTS

Floor: 2.4; walls: 2.4
PCB underside Z=8; top Z=9.6
PCB support: OD 7; pilot 2.5
Support centers: (11,11), (121,11),
Lid towers: OD 6.2; pilot 2.5
Terminal windows: 12 W x 16 H
Window bottom Z=9; top Z=25
USB: 19 W x 10 H; bottom Z=7
USB Y span: 39.5 to 58.5
Pilot sizes require printer coupon.

TOP: XY datum = outside corner at left/top; Z datum = outside floor

CUTOUTS: 4 DI windows on Y=0 edge; 4 Q + power windows on Y=102 edge

See component placement/template for terminal centers. M3 pilots are tapped, not heat-set-insert sockets.

Rev A0 / 2026-10-24 / Sheet 1 of 4 / CAD fit only; physical tolerances unverified

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
