sergiogallegos/tinyplc/hardware/prototype-a/mechanical/drawings/02-lid-and-blank.pdf

## tinyPLC A0 / LID AND DISPLAY BLANK

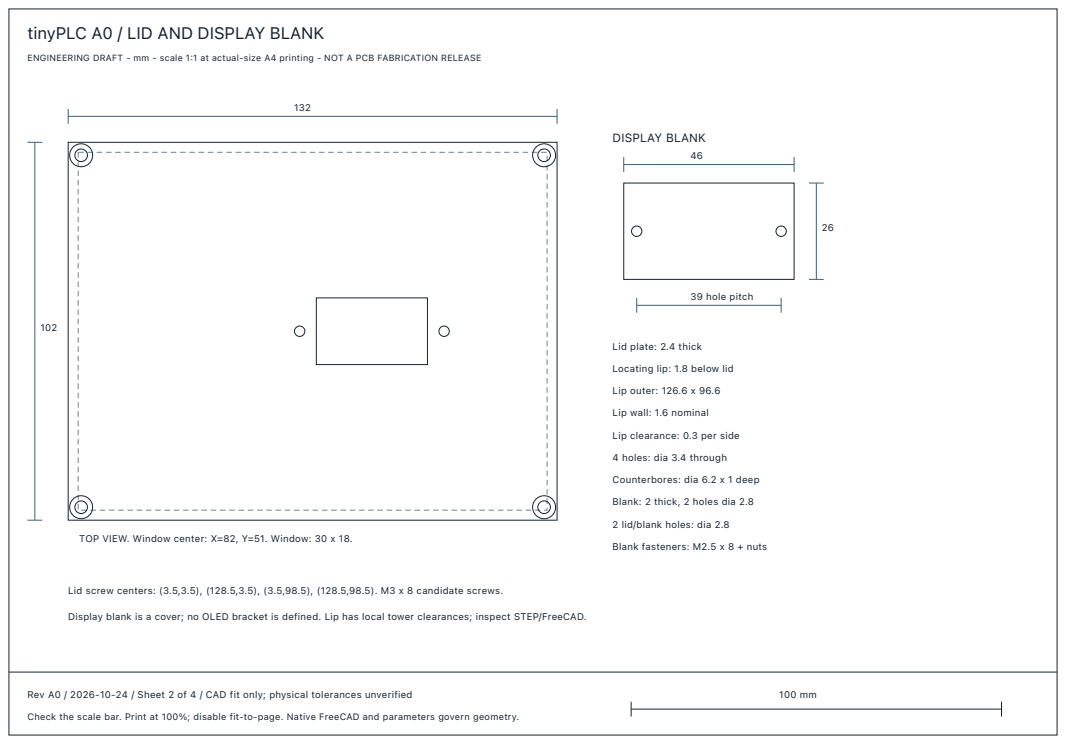
[picture p79: page 1]
DISPLAY BLANK; 39 hole pitch

ENGINEERING DRAFT - mm - scale 1:1 at actual-size A4 printing - NOT A PCB FABRICATION RELEASE

Lid plate: 2.4 thick
Locating lip: 1.8 below lid
Lip outer: 126.6 x 96.6
Lip wall: 1.6 nominal
Lip clearance: 0.3 per side
4 holes: dia 3.4 through
Counterbores: dia 6.2 x 1 deep
Blank: 2 thick, 2 holes dia 2.8
2 lid/blank holes: dia 2.8
Blank fasteners: M2.5 x 8 + nuts

TOP VIEW. Window center: X=82, Y=51. Window: 30 x 18.

Lid screw centers: (3.5,3.5), (128.5,3.5), (3.5,98.5), (128.5,98.5). M3 x 8 candidate screws.

Display blank is a cover; no OLED bracket is defined. Lip has local tower clearances; inspect STEP/FreeCAD.

Rev A0 / 2026-10-24 / Sheet 2 of 4 / CAD fit only; physical tolerances unverified

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
