sergiogallegos/tinyplc/hardware/prototype-a/mechanical/drawings/03-pcb-fit-template.pdf

## tinyPLC A0 / PCB FIT TEMPLATE / COMPONENT PLACEMENT

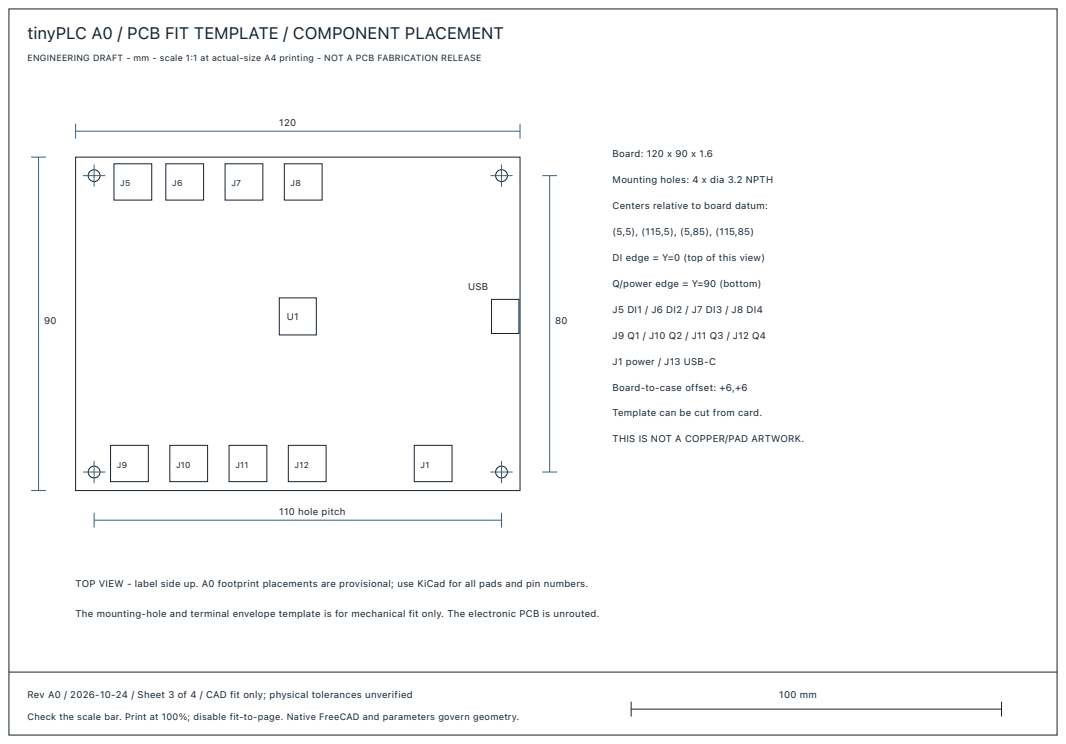
[picture p80: page 1]

ENGINEERING DRAFT - mm - scale 1:1 at actual-size A4 printing - NOT A PCB FABRICATION RELEASE

Mounting holes: 4 x dia 3.2 NPTH

Centers relative to board datum:

DI edge = Y=0 (top of this view)

Board-to-case offset: +6,+6

Template can be cut from card.

THIS IS NOT A COPPER/PAD ARTWORK.

TOP VIEW - label side up. A0 footprint placements are provisional; use KiCad for all pads and pin numbers.

The mounting-hole and terminal envelope template is for mechanical fit only. The electronic PCB is unrouted.

Rev A0 / 2026-10-24 / Sheet 3 of 4 / CAD fit only; physical tolerances unverified

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
