sergiogallegos/tinyplc/hardware/prototype-a1/mechanical/drawings/01-base.pdf

# 01 Base and concealed fastening

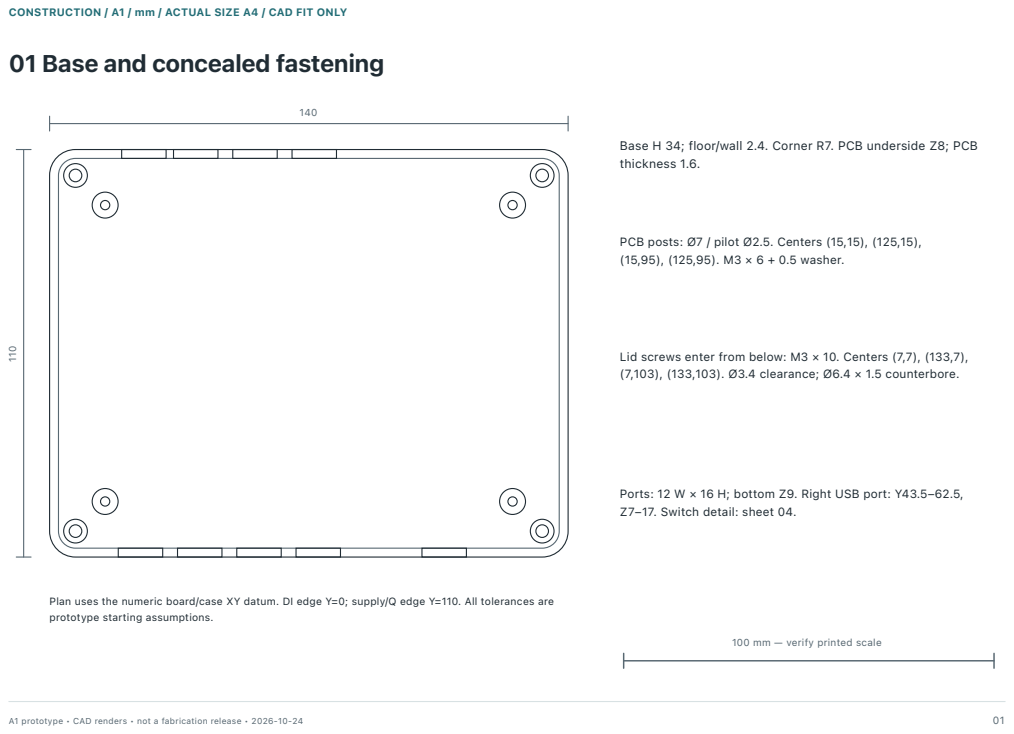
[picture p81: page 1]
A1 prototype • CAD renders • not a fabrication release • 2026-10-24

CONSTRUCTION / A1 / mm / ACTUAL SIZE A4 / CAD FIT ONLY

Base H 34; floor/wall 2.4. Corner R7. PCB underside Z8; PCB
thickness 1.6.

PCB posts: Ø7 / pilot Ø2.5. Centers (15,15), (125,15),
(15,95), (125,95). M3 × 6 + 0.5 washer.

Lid screws enter from below: M3 × 10. Centers (7,7), (133,7),
(7,103), (133,103). Ø3.4 clearance; Ø6.4 × 1.5 counterbore.

Ports: 12 W × 16 H; bottom Z9. Right USB port: Y43.5–62.5,
Z7–17. Switch detail: sheet 04.

Plan uses the numeric board/case XY datum. DI edge Y=0; supply/Q edge Y=110. All tolerances are
prototype starting assumptions.

100 mm — verify printed scale
