sergiogallegos/tinyplc/hardware/prototype-a1/mechanical/drawings/02-lid-and-optics.pdf

# 02 Lid, optics and display mounting

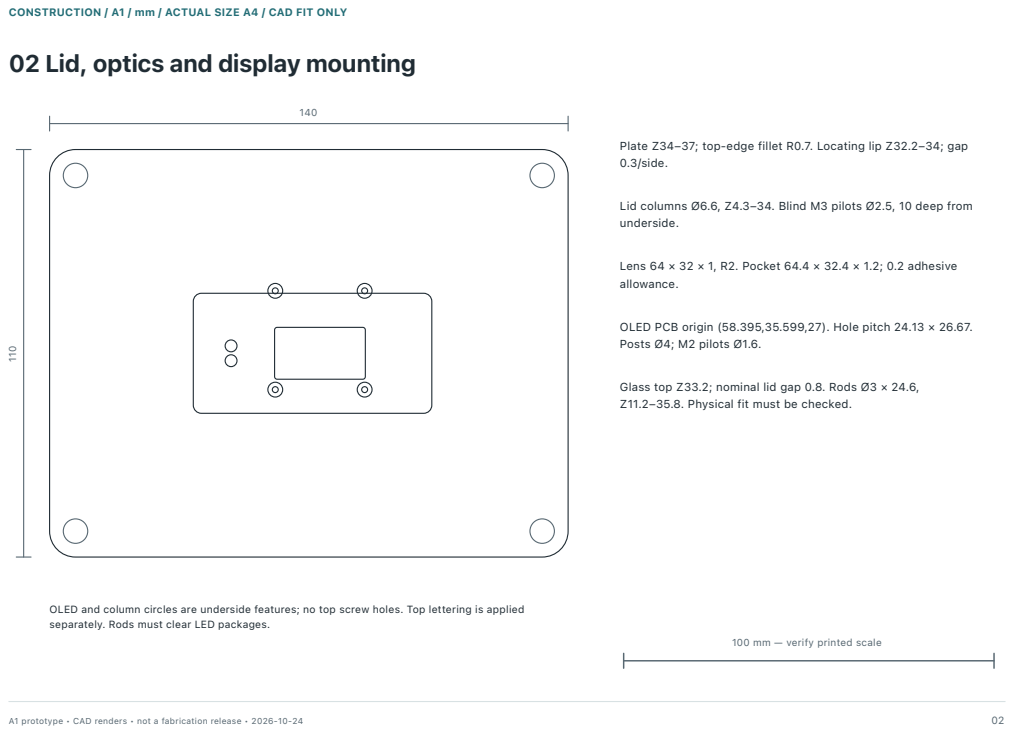
[picture p82: page 1]
A1 prototype • CAD renders • not a fabrication release • 2026-10-24

CONSTRUCTION / A1 / mm / ACTUAL SIZE A4 / CAD FIT ONLY

Plate Z34–37; top-edge fillet R0.7. Locating lip Z32.2–34; gap
0.3/side.

Lid columns Ø6.6, Z4.3–34. Blind M3 pilots Ø2.5, 10 deep from
underside.

Lens 64 × 32 × 1, R2. Pocket 64.4 × 32.4 × 1.2; 0.2 adhesive
allowance.

OLED PCB origin (58.395,35.599,27). Hole pitch 24.13 × 26.67.
Posts Ø4; M2 pilots Ø1.6.

Glass top Z33.2; nominal lid gap 0.8. Rods Ø3 × 24.6,
Z11.2–35.8. Physical fit must be checked.

OLED and column circles are underside features; no top screw holes. Top lettering is applied
separately. Rods must clear LED packages.

100 mm — verify printed scale
