sergiogallegos/tinyplc/hardware/prototype-a1/mechanical/drawings/03-pcb-fit-template.pdf

# 03 Custom PCB card fit template

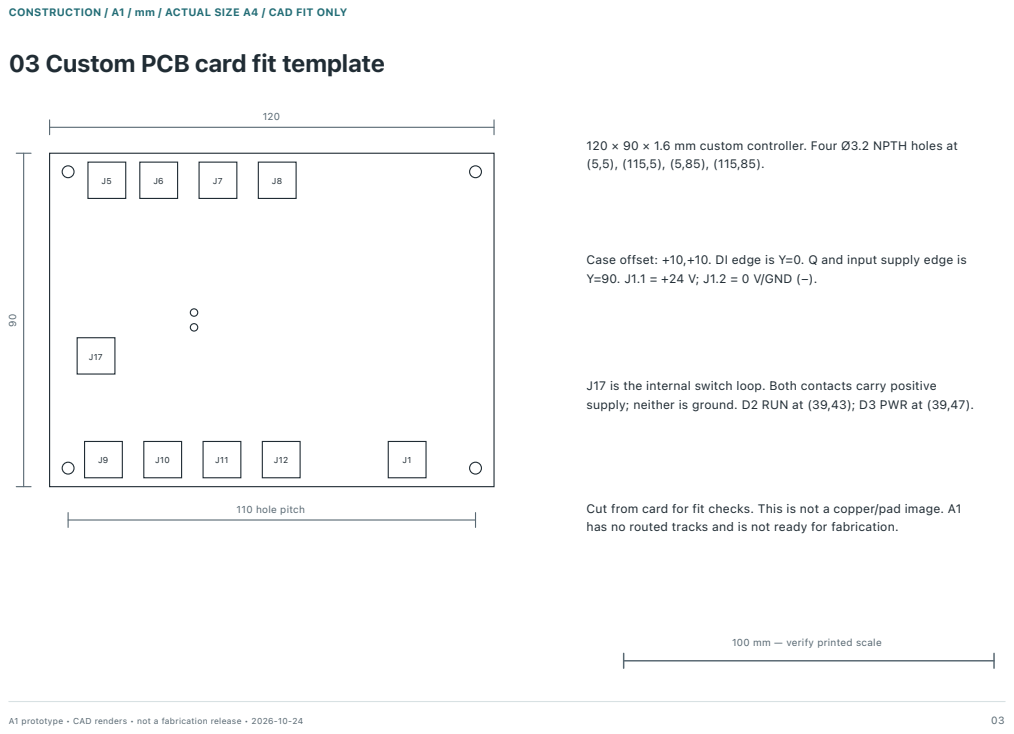
[picture p83: page 1]

CONSTRUCTION / A1 / mm / ACTUAL SIZE A4 / CAD FIT ONLY

120 × 90 × 1.6 mm custom controller. Four Ø3.2 NPTH holes at

Case offset: +10,+10. DI edge is Y=0. Q and input supply edge is
Y=90. J1.1 = +24 V; J1.2 = 0 V/GND (−).

J17 is the internal switch loop. Both contacts carry positive
supply; neither is ground. D2 RUN at (39,43); D3 PWR at (39,47).

Cut from card for fit checks. This is not a copper/pad image. A1
has no routed tracks and is not ready for fabrication.

100 mm — verify printed scale
