sergiogallegos/tinyplc/hardware/prototype-a1/mechanical/drawings/04-coupon-and-lens.pdf

# 04 Switch coupon, lens and optical rods

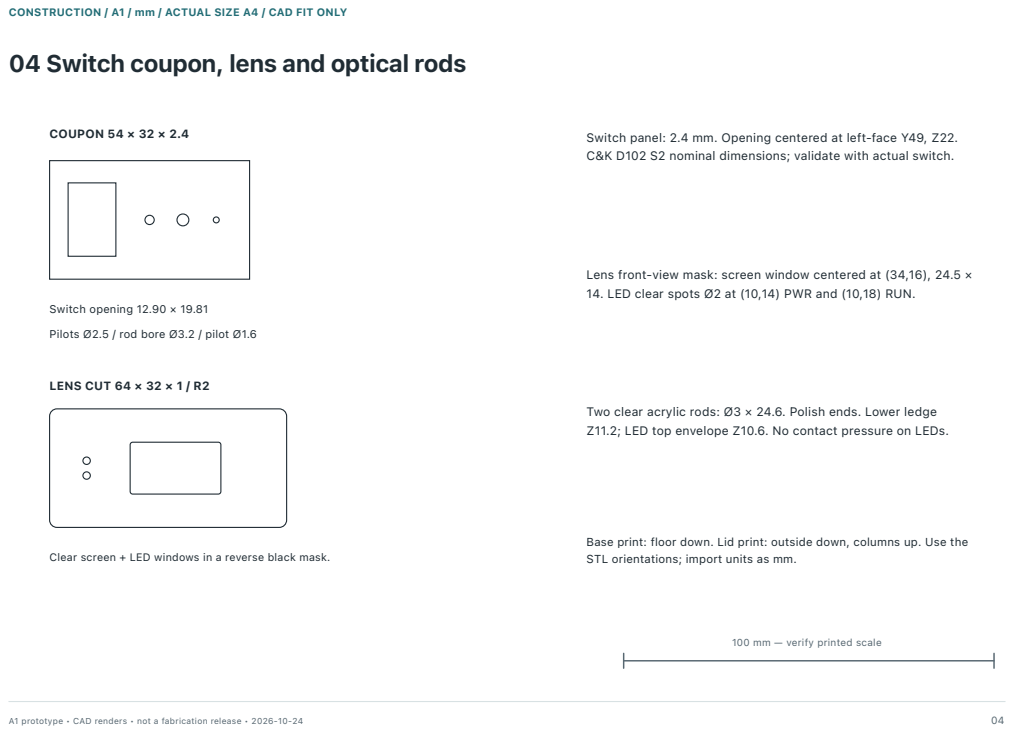
[picture p84: page 1]
A1 prototype • CAD renders • not a fabrication release • 2026-10-24; COUPON 54 × 32 × 2.4; Switch opening 12.90 × 19.81; LENS CUT 64 × 32 × 1 / R2

CONSTRUCTION / A1 / mm / ACTUAL SIZE A4 / CAD FIT ONLY

Switch panel: 2.4 mm. Opening centered at left-face Y49, Z22.
C&K D102 S2 nominal dimensions; validate with actual switch.

Lens front-view mask: screen window centered at (34,16), 24.5 ×
14. LED clear spots Ø2 at (10,14) PWR and (10,18) RUN.

Pilots Ø2.5 / rod bore Ø3.2 / pilot Ø1.6

Two clear acrylic rods: Ø3 × 24.6. Polish ends. Lower ledge
Z11.2; LED top envelope Z10.6. No contact pressure on LEDs.

Base print: floor down. Lid print: outside down, columns up. Use the
STL orientations; import units as mm.

Clear screen + LED windows in a reverse black mask.

100 mm — verify printed scale
