sergiogallegos/tinyplc/hardware/prototype-a1/electronics/tinyplc-a1-layout.pdf

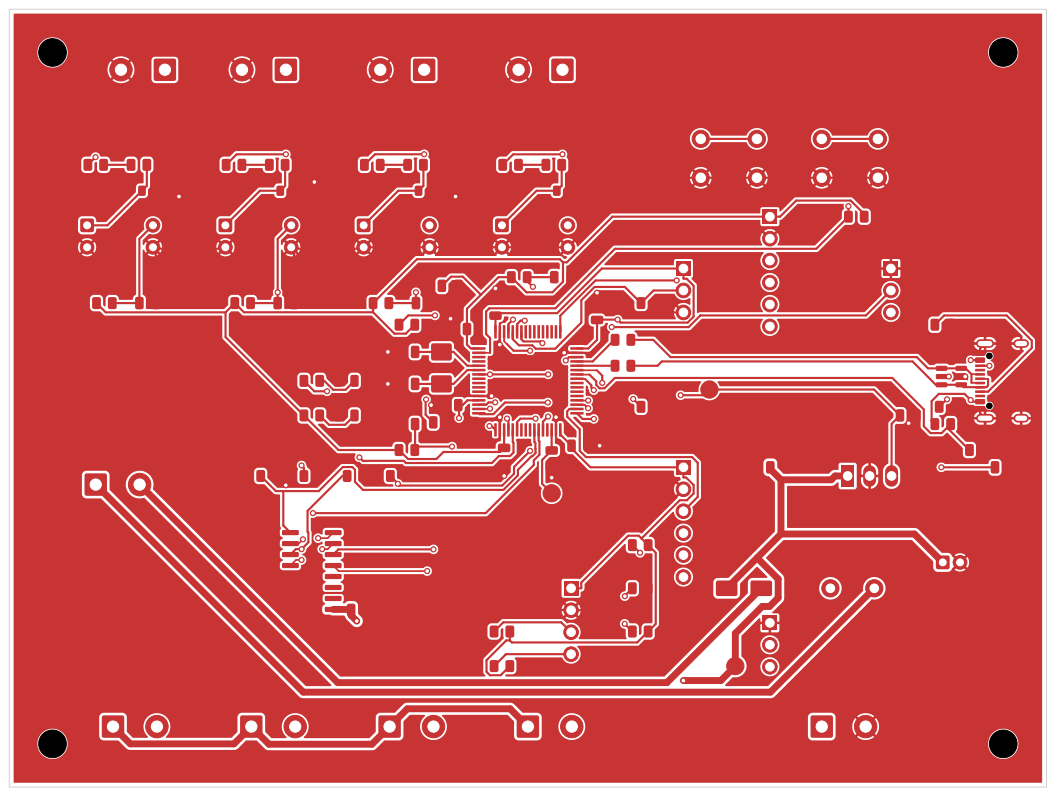
[picture p85: page 1]

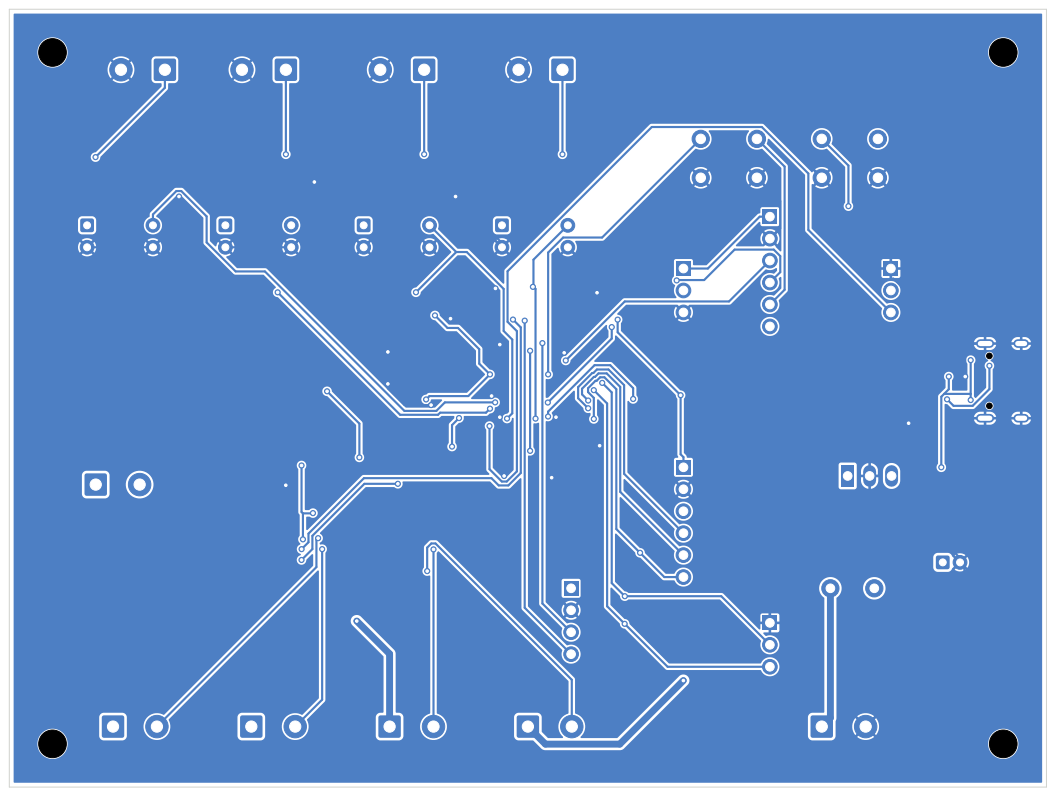
[picture p86: page 2]

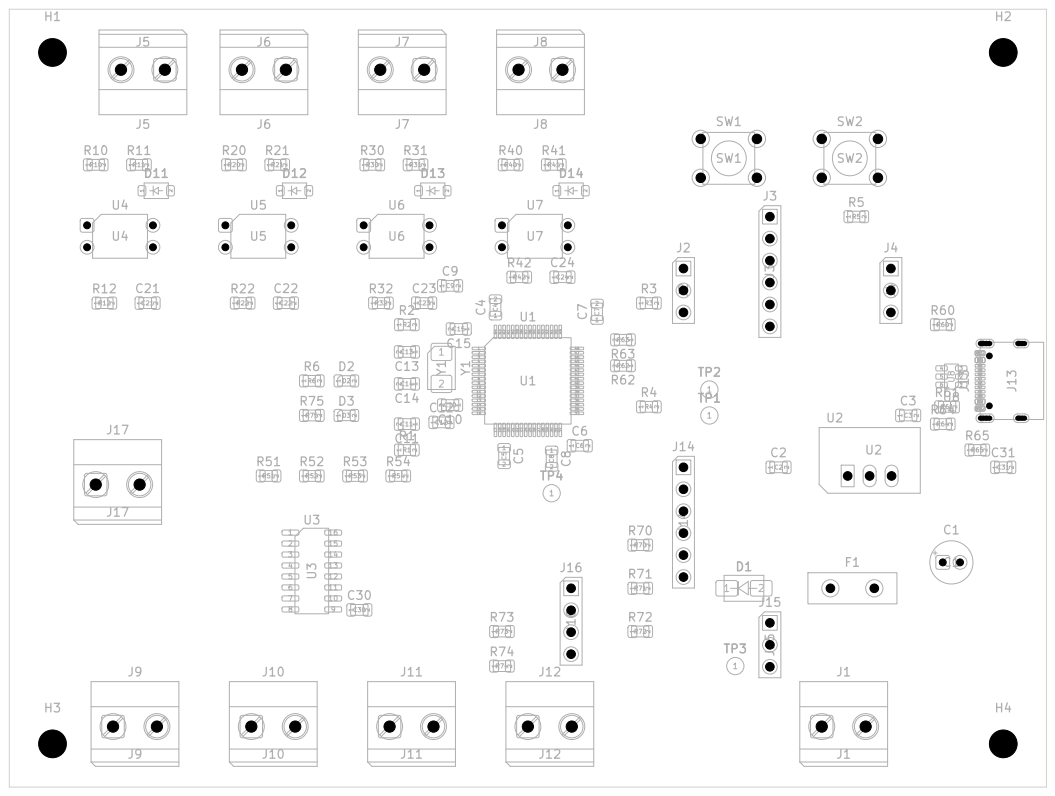
[picture p87: page 3]
