sergiogallegos/tinyplc/(list of files, drawings)

Other design files:
hardware/prototype-a1/electronics/routing/tinyplc-a1.dsn
