sergiogallegos/tinyplc/hardware/prototype-a/electronics/tinyplc-a0.kicad_pcb

## KiCad design hardware/prototype-a/electronics/tinyplc-a0.kicad_pcb (2026-10-25)

Schematic: tinyplc-a0.kicad_sch, tinyPLC A0 - electrical prototype draft

Parts:
C1: 22uF / 50V; CP_Radial_D6.3mm_P2.50mm; MPN Panasonic EEU-FR1H220
C2, C4, C5, C6, C7, C10, C12, C30, C31: 100nF / 50V; C_0805_2012Metric; MPN TDK C2012 family; exact MPN pending
C3: 10uF / 10V; C_0805_2012Metric; MPN TDK C2012 family; exact MPN pending
C8, C9: 4.7uF / 10V; C_0805_2012Metric; MPN TDK C2012 family; exact MPN pending
C11: 1uF / 10V; C_0805_2012Metric; MPN TDK C2012 family; exact MPN pending
C13, C14: 27pF C0G / 50V; C_0805_2012Metric; MPN TDK C2012 family; exact MPN pending
C21, C22, C23, C24: 10nF / 50V; C_0805_2012Metric; MPN TDK C2012 family; exact MPN pending
D1: SS16; D_SMA; MPN SS16
D2: GREEN; LED_0805_2012Metric; MPN Kingbright KP-2012SGC
D11, D12, D13, D14: 1N4148W; D_SOD-123; MPN 1N4148W
F1: 500mA / 60V; PTC_MF_R050; MPN MF-R050
H1, H2, H3, H4: M3 NPTH; MountingHole_3.2mm_M3; MPN No purchased component
J1: 24V IN / GND; TerminalBlock_Phoenix_MKDS-1,5-2-5.08_1x02_P5.08mm_Horizont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; MPN 1715721
J2: BOOT: 1=3V3 2=BOOT0 3=GND; PinHeader_1x03_P2.54mm_Vertical; MPN Samtec TSW-103-07-G-S
J3: SWD: 3V3 GND DIO CLK NRST SWO; PinHeader_1x06_P2.54mm_Vertical; MPN Samtec TSW-106-07-G-S
J4: UART: GND TX RX; PinHeader_1x03_P2.54mm_Vertical; MPN Samtec TSW-103-07-G-S
J5: DI1 / GND; TerminalBlock_Phoenix_MKDS-1,5-2-5.08_1x02_P5.08mm_Horizont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; MPN 1715721
J6: DI2 / GND; TerminalBlock_Phoenix_MKDS-1,5-2-5.08_1x02_P5.08mm_Horizont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; MPN 1715721
J7: DI3 / GND; TerminalBlock_Phoenix_MKDS-1,5-2-5.08_1x02_P5.08mm_Horizont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; MPN 1715721
J8: DI4 / GND; TerminalBlock_Phoenix_MKDS-1,5-2-5.08_1x02_P5.08mm_Horizont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; MPN 1715721
J9: +24 / Q1 sink; TerminalBlock_Phoenix_MKDS-1,5-2-5.08_1x02_P5.08mm_Horizont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; MPN 1715721
J10: +24 / Q2 sink; TerminalBlock_Phoenix_MKDS-1,5-2-5.08_1x02_P5.08mm_Horizont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; MPN 1715721
J11: +24 / Q3 sink; TerminalBlock_Phoenix_MKDS-1,5-2-5.08_1x02_P5.08mm_Horizont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; MPN 1715721
J12: +24 / Q4 sink; TerminalBlock_Phoenix_MKDS-1,5-2-5.08_1x02_P5.08mm_Horizont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; MPN 1715721
J13: USB-C DEVICE; USB_C_Receptacle_GCT_USB4105-xx-A_16P_TopMnt_Horizontal; MPN USB4105-GF-A-120
J14: SPI: 3V3 GND SCK MISO MOSI CS; PinHeader_1x06_P2.54mm_Vertical; MPN Samtec TSW-106-07-G-S
J15: ETH: GND RST INT; PinHeader_1x03_P2.54mm_Vertical; MPN Samtec TSW-103-07-G-S
J16: OLED: 3V3 GND SCL SDA; PinHeader_1x04_P2.54mm_Vertical; MPN Samtec TSW-104-07-G-S
R1, R62, R63: 22; R_0805_2012Metric; MPN ERJ-6ENF22R0V
R2, R3, R4, R5, R12, R22, R32, R42, R70, R71, R72: 10k; R_0805_2012Metric; MPN ERJ-6ENF1002V
R6: 1k; R_0805_2012Metric; MPN ERJ-6ENF1001V
R10, R11, R20, R21, R30, R31, R40, R41: 2.2k; R_0805_2012Metric; MPN ERJ-6ENF2201V
R51, R52, R53, R54, R65: 100k; R_0805_2012Metric; MPN ERJ-6ENF1003V
R60, R61: 5.1k; R_0805_2012Metric; MPN ERJ-6ENF5101V
R64: 68k; R_0805_2012Metric; MPN ERJ-6ENF6802V
R73, R74: 4.7k; R_0805_2012Metric; MPN ERJ-6ENF4701V
SW1: RESET; SW_PUSH_6mm; MPN Omron B3F-1000
SW2: USER; SW_PUSH_6mm; MPN Omron B3F-1000
TP1: GND; TestPoint_Pad_D2.0mm; MPN Bare PCB test pad
TP2: +3V3; TestPoint_Pad_D2.0mm; MPN Bare PCB test pad
TP3: V24; TestPoint_Pad_D2.0mm; MPN Bare PCB test pad
TP4: VCAP1; TestPoint_Pad_D2.0mm; MPN Bare PCB test pad
U1: STM32F446RET6; LQFP-64_10x10mm_P0.5mm; MPN STM32F446RET6
U2: TSR 1-2433; Converter_DCDC_TRACO_TSR-1_THT; MPN TSR 1-2433
U3: TPL7407LDR; SOIC-16_3.9x9.9mm_P1.27mm; MPN TPL7407LDR
U4, U5, U6, U7: VO617A-3; DIP-4_W7.62mm; MPN VO617A-3
U8: USBLC6-2SC6; SOT-23-6; MPN USBLC6-2SC6
Y1: 8MHz CL18pF; Crystal_SMD_5032-2Pin_5.0x3.2mm; MPN ABM3-8.000MHZ-B2-T

Connections:
/+3V3: C3.1, C4.1, C5.1, C6.1, C7.1, C9.1, J2.1, J3.1, J14.1, J16.1, R1.1, R2.2, R5.2, R12.1, R22.1, R32.1, R42.1, R70.2, R72.2, R73.2, R74.2, TP2.1, U1.1 (VBAT), U1.19 (VDD), U1.32 (VDD), U1.48 (VDD), U1.64 (VDD), U2.3 (3V3)
/BOOT0: J2.2, R3.1, U1.60 (BOOT0)
/BOOT1: R4.1, U1.28 (PB2)
/BTN_N: R5.1, SW2.1, U1.2 (PC13)
/CC1: J13.A5 (CC1), R60.1
/CC2: J13.B5 (CC2), R61.1
/DI1_24: J5.1, R10.1
/DI1_A: D11.1 (K), R11.2, U4.1
/DI1_MID: R10.2, R11.1
/DI1_N: C21.1, R12.2, U1.14 (PA0), U4.4
/DI2_24: J6.1, R20.1
/DI2_A: D12.1 (K), R21.2, U5.1
/DI2_MID: R20.2, R21.1
/DI2_N: C22.1, R22.2, U1.15 (PA1), U5.4
/DI3_24: J7.1, R30.1
/DI3_A: D13.1 (K), R31.2, U6.1
/DI3_MID: R30.2, R31.1
/DI3_N: C23.1, R32.2, U1.20 (PA4), U6.4
/DI4_24: J8.1, R40.1
/DI4_A: D14.1 (K), R41.2, U7.1
/DI4_MID: R40.2, R41.1
/DI4_N: C24.1, R42.2, U1.22 (PA6), U7.4
/DO1: R51.1, U1.26 (PB0), U3.1 (IN1)
/DO2: R52.1, U1.27 (PB1), U3.2 (IN2)
/DO3: R53.1, U1.61 (PB8), U3.3 (IN3)
/DO4: R54.1, U1.62 (PB9), U3.4 (IN4)
/ETH_CS_N: J14.6, R70.1, U1.33 (PB12)
/ETH_INT_N: J15.3, R72.1, U1.41 (PA8)
/ETH_RST_N: J15.2, R71.1, U1.43 (PA10)
/GND: C1.2, C2.2, C3.2, C4.2, C5.2, C6.2, C7.2, C8.2, C9.2, C10.2, C11.2, C12.2, C13.2, C14.2, C21.2, C22.2, C23.2, C24.2, C30.2, C31.2, D2.1 (K), D11.2 (A), D12.2 (A), D13.2 (A), D14.2 (A), J1.2, J2.3, J3.2, J4.1, J5.2, J6.2, J7.2, J8.2, J13.A1 (GND), J13.A12 (GND), J13.B1 (GND), J13.B12 (GND), J13.SH (SHIELD), J14.2, J15.1, J16.2, R3.2, R4.2, R51.2, R52.2, R53.2, R54.2, R60.2, R61.2, R65.2, R71.2, SW1.2, SW2.2, TP1.1, U1.12 (VSSA), U1.18 (VSS), U1.31 (VSS), U1.47 (VSS), U1.63 (VSS), U2.2 (GND), U3.5 (IN5), U3.6 (IN6), U3.7 (IN7), U3.8 (GND), U4.2, U4.3, U5.2, U5.3, U6.2, U6.3, U7.2, U7.3, U8.2 (GND)
/I2C_SCL: J16.3, R73.1, U1.58 (PB6)
/I2C_SDA: J16.4, R74.1, U1.59 (PB7)
/LED_A: D2.2 (A), R6.2
/NRST: C12.1, J3.5, R2.1, SW1.1, U1.7 (NRST)
/OSC_IN: C13.1, U1.5 (PH0), Y1.1
/OSC_OUT: C14.1, U1.6 (PH1), Y1.2
/Q1: J9.2, U3.16 (OUT1)
/Q2: J10.2, U3.15 (OUT2)
/Q3: J11.2, U3.14 (OUT3)
/Q4: J12.2, U3.13 (OUT4)
/SPI2_MISO: J14.4, U1.35 (PB14)
/SPI2_MOSI: J14.5, U1.36 (PB15)
/SPI2_SCK: J14.3, U1.34 (PB13)
/STATUS_LED: R6.1, U1.21 (PA5)
/SWCLK: J3.4, U1.49 (PA14)
/SWDIO: J3.3, U1.46 (PA13)
/UART_RX: J4.3, U1.17 (PA3)
/UART_TX: J4.2, U1.16 (PA2)
/USB_DM: R62.2, U1.44 (PA11)
/USB_DM_CONN: J13.A7 (D-), J13.B7 (D-), R62.1, U8.1 (I/O1), U8.6 (I/O1)
/USB_DP: R63.2, U1.45 (PA12)
/USB_DP_CONN: J13.A6 (D+), J13.B6 (D+), R63.1, U8.3 (I/O2), U8.4 (I/O2)
/USB_VBUS_SENSE: R64.2, R65.1, U1.42 (PA9)
/V24: C1.1, C2.1, C30.1, D1.1 (K), J9.1, J10.1, J11.1, J12.1, TP3.1, U2.1 (VIN), U3.9 (COM)
/VBUS_USB: C31.1, J13.A4 (VBUS), J13.A9 (VBUS), J13.B4 (VBUS), J13.B9 (VBUS), R64.1, U8.5 (VBUS)
/VCAP1: C8.1, TP4.1, U1.30 (VCAP_1)
/VDDA: C10.1, C11.1, R1.2, U1.13 (VDDA)
/VIN24: F1.1, J1.1
/VIN_FUSED: D1.2 (A), F1.2

Notes on the sheet:
A0 ENGINEERING DRAFT - net labels connect equal names; NC crosses mark intentionally unused pins
Native USB / Ethernet / OLED need new firmware. PCB is deliberately unrouted. No verified electrical ratings yet.
POWER
MCU
INPUT 1
INPUT 2
INPUT 3
INPUT 4
OUTPUTS
USB
EXPANSION
TEST POINTS
MOUNTING

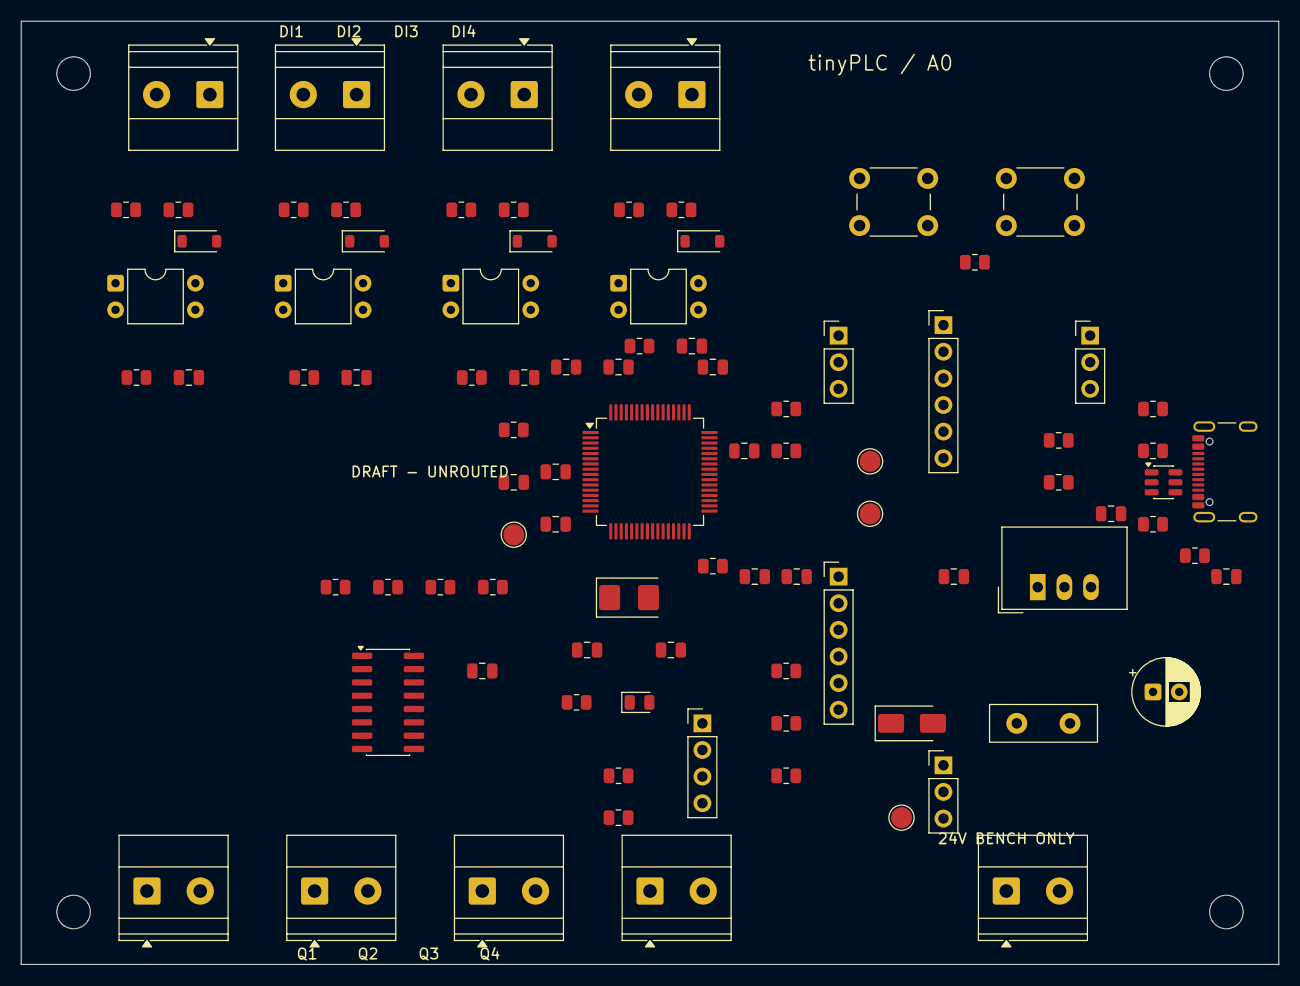
[picture p88: board tinyplc-a0.kicad_pcb from above]

Board: 2 copper layers, 120.0 x 90.0 mm, 95 parts (0 on the bottom side), 59 nets, no tracks yet.
