sergiogallegos/tinyplc/(commit log)

2026-10-01 docs: tighten runtime ownership and milestone acceptance gates
2026-10-01 Define native ABI and pin MPU port integration plan
2026-10-01 Implement native STM32 scan supervision and verify R2.3–R2.5 on hardware
2026-10-01 Implement protected native downloads and activation through R3.3
    Complete native MPU isolation, deadline supervision, and fixed A/B placement. Add the generated wire contract, Rust packager and serial CLI, bounded C loader, and scan-boundary activation. Include host regressions, hardware fault and 64-tag evidence, and architecture documentation.
    [board_check.py, build_target.py, check_loader_target.py, engineering_board.c]
2026-10-03 Add native TON timers with TIME support and board acceptance
2026-10-03 Document ST board workflow and TON support
2026-10-25 Add routed A1 PLC prototype, enclosure, and illustrated build documentation
    Preserve the A0 design and add the A1 KiCad board, FreeCAD enclosure, Blender views, BOMs, assembly drawings, and product brochure. Document routing decisions and native CAD verification; add product views to the main README.
2026-10-25 docs: add A1 prototype completion checklist
